BenskiBoy/scamp-32/(list of files, drawings)

Other design files:
logisim/scampplusplus.circ
