BenskiBoy/scamp-32/kicad/scamp32-memory/scamp32-memory.kicad_pcb

## KiCad design kicad/scamp32-memory/scamp32-memory.kicad_pcb (2026-10-10)

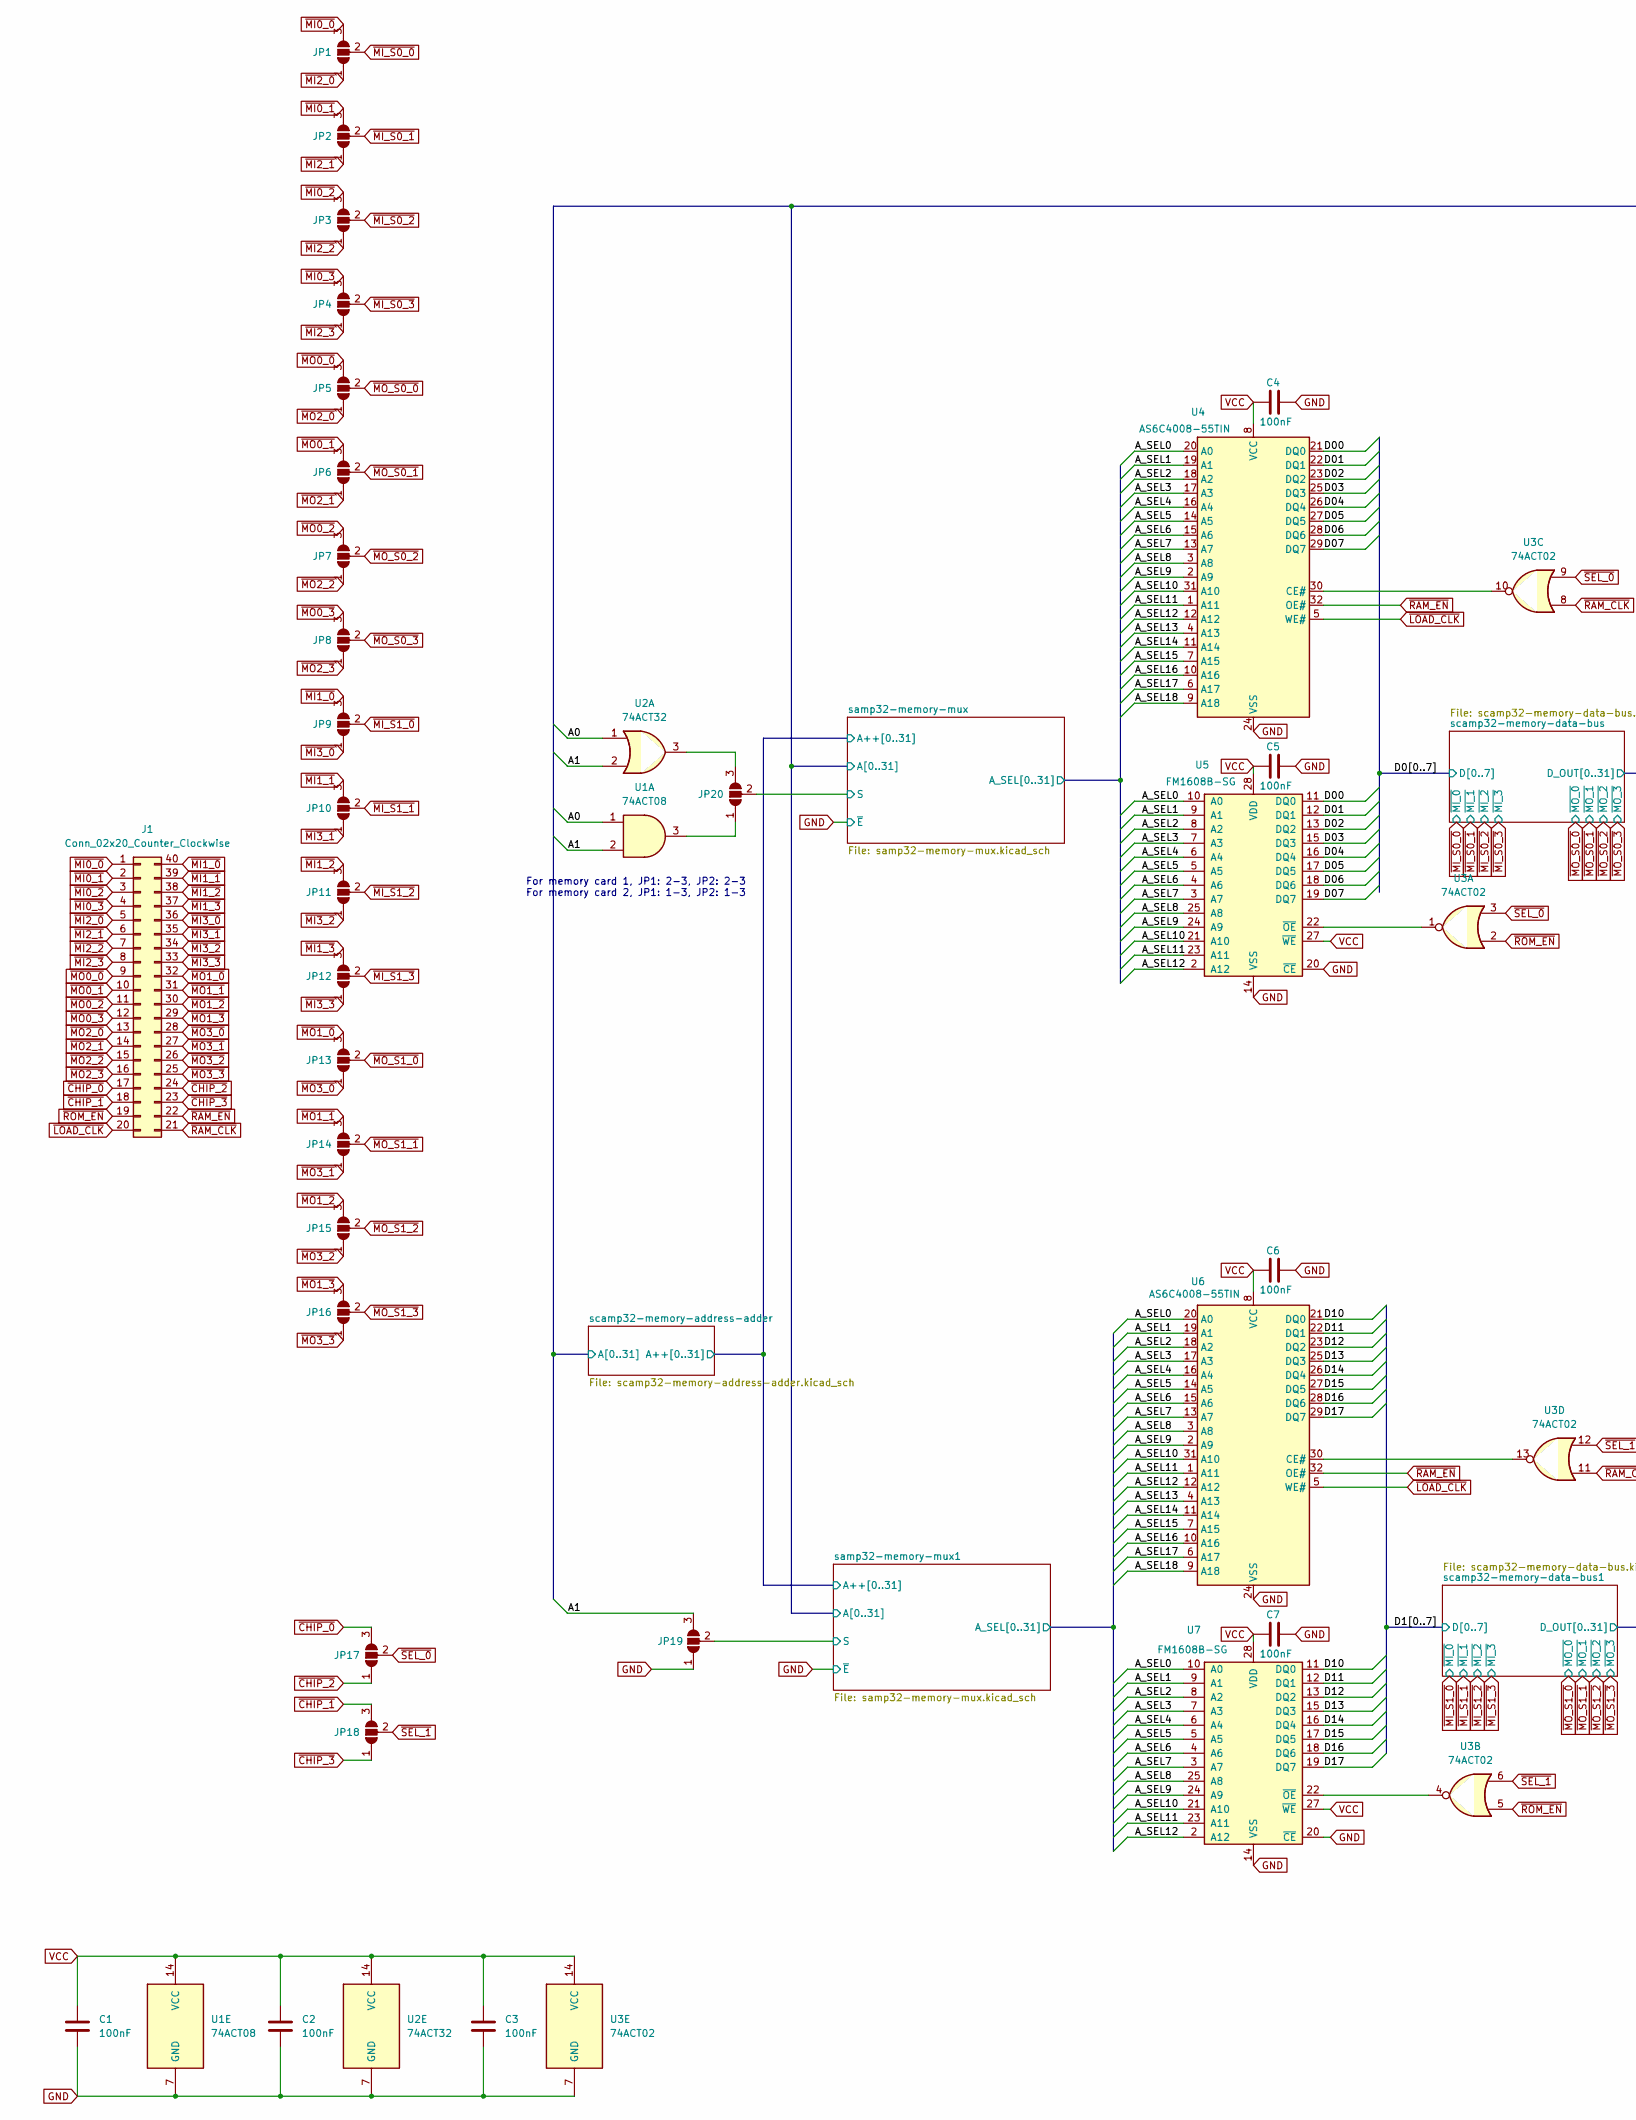
[picture p1: schematic scamp32-memory.kicad_sch, part in row 1, column 1]

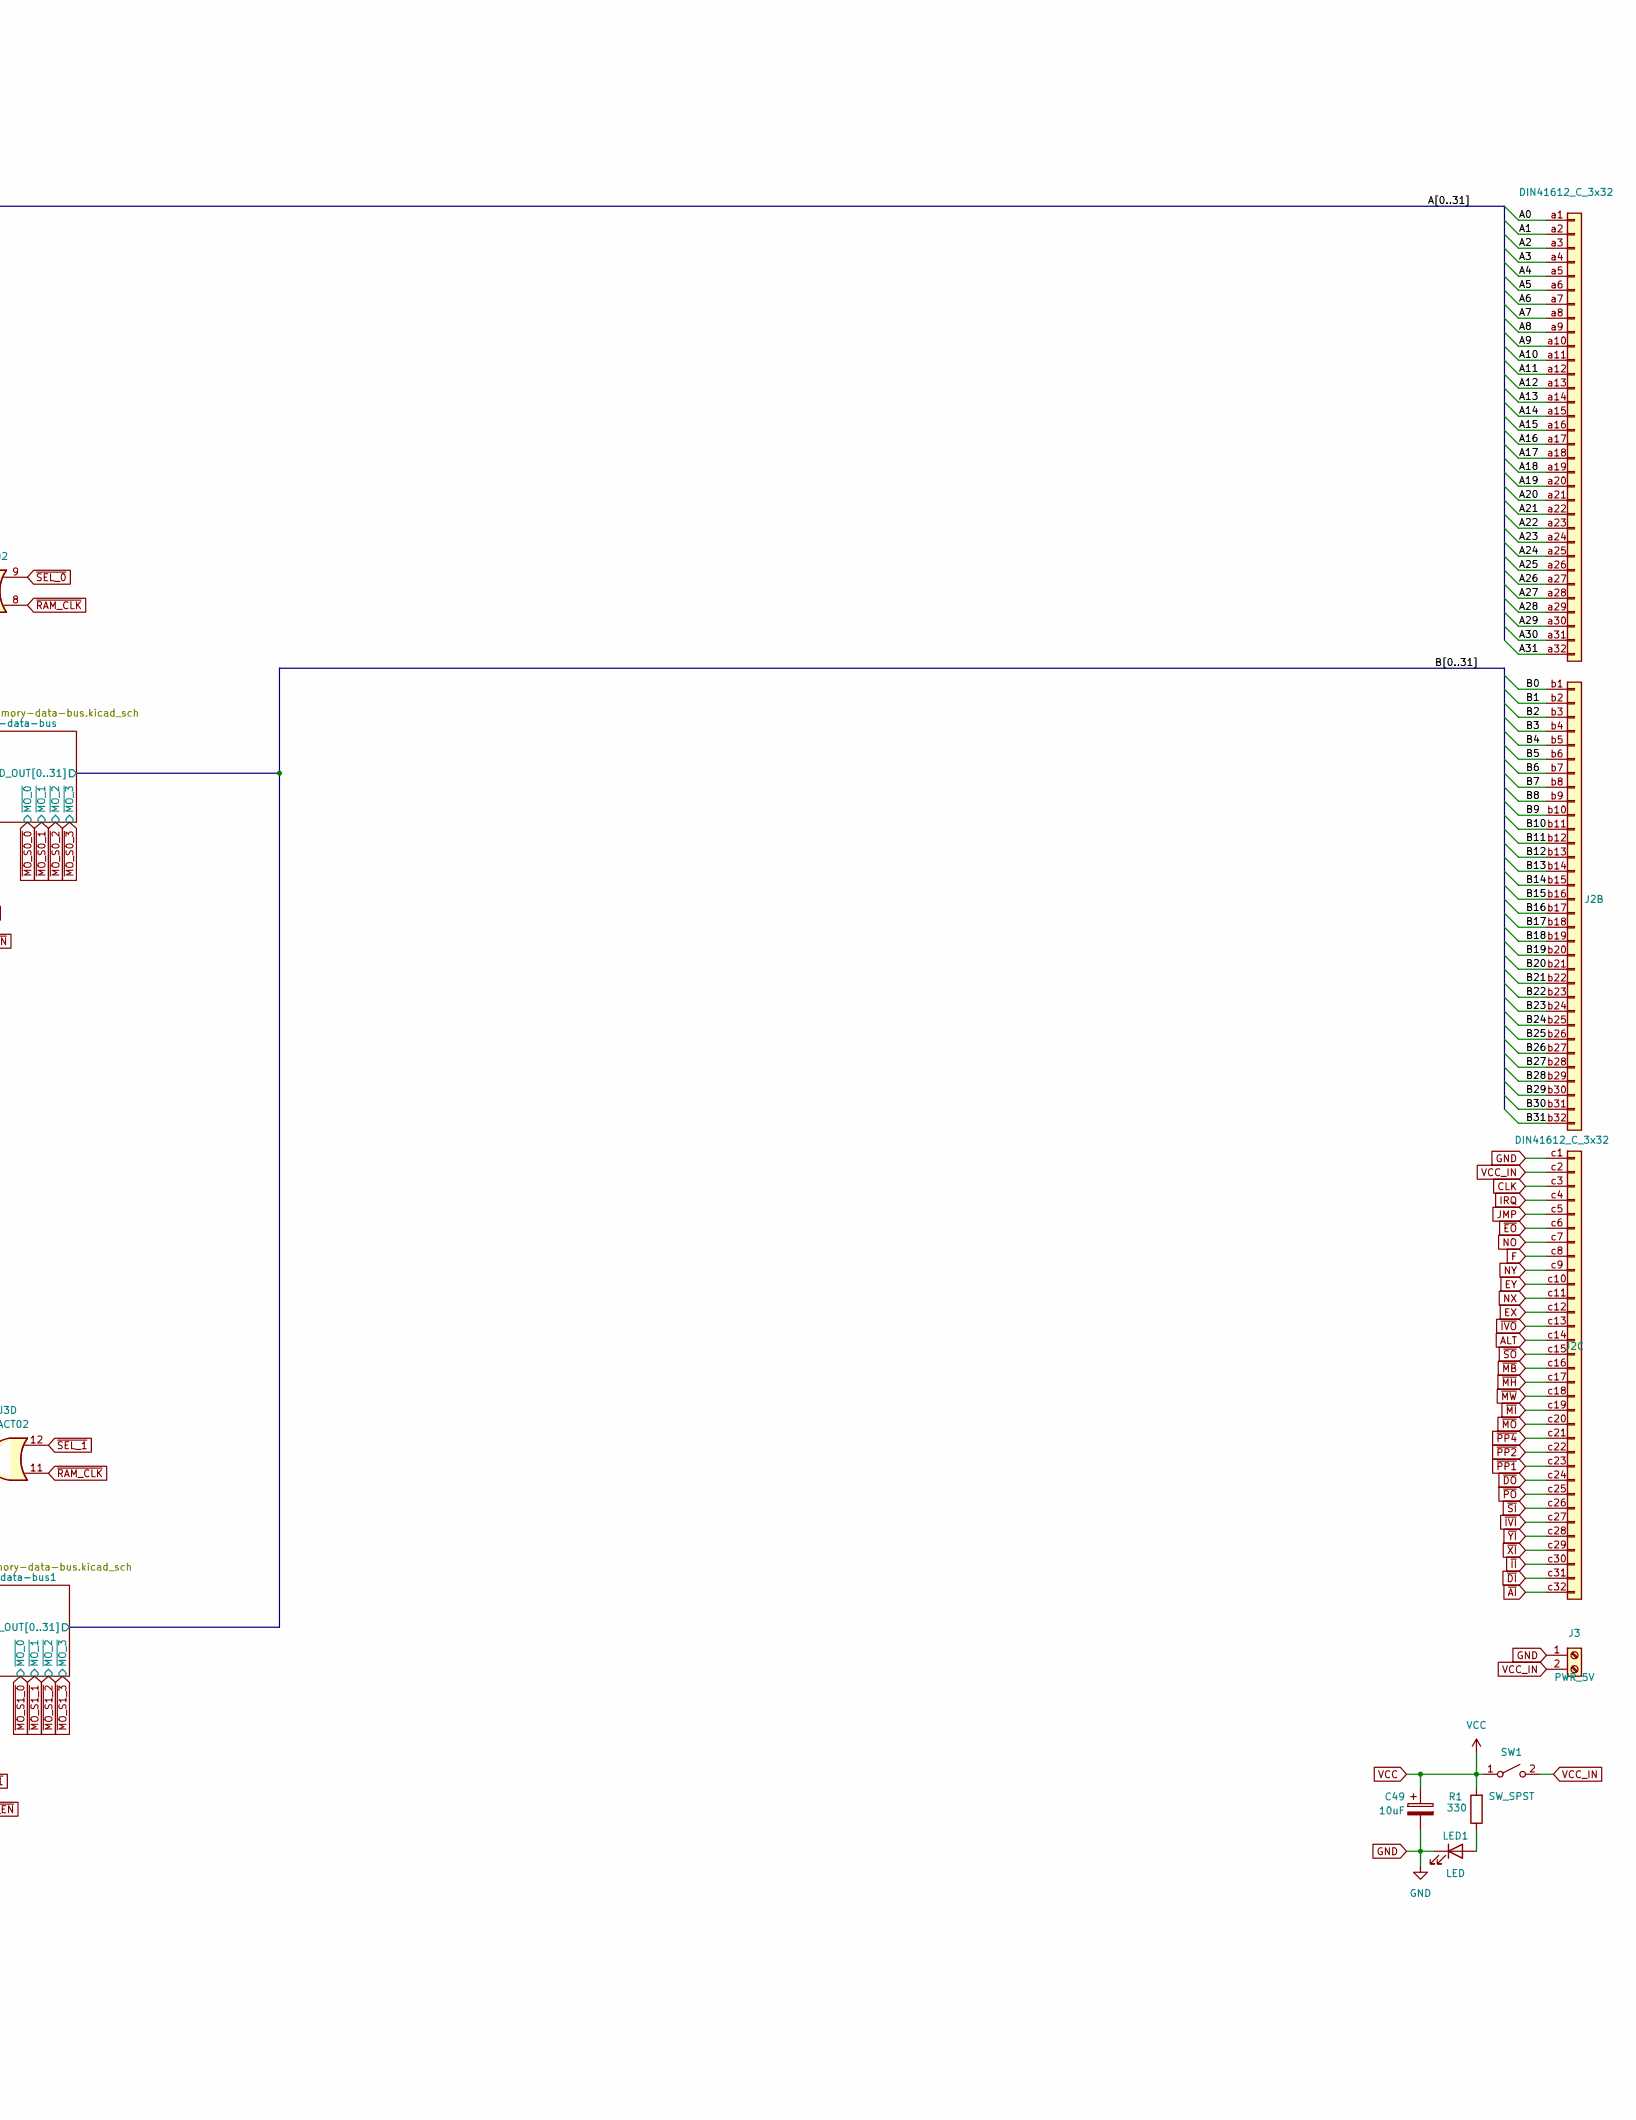
[picture p2: schematic scamp32-memory.kicad_sch, part in row 1, column 2]

Parts:
C1, C2, C3, C4, C5, C6, C7: 100nF; C_0603_1608Metric
C49: 10uF; CP_Radial_D5.0mm_P2.00mm
J1: Conn_02x20_Counter_Clockwise; IDC-Header_2x20_P2.54mm_Horizontal
J2: DIN41612_C_3x32; DIN41612_C_3x32_Male_Horizontal_THT
J3: PWR_5V; TerminalBlock_Phoenix_MKDS-1,5-2-5.08_1x02_P5.08mm_Horizont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
JP1, JP2, JP3, JP4, JP5, JP6, JP7, JP8, JP9, JP10, JP11, JP12, JP13, JP14, JP15, JP16, JP17, JP18, JP19, JP20: SolderJumper_3_Open; SolderJumper-3_P1.3mm_Open_RoundedPad1.0x1.5mm_NumberLabels
LED1: LED; LED_0805_2012Metric
R1: 330; R_0805_2012Metric
SW1: SW_SPST; SW_Slide_SPDT_Straight_CK_OS102011MS2Q
U1: 74ACT08; TSSOP-14_4.4x5mm_P0.65mm
U2: 74ACT32; SOIC-14_3.9x8.7mm_P1.27mm
U3: 74ACT02; TSSOP-14_4.4x5mm_P0.65mm
U4, U6: AS6C4008-55TIN; TSOP-I-32_18.4x8mm_P0.5mm
U5, U7: FM1608B-SG; DIP_Socket-28_W11.9mm_W12.7mm_W15.24mm_W17.78mm_W18.5mm_3M_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

Connections:
/A0: J2.a1, U1.1, U2.1; also elsewhere on the board
/A1: J2.a2, JP19.3 (B), U1.2, U2.2; also elsewhere on the board
/A2: J2.a3; also elsewhere on the board
/A3: J2.a4; also elsewhere on the board
/A4: J2.a5; also elsewhere on the board
/A5: J2.a6; also elsewhere on the board
/A6: J2.a7; also elsewhere on the board
/A7: J2.a8; also elsewhere on the board
/A8: J2.a9; also elsewhere on the board
/A9: J2.a10; also elsewhere on the board
/A10: J2.a11; also elsewhere on the board
/A11: J2.a12; also elsewhere on the board
/A12: J2.a13; also elsewhere on the board
/A13: J2.a14; also elsewhere on the board
/A14: J2.a15; also elsewhere on the board
/A15: J2.a16; also elsewhere on the board
/A16: J2.a17; also elsewhere on the board
/A17: J2.a18; also elsewhere on the board
/A18: J2.a19; also elsewhere on the board
/A19: J2.a20; also elsewhere on the board
/A20: J2.a21; also elsewhere on the board
/A21: J2.a22; also elsewhere on the board
/A22: J2.a23; also elsewhere on the board
/A23: J2.a24; also elsewhere on the board
/A24: J2.a25; also elsewhere on the board
/A25: J2.a26; also elsewhere on the board
/A26: J2.a27; also elsewhere on the board
/A27: J2.a28; also elsewhere on the board
/A28: J2.a29; also elsewhere on the board
/A29: J2.a30; also elsewhere on the board
/A30: J2.a31; also elsewhere on the board
/A31: J2.a32; also elsewhere on the board
/B0: J2.b1; also elsewhere on the board
/B1: J2.b2; also elsewhere on the board
/B2: J2.b3; also elsewhere on the board
/B3: J2.b4; also elsewhere on the board
/B4: J2.b5; also elsewhere on the board
/B5: J2.b6; also elsewhere on the board
/B6: J2.b7; also elsewhere on the board
/B7: J2.b8; also elsewhere on the board
/B8: J2.b9; also elsewhere on the board
/B9: J2.b10; also elsewhere on the board
/B10: J2.b11; also elsewhere on the board
/B11: J2.b12; also elsewhere on the board
/B12: J2.b13; also elsewhere on the board
/B13: J2.b14; also elsewhere on the board
/B14: J2.b15; also elsewhere on the board
/B15: J2.b16; also elsewhere on the board
/B16: J2.b17; also elsewhere on the board
/B17: J2.b18; also elsewhere on the board
/B18: J2.b19; also elsewhere on the board
/B19: J2.b20; also elsewhere on the board
/B20: J2.b21; also elsewhere on the board
/B21: J2.b22; also elsewhere on the board
/B22: J2.b23; also elsewhere on the board
/B23: J2.b24; also elsewhere on the board
/B24: J2.b25; also elsewhere on the board
/B25: J2.b26; also elsewhere on the board
/B26: J2.b27; also elsewhere on the board
/B27: J2.b28; also elsewhere on the board
/B28: J2.b29; also elsewhere on the board
/B29: J2.b30; also elsewhere on the board
/B30: J2.b31; also elsewhere on the board
/B31: J2.b32; also elsewhere on the board
/D00: U4.21 (DQ0), U5.11 (DQ0); also elsewhere on the board
/D01: U4.22 (DQ1), U5.12 (DQ1); also elsewhere on the board
/D02: U4.23 (DQ2), U5.13 (DQ2); also elsewhere on the board
/D03: U4.25 (DQ3), U5.15 (DQ3); also elsewhere on the board
/D04: U4.26 (DQ4), U5.16 (DQ4); also elsewhere on the board
/D05: U4.27 (DQ5), U5.17 (DQ5); also elsewhere on the board
/D06: U4.28 (DQ6), U5.18 (DQ6); also elsewhere on the board
/D07: U4.29 (DQ7), U5.19 (DQ7); also elsewhere on the board
/D10: U6.21 (DQ0), U7.11 (DQ0); also elsewhere on the board
/D11: U6.22 (DQ1), U7.12 (DQ1); also elsewhere on the board
/D12: U6.23 (DQ2), U7.13 (DQ2); also elsewhere on the board
/D13: U6.25 (DQ3), U7.15 (DQ3); also elsewhere on the board
/D14: U6.26 (DQ4), U7.16 (DQ4); also elsewhere on the board
/D15: U6.27 (DQ5), U7.17 (DQ5); also elsewhere on the board
/D16: U6.28 (DQ6), U7.18 (DQ6); also elsewhere on the board
/D17: U6.29 (DQ7), U7.19 (DQ7); also elsewhere on the board
/samp32-memory-mux1/S: JP19.2 (C); also elsewhere on the board
/samp32-memory-mux/A_SEL0: U4.20 (A0), U5.10 (A0), U6.20 (A0), U7.10 (A0); also elsewhere on the board
/samp32-memory-mux/A_SEL1: U4.19 (A1), U5.9 (A1), U6.19 (A1), U7.9 (A1); also elsewhere on the board
/samp32-memory-mux/A_SEL2: U4.18 (A2), U5.8 (A2), U6.18 (A2), U7.8 (A2); also elsewhere on the board
/samp32-memory-mux/A_SEL3: U4.17 (A3), U5.7 (A3), U6.17 (A3), U7.7 (A3); also elsewhere on the board
/samp32-memory-mux/A_SEL4: U4.16 (A4), U5.6 (A4), U6.16 (A4), U7.6 (A4); also elsewhere on the board
/samp32-memory-mux/A_SEL5: U4.14 (A5), U5.5 (A5), U6.14 (A5), U7.5 (A5); also elsewhere on the board
/samp32-memory-mux/A_SEL6: U4.15 (A6), U5.4 (A6), U6.15 (A6), U7.4 (A6); also elsewhere on the board
/samp32-memory-mux/A_SEL7: U4.13 (A7), U5.3 (A7), U6.13 (A7), U7.3 (A7); also elsewhere on the board
/samp32-memory-mux/A_SEL8: U4.3 (A8), U5.25 (A8), U6.3 (A8), U7.25 (A8); also elsewhere on the board
/samp32-memory-mux/A_SEL9: U4.2 (A9), U5.24 (A9), U6.2 (A9), U7.24 (A9); also elsewhere on the board
/samp32-memory-mux/A_SEL10: U4.31 (A10), U5.21 (A10), U6.31 (A10), U7.21 (A10); also elsewhere on the board
/samp32-memory-mux/A_SEL11: U4.1 (A11), U5.23 (A11), U6.1 (A11), U7.23 (A11); also elsewhere on the board
/samp32-memory-mux/A_SEL12: U4.12 (A12), U5.2 (A12), U6.12 (A12), U7.2 (A12); also elsewhere on the board
/samp32-memory-mux/A_SEL13: U4.4 (A13), U6.4 (A13); also elsewhere on the board
/samp32-memory-mux/A_SEL14: U4.11 (A14), U6.11 (A14); also elsewhere on the board
/samp32-memory-mux/A_SEL15: U4.7 (A15), U6.7 (A15); also elsewhere on the board
/samp32-memory-mux/A_SEL16: U4.10 (A16), U6.10 (A16); also elsewhere on the board
/samp32-memory-mux/A_SEL17: U4.6 (A17), U6.6 (A17); also elsewhere on the board
/samp32-memory-mux/A_SEL18: U4.9 (A18), U6.9 (A18); also elsewhere on the board
/samp32-memory-mux/S: JP20.2 (C); also elsewhere on the board
ALT: J2.c14
CLK: J2.c3
EX: J2.c12
EY: J2.c10
F: J2.c8
GND: C1.2, C2.2, C3.2, C4.2, C5.2, C6.2, C7.2, C49.2, J2.c1, J3.1, JP19.1 (A), LED1.1 (K), U1.7 (GND), U2.7 (GND), U3.7 (GND), U4.24 (VSS), U5.14 (VSS), U5.20 (~CE), U6.24 (VSS), U7.14 (VSS), U7.20 (~CE); also elsewhere on the board
IRQ: J2.c4
JMP: J2.c5
NO: J2.c7
NX: J2.c11
NY: J2.c9
unnamed: JP20.1 (A), U1.3
unnamed: JP20.3 (B), U2.3
unnamed: LED1.2 (A), R1.1
unnamed: U3.10, U4.30 (CE#)
unnamed: U3.1, U5.22 (~OE)
unnamed: U3.13, U6.30 (CE#)
unnamed: U3.4, U7.22 (~OE)
VCC: C1.1, C2.1, C3.1, C4.1, C5.1, C6.1, C7.1, C49.1, R1.2, SW1.1 (A), U1.14 (VCC), U2.14 (VCC), U3.14 (VCC), U4.8 (VCC), U5.27 (~WE), U5.28 (VDD), U6.8 (VCC), U7.27 (~WE), U7.28 (VDD); also elsewhere on the board
VCC_IN: J2.c2, J3.2, SW1.2 (B)
~AI: J2.c32
~CHIP_0: J1.17, JP17.3 (B)
~CHIP_1: J1.18, JP18.3 (B)
~CHIP_2: J1.24, JP17.1 (A)
~CHIP_3: J1.23, JP18.1 (A)
~DI: J2.c31
~DO: J2.c24
~EO: J2.c6
~II: J2.c30
~IVI: J2.c27
~IVO: J2.c13
~LOAD_CLK: J1.20, U4.5 (WE#), U6.5 (WE#)
~MB: J2.c16
~MH: J2.c17
~MI0_0: J1.1, JP1.3 (B)
~MI0_1: J1.2, JP2.3 (B)
~MI0_2: J1.3, JP3.3 (B)
~MI0_3: J1.4, JP4.3 (B)
~MI1_0: J1.40, JP9.3 (B)
~MI1_1: J1.39, JP10.3 (B)
~MI1_2: J1.38, JP11.3 (B)
~MI1_3: J1.37, JP12.3 (B)
~MI2_0: J1.5, JP1.1 (A)
~MI2_1: J1.6, JP2.1 (A)
~MI2_2: J1.7, JP3.1 (A)
~MI2_3: J1.8, JP4.1 (A)
~MI3_0: J1.36, JP9.1 (A)
~MI3_1: J1.35, JP10.1 (A)
~MI3_2: J1.34, JP11.1 (A)
~MI3_3: J1.33, JP12.1 (A)
~MI_S0_0: JP1.2 (C); also elsewhere on the board
~MI_S0_1: JP2.2 (C); also elsewhere on the board
~MI_S0_2: JP3.2 (C); also elsewhere on the board
~MI_S0_3: JP4.2 (C); also elsewhere on the board
~MI_S1_0: JP9.2 (C); also elsewhere on the board
~MI_S1_1: JP10.2 (C); also elsewhere on the board
~MI_S1_2: JP11.2 (C); also elsewhere on the board
~MI_S1_3: JP12.2 (C); also elsewhere on the board
~MI: J2.c19
~MO0_0: J1.9, JP5.3 (B)
~MO0_1: J1.10, JP6.3 (B)
~MO0_2: J1.11, JP7.3 (B)
~MO0_3: J1.12, JP8.3 (B)
~MO1_0: J1.32, JP13.3 (B)
~MO1_1: J1.31, JP14.3 (B)
~MO1_2: J1.30, JP15.3 (B)
~MO1_3: J1.29, JP16.3 (B)
~MO2_0: J1.13, JP5.1 (A)
~MO2_1: J1.14, JP6.1 (A)
~MO2_2: J1.15, JP7.1 (A)
~MO2_3: J1.16, JP8.1 (A)
~MO3_0: J1.28, JP13.1 (A)
~MO3_1: J1.27, JP14.1 (A)
~MO3_2: J1.26, JP15.1 (A)
~MO3_3: J1.25, JP16.1 (A)
~MO_S0_0: JP5.2 (C); also elsewhere on the board
~MO_S0_1: JP6.2 (C); also elsewhere on the board
~MO_S0_2: JP7.2 (C); also elsewhere on the board
~MO_S0_3: JP8.2 (C); also elsewhere on the board
~MO_S1_0: JP13.2 (C); also elsewhere on the board
~MO_S1_1: JP14.2 (C); also elsewhere on the board
~MO_S1_2: JP15.2 (C); also elsewhere on the board
~MO_S1_3: JP16.2 (C); also elsewhere on the board
~MO: J2.c20
~MW: J2.c18
~PO: J2.c25
~PP1: J2.c23
~PP2: J2.c22
~PP4: J2.c21
~RAM_CLK: J1.21, U3.8, U3.11
~RAM_EN: J1.22, U4.32 (OE#), U6.32 (OE#)
~ROM_EN: J1.19, U3.2, U3.5
~SEL_0: JP17.2 (C), U3.3, U3.9
~SEL_1: JP18.2 (C), U3.6, U3.12
~SI: J2.c26
~SO: J2.c15
~XI: J2.c29
~YI: J2.c28

Notes on the sheet:
For memory card 1, JP1: 2-3, JP2: 2-3 For memory card 2, JP1: 1-3, JP2: 1-3

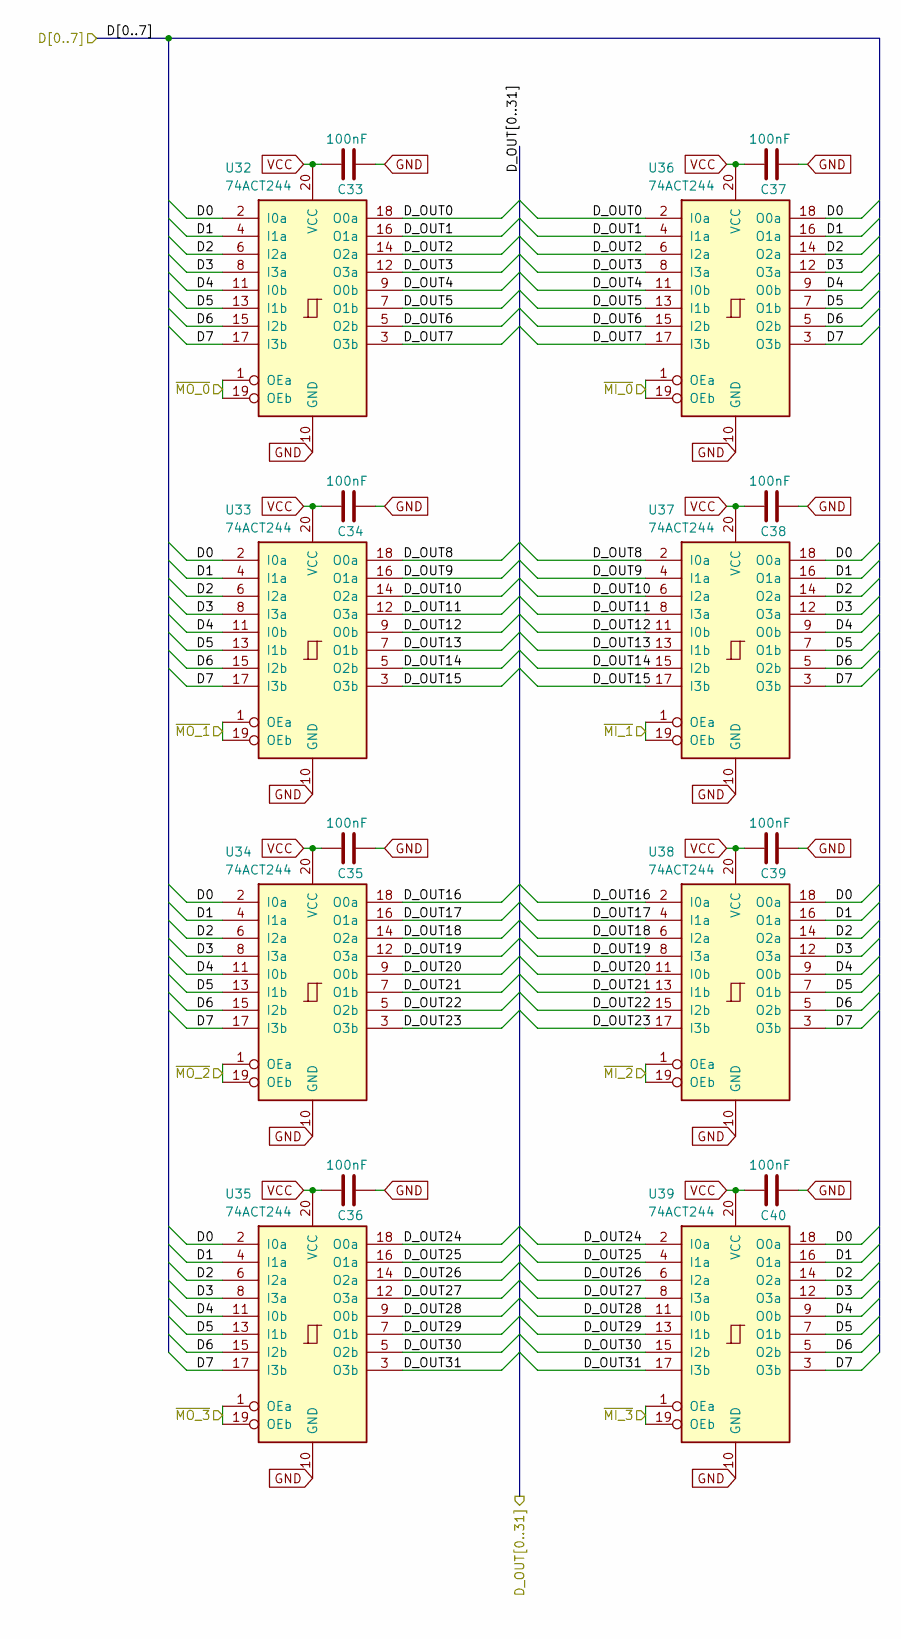
[picture p3: schematic scamp32-memory-data-bus.kicad_sch]

Parts:
C33, C34, C35, C36, C37, C38, C39, C40: 100nF; C_0603_1608Metric
U32, U33, U34, U35, U36, U37, U38, U39: 74ACT244; Texas_PW0020A_TSSOP-20_4.4x6.5mm_P0.65mm

Connections:
/B0: U32.18 (O0a), U36.2 (I0a); also elsewhere on the board
/B1: U32.16 (O1a), U36.4 (I1a); also elsewhere on the board
/B2: U32.14 (O2a), U36.6 (I2a); also elsewhere on the board
/B3: U32.12 (O3a), U36.8 (I3a); also elsewhere on the board
/B4: U32.9 (O0b), U36.11 (I0b); also elsewhere on the board
/B5: U32.7 (O1b), U36.13 (I1b); also elsewhere on the board
/B6: U32.5 (O2b), U36.15 (I2b); also elsewhere on the board
/B7: U32.3 (O3b), U36.17 (I3b); also elsewhere on the board
/B8: U33.18 (O0a), U37.2 (I0a); also elsewhere on the board
/B9: U33.16 (O1a), U37.4 (I1a); also elsewhere on the board
/B10: U33.14 (O2a), U37.6 (I2a); also elsewhere on the board
/B11: U33.12 (O3a), U37.8 (I3a); also elsewhere on the board
/B12: U33.9 (O0b), U37.11 (I0b); also elsewhere on the board
/B13: U33.7 (O1b), U37.13 (I1b); also elsewhere on the board
/B14: U33.5 (O2b), U37.15 (I2b); also elsewhere on the board
/B15: U33.3 (O3b), U37.17 (I3b); also elsewhere on the board
/B16: U34.18 (O0a), U38.2 (I0a); also elsewhere on the board
/B17: U34.16 (O1a), U38.4 (I1a); also elsewhere on the board
/B18: U34.14 (O2a), U38.6 (I2a); also elsewhere on the board
/B19: U34.12 (O3a), U38.8 (I3a); also elsewhere on the board
/B20: U34.9 (O0b), U38.11 (I0b); also elsewhere on the board
/B21: U34.7 (O1b), U38.13 (I1b); also elsewhere on the board
/B22: U34.5 (O2b), U38.15 (I2b); also elsewhere on the board
/B23: U34.3 (O3b), U38.17 (I3b); also elsewhere on the board
/B24: U35.18 (O0a), U39.2 (I0a); also elsewhere on the board
/B25: U35.16 (O1a), U39.4 (I1a); also elsewhere on the board
/B26: U35.14 (O2a), U39.6 (I2a); also elsewhere on the board
/B27: U35.12 (O3a), U39.8 (I3a); also elsewhere on the board
/B28: U35.9 (O0b), U39.11 (I0b); also elsewhere on the board
/B29: U35.7 (O1b), U39.13 (I1b); also elsewhere on the board
/B30: U35.5 (O2b), U39.15 (I2b); also elsewhere on the board
/B31: U35.3 (O3b), U39.17 (I3b); also elsewhere on the board
/D00: U32.2 (I0a), U33.2 (I0a), U34.2 (I0a), U35.2 (I0a), U36.18 (O0a), U37.18 (O0a), U38.18 (O0a), U39.18 (O0a); also elsewhere on the board
/D01: U32.4 (I1a), U33.4 (I1a), U34.4 (I1a), U35.4 (I1a), U36.16 (O1a), U37.16 (O1a), U38.16 (O1a), U39.16 (O1a); also elsewhere on the board
/D02: U32.6 (I2a), U33.6 (I2a), U34.6 (I2a), U35.6 (I2a), U36.14 (O2a), U37.14 (O2a), U38.14 (O2a), U39.14 (O2a); also elsewhere on the board
/D03: U32.8 (I3a), U33.8 (I3a), U34.8 (I3a), U35.8 (I3a), U36.12 (O3a), U37.12 (O3a), U38.12 (O3a), U39.12 (O3a); also elsewhere on the board
/D04: U32.11 (I0b), U33.11 (I0b), U34.11 (I0b), U35.11 (I0b), U36.9 (O0b), U37.9 (O0b), U38.9 (O0b), U39.9 (O0b); also elsewhere on the board
/D05: U32.13 (I1b), U33.13 (I1b), U34.13 (I1b), U35.13 (I1b), U36.7 (O1b), U37.7 (O1b), U38.7 (O1b), U39.7 (O1b); also elsewhere on the board
/D06: U32.15 (I2b), U33.15 (I2b), U34.15 (I2b), U35.15 (I2b), U36.5 (O2b), U37.5 (O2b), U38.5 (O2b), U39.5 (O2b); also elsewhere on the board
/D07: U32.17 (I3b), U33.17 (I3b), U34.17 (I3b), U35.17 (I3b), U36.3 (O3b), U37.3 (O3b), U38.3 (O3b), U39.3 (O3b); also elsewhere on the board
GND: C33.1, C34.1, C35.1, C36.1, C37.1, C38.1, C39.1, C40.1, U32.10 (GND), U33.10 (GND), U34.10 (GND), U35.10 (GND), U36.10 (GND), U37.10 (GND), U38.10 (GND), U39.10 (GND); also elsewhere on the board
VCC: C33.2, C34.2, C35.2, C36.2, C37.2, C38.2, C39.2, C40.2, U32.20 (VCC), U33.20 (VCC), U34.20 (VCC), U35.20 (VCC), U36.20 (VCC), U37.20 (VCC), U38.20 (VCC), U39.20 (VCC); also elsewhere on the board
~MI_S0_0: U36.1 (OEa), U36.19 (OEb); also elsewhere on the board
~MI_S0_1: U37.1 (OEa), U37.19 (OEb); also elsewhere on the board
~MI_S0_2: U38.1 (OEa), U38.19 (OEb); also elsewhere on the board
~MI_S0_3: U39.1 (OEa), U39.19 (OEb); also elsewhere on the board
~MO_S0_0: U32.1 (OEa), U32.19 (OEb); also elsewhere on the board
~MO_S0_1: U33.1 (OEa), U33.19 (OEb); also elsewhere on the board
~MO_S0_2: U34.1 (OEa), U34.19 (OEb); also elsewhere on the board
~MO_S0_3: U35.1 (OEa), U35.19 (OEb); also elsewhere on the board

Parts of its further copies:
C41, C42, C43, C44, C45, C46, C47, C48: 100nF; C_0603_1608Metric
U40, U41, U42, U43, U44, U45, U46, U47: 74ACT244; Texas_PW0020A_TSSOP-20_4.4x6.5mm_P0.65mm

Connections of its further copies:
/B0: U40.18 (O0a), U44.2 (I0a); also elsewhere on the board
/B1: U40.16 (O1a), U44.4 (I1a); also elsewhere on the board
/B2: U40.14 (O2a), U44.6 (I2a); also elsewhere on the board
/B3: U40.12 (O3a), U44.8 (I3a); also elsewhere on the board
/B4: U40.9 (O0b), U44.11 (I0b); also elsewhere on the board
/B5: U40.7 (O1b), U44.13 (I1b); also elsewhere on the board
/B6: U40.5 (O2b), U44.15 (I2b); also elsewhere on the board
/B7: U40.3 (O3b), U44.17 (I3b); also elsewhere on the board
/B8: U41.18 (O0a), U45.2 (I0a); also elsewhere on the board
/B9: U41.16 (O1a), U45.4 (I1a); also elsewhere on the board
/B10: U41.14 (O2a), U45.6 (I2a); also elsewhere on the board
/B11: U41.12 (O3a), U45.8 (I3a); also elsewhere on the board
/B12: U41.9 (O0b), U45.11 (I0b); also elsewhere on the board
/B13: U41.7 (O1b), U45.13 (I1b); also elsewhere on the board
/B14: U41.5 (O2b), U45.15 (I2b); also elsewhere on the board
/B15: U41.3 (O3b), U45.17 (I3b); also elsewhere on the board
/B16: U42.18 (O0a), U46.2 (I0a); also elsewhere on the board
/B17: U42.16 (O1a), U46.4 (I1a); also elsewhere on the board
/B18: U42.14 (O2a), U46.6 (I2a); also elsewhere on the board
/B19: U42.12 (O3a), U46.8 (I3a); also elsewhere on the board
/B20: U42.9 (O0b), U46.11 (I0b); also elsewhere on the board
/B21: U42.7 (O1b), U46.13 (I1b); also elsewhere on the board
/B22: U42.5 (O2b), U46.15 (I2b); also elsewhere on the board
/B23: U42.3 (O3b), U46.17 (I3b); also elsewhere on the board
/B24: U43.18 (O0a), U47.2 (I0a); also elsewhere on the board
/B25: U43.16 (O1a), U47.4 (I1a); also elsewhere on the board
/B26: U43.14 (O2a), U47.6 (I2a); also elsewhere on the board
/B27: U43.12 (O3a), U47.8 (I3a); also elsewhere on the board
/B28: U43.9 (O0b), U47.11 (I0b); also elsewhere on the board
/B29: U43.7 (O1b), U47.13 (I1b); also elsewhere on the board
/B30: U43.5 (O2b), U47.15 (I2b); also elsewhere on the board
/B31: U43.3 (O3b), U47.17 (I3b); also elsewhere on the board
/D10: U40.2 (I0a), U41.2 (I0a), U42.2 (I0a), U43.2 (I0a), U44.18 (O0a), U45.18 (O0a), U46.18 (O0a), U47.18 (O0a); also elsewhere on the board
/D11: U40.4 (I1a), U41.4 (I1a), U42.4 (I1a), U43.4 (I1a), U44.16 (O1a), U45.16 (O1a), U46.16 (O1a), U47.16 (O1a); also elsewhere on the board
/D12: U40.6 (I2a), U41.6 (I2a), U42.6 (I2a), U43.6 (I2a), U44.14 (O2a), U45.14 (O2a), U46.14 (O2a), U47.14 (O2a); also elsewhere on the board
/D13: U40.8 (I3a), U41.8 (I3a), U42.8 (I3a), U43.8 (I3a), U44.12 (O3a), U45.12 (O3a), U46.12 (O3a), U47.12 (O3a); also elsewhere on the board
/D14: U40.11 (I0b), U41.11 (I0b), U42.11 (I0b), U43.11 (I0b), U44.9 (O0b), U45.9 (O0b), U46.9 (O0b), U47.9 (O0b); also elsewhere on the board
/D15: U40.13 (I1b), U41.13 (I1b), U42.13 (I1b), U43.13 (I1b), U44.7 (O1b), U45.7 (O1b), U46.7 (O1b), U47.7 (O1b); also elsewhere on the board
/D16: U40.15 (I2b), U41.15 (I2b), U42.15 (I2b), U43.15 (I2b), U44.5 (O2b), U45.5 (O2b), U46.5 (O2b), U47.5 (O2b); also elsewhere on the board
/D17: U40.17 (I3b), U41.17 (I3b), U42.17 (I3b), U43.17 (I3b), U44.3 (O3b), U45.3 (O3b), U46.3 (O3b), U47.3 (O3b); also elsewhere on the board
GND: C41.1, C42.1, C43.1, C44.1, C45.1, C46.1, C47.1, C48.1, U40.10 (GND), U41.10 (GND), U42.10 (GND), U43.10 (GND), U44.10 (GND), U45.10 (GND), U46.10 (GND), U47.10 (GND); also elsewhere on the board
VCC: C41.2, C42.2, C43.2, C44.2, C45.2, C46.2, C47.2, C48.2, U40.20 (VCC), U41.20 (VCC), U42.20 (VCC), U43.20 (VCC), U44.20 (VCC), U45.20 (VCC), U46.20 (VCC), U47.20 (VCC); also elsewhere on the board
~MI_S1_0: U44.1 (OEa), U44.19 (OEb); also elsewhere on the board
~MI_S1_1: U45.1 (OEa), U45.19 (OEb); also elsewhere on the board
~MI_S1_2: U46.1 (OEa), U46.19 (OEb); also elsewhere on the board
~MI_S1_3: U47.1 (OEa), U47.19 (OEb); also elsewhere on the board
~MO_S1_0: U40.1 (OEa), U40.19 (OEb); also elsewhere on the board
~MO_S1_1: U41.1 (OEa), U41.19 (OEb); also elsewhere on the board
~MO_S1_2: U42.1 (OEa), U42.19 (OEb); also elsewhere on the board
~MO_S1_3: U43.1 (OEa), U43.19 (OEb); also elsewhere on the board
