BenskiBoy/scamp-32/kicad/scamp32-memory/scamp32-memory.kicad_pcb

## KiCad design kicad/scamp32-memory/scamp32-memory.kicad_pcb (continued)

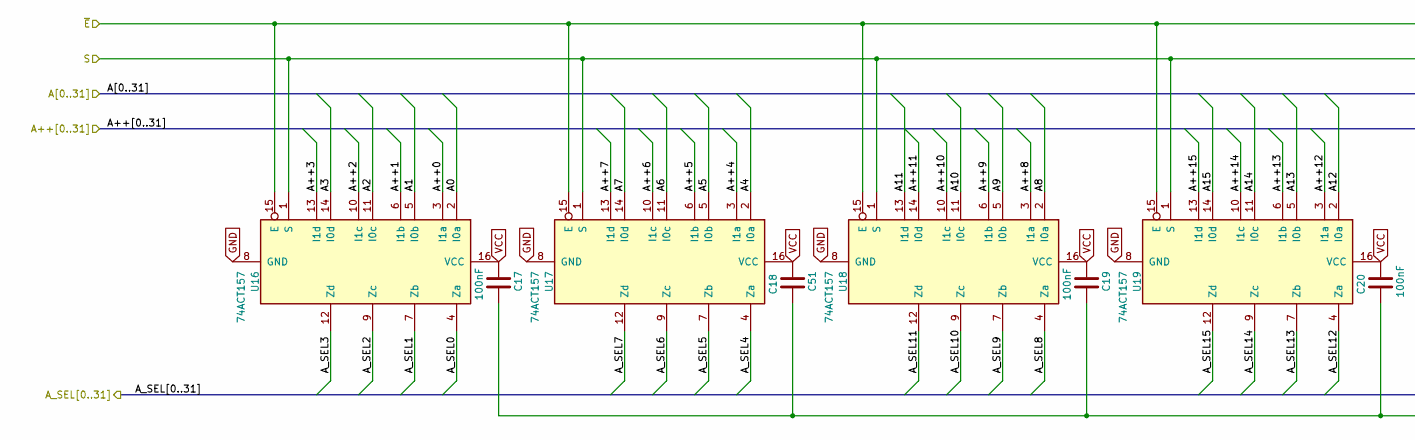
[picture p4: schematic samp32-memory-mux.kicad_sch, part in row 1, column 1]

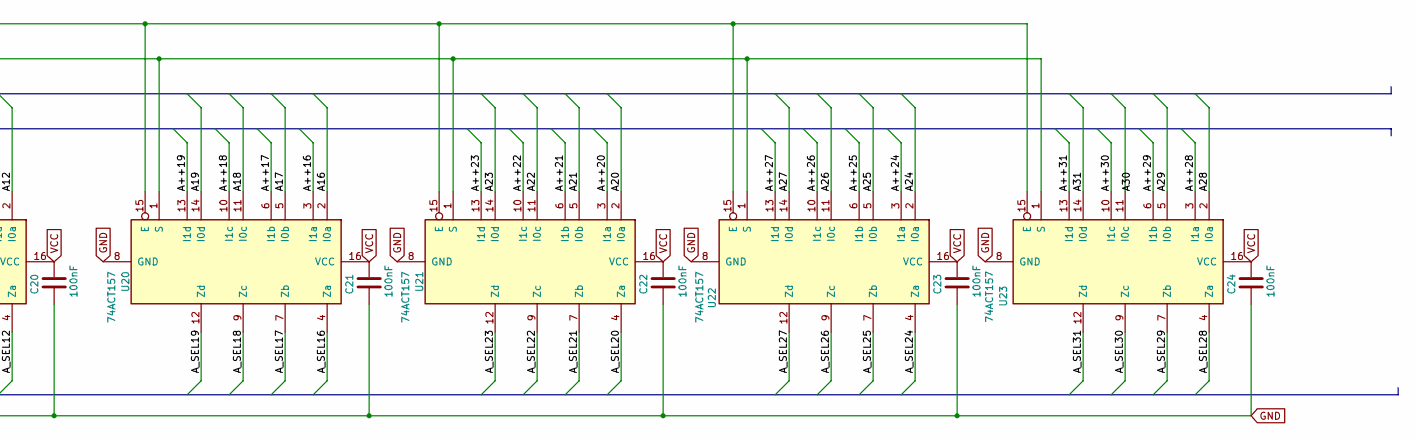
[picture p5: schematic samp32-memory-mux.kicad_sch, part in row 1, column 2]

Parts:
C17, C19, C20, C21, C22, C23, C24: 100nF; C_0603_1608Metric
C18: C51; C_0603_1608Metric
U16, U17, U18, U19, U20, U21, U22, U23: 74ACT157; TSSOP-16_4.4x5mm_P0.65mm

Connections:
/A0: U16.2 (I0a); also elsewhere on the board
/A1: U16.5 (I0b); also elsewhere on the board
/A2: U16.11 (I0c); also elsewhere on the board
/A3: U16.14 (I0d); also elsewhere on the board
/A4: U17.2 (I0a); also elsewhere on the board
/A5: U17.5 (I0b); also elsewhere on the board
/A6: U17.11 (I0c); also elsewhere on the board
/A7: U17.14 (I0d); also elsewhere on the board
/A8: U18.2 (I0a); also elsewhere on the board
/A9: U18.5 (I0b); also elsewhere on the board
/A10: U18.11 (I0c); also elsewhere on the board
/A11: U18.13 (I1d); also elsewhere on the board
/A12: U19.2 (I0a); also elsewhere on the board
/A13: U19.5 (I0b); also elsewhere on the board
/A14: U19.11 (I0c); also elsewhere on the board
/A15: U19.14 (I0d); also elsewhere on the board
/A16: U20.2 (I0a); also elsewhere on the board
/A17: U20.5 (I0b); also elsewhere on the board
/A18: U20.11 (I0c); also elsewhere on the board
/A19: U20.14 (I0d); also elsewhere on the board
/A20: U21.2 (I0a); also elsewhere on the board
/A21: U21.5 (I0b); also elsewhere on the board
/A22: U21.11 (I0c); also elsewhere on the board
/A23: U21.14 (I0d); also elsewhere on the board
/A24: U22.2 (I0a); also elsewhere on the board
/A25: U22.5 (I0b); also elsewhere on the board
/A26: U22.11 (I0c); also elsewhere on the board
/A27: U22.14 (I0d); also elsewhere on the board
/A28: U23.2 (I0a); also elsewhere on the board
/A29: U23.5 (I0b); also elsewhere on the board
/A31: U23.14 (I0d); also elsewhere on the board
/samp32-memory-mux/A++0: U16.3 (I1a); also elsewhere on the board
/samp32-memory-mux/A++1: U16.6 (I1b); also elsewhere on the board
/samp32-memory-mux/A++2: U16.10 (I1c); also elsewhere on the board
/samp32-memory-mux/A++3: U16.13 (I1d); also elsewhere on the board
/samp32-memory-mux/A++4: U17.3 (I1a); also elsewhere on the board
/samp32-memory-mux/A++5: U17.6 (I1b); also elsewhere on the board
/samp32-memory-mux/A++6: U17.10 (I1c); also elsewhere on the board
/samp32-memory-mux/A++7: U17.13 (I1d); also elsewhere on the board
/samp32-memory-mux/A++8: U18.3 (I1a); also elsewhere on the board
/samp32-memory-mux/A++9: U18.6 (I1b); also elsewhere on the board
/samp32-memory-mux/A++10: U18.10 (I1c); also elsewhere on the board
/samp32-memory-mux/A++11: U18.14 (I0d); also elsewhere on the board
/samp32-memory-mux/A++12: U19.3 (I1a); also elsewhere on the board
/samp32-memory-mux/A++13: U19.6 (I1b); also elsewhere on the board
/samp32-memory-mux/A++14: U19.10 (I1c); also elsewhere on the board
/samp32-memory-mux/A++15: U19.13 (I1d); also elsewhere on the board
/samp32-memory-mux/A++16: U20.3 (I1a); also elsewhere on the board
/samp32-memory-mux/A++17: U20.6 (I1b); also elsewhere on the board
/samp32-memory-mux/A++18: U20.10 (I1c); also elsewhere on the board
/samp32-memory-mux/A++19: U20.13 (I1d); also elsewhere on the board
/samp32-memory-mux/A++20: U21.3 (I1a); also elsewhere on the board
/samp32-memory-mux/A++21: U21.6 (I1b); also elsewhere on the board
/samp32-memory-mux/A++22: U21.10 (I1c); also elsewhere on the board
/samp32-memory-mux/A++23: U21.13 (I1d); also elsewhere on the board
/samp32-memory-mux/A++24: U22.3 (I1a); also elsewhere on the board
/samp32-memory-mux/A++25: U22.6 (I1b); also elsewhere on the board
/samp32-memory-mux/A++26: U22.10 (I1c); also elsewhere on the board
/samp32-memory-mux/A++27: U22.13 (I1d); also elsewhere on the board
/samp32-memory-mux/A++28: U23.3 (I1a); also elsewhere on the board
/samp32-memory-mux/A++29: U23.6 (I1b); also elsewhere on the board
/samp32-memory-mux/A++30: U23.10 (I1c); also elsewhere on the board
/samp32-memory-mux/A++31: U23.13 (I1d); also elsewhere on the board
/samp32-memory-mux/A_SEL0: U16.4 (Za); also elsewhere on the board
/samp32-memory-mux/A_SEL1: U16.7 (Zb); also elsewhere on the board
/samp32-memory-mux/A_SEL2: U16.9 (Zc); also elsewhere on the board
/samp32-memory-mux/A_SEL3: U16.12 (Zd); also elsewhere on the board
/samp32-memory-mux/A_SEL4: U17.4 (Za); also elsewhere on the board
/samp32-memory-mux/A_SEL5: U17.7 (Zb); also elsewhere on the board
/samp32-memory-mux/A_SEL6: U17.9 (Zc); also elsewhere on the board
/samp32-memory-mux/A_SEL7: U17.12 (Zd); also elsewhere on the board
/samp32-memory-mux/A_SEL8: U18.4 (Za); also elsewhere on the board
/samp32-memory-mux/A_SEL9: U18.7 (Zb); also elsewhere on the board
/samp32-memory-mux/A_SEL10: U18.9 (Zc); also elsewhere on the board
/samp32-memory-mux/A_SEL11: U18.12 (Zd); also elsewhere on the board
/samp32-memory-mux/A_SEL12: U19.4 (Za); also elsewhere on the board
/samp32-memory-mux/A_SEL13: U19.7 (Zb); also elsewhere on the board
/samp32-memory-mux/A_SEL14: U19.9 (Zc); also elsewhere on the board
/samp32-memory-mux/A_SEL15: U19.12 (Zd); also elsewhere on the board
/samp32-memory-mux/A_SEL16: U20.4 (Za); also elsewhere on the board
/samp32-memory-mux/A_SEL17: U20.7 (Zb); also elsewhere on the board
/samp32-memory-mux/A_SEL18: U20.9 (Zc); also elsewhere on the board
/samp32-memory-mux/A_SEL19: U20.12 (Zd)
/samp32-memory-mux/A_SEL20: U21.4 (Za)
/samp32-memory-mux/A_SEL21: U21.7 (Zb)
/samp32-memory-mux/A_SEL22: U21.9 (Zc)
/samp32-memory-mux/A_SEL23: U21.12 (Zd)
/samp32-memory-mux/A_SEL24: U22.4 (Za)
/samp32-memory-mux/A_SEL25: U22.7 (Zb)
/samp32-memory-mux/A_SEL26: U22.9 (Zc)
/samp32-memory-mux/A_SEL27: U22.12 (Zd)
/samp32-memory-mux/A_SEL28: U23.4 (Za)
/samp32-memory-mux/A_SEL29: U23.7 (Zb)
/samp32-memory-mux/A_SEL30: U23.9 (Zc)
/samp32-memory-mux/A_SEL31: U23.12 (Zd)
/samp32-memory-mux/S: U16.1 (S), U17.1 (S), U18.1 (S), U19.1 (S), U20.1 (S), U21.1 (S), U22.1 (S), U23.1 (S); also elsewhere on the board
GND: C17.2, C18.1, C19.2, C20.1, C21.1, C22.1, C23.1, C24.1, U16.8 (GND), U16.15 (E), U17.8 (GND), U17.15 (E), U18.8 (GND), U18.15 (E), U19.8 (GND), U19.15 (E), U20.8 (GND), U20.15 (E), U21.8 (GND), U21.15 (E), U22.8 (GND), U22.15 (E), U23.8 (GND), U23.15 (E); also elsewhere on the board
VCC: C17.1, C18.2, C19.1, C20.2, C21.2, C22.2, C23.2, C24.2, U16.16 (VCC), U17.16 (VCC), U18.16 (VCC), U19.16 (VCC), U20.16 (VCC), U21.16 (VCC), U22.16 (VCC), U23.16 (VCC); also elsewhere on the board

Parts of its further copies:
C25, C27, C28, C29, C30, C31, C32: 100nF; C_0603_1608Metric
C26: C51; C_0603_1608Metric
U24, U25, U26, U27, U28, U29, U30, U31: 74ACT157; TSSOP-16_4.4x5mm_P0.65mm

Connections of its further copies:
/A0: U24.2 (I0a); also elsewhere on the board
/A1: U24.5 (I0b); also elsewhere on the board
/A2: U24.11 (I0c); also elsewhere on the board
/A3: U24.14 (I0d); also elsewhere on the board
/A4: U25.2 (I0a); also elsewhere on the board
/A5: U25.5 (I0b); also elsewhere on the board
/A6: U25.11 (I0c); also elsewhere on the board
/A7: U25.14 (I0d); also elsewhere on the board
/A8: U26.2 (I0a); also elsewhere on the board
/A9: U26.5 (I0b); also elsewhere on the board
/A10: U26.11 (I0c); also elsewhere on the board
/A11: U26.13 (I1d); also elsewhere on the board
/A12: U27.2 (I0a); also elsewhere on the board
/A13: U27.5 (I0b); also elsewhere on the board
/A14: U27.11 (I0c); also elsewhere on the board
/A15: U27.14 (I0d); also elsewhere on the board
/A16: U28.2 (I0a); also elsewhere on the board
/A17: U28.5 (I0b); also elsewhere on the board
/A18: U28.11 (I0c); also elsewhere on the board
/A19: U28.14 (I0d); also elsewhere on the board
/A20: U29.2 (I0a); also elsewhere on the board
/A21: U29.5 (I0b); also elsewhere on the board
/A22: U29.11 (I0c); also elsewhere on the board
/A23: U29.14 (I0d); also elsewhere on the board
/A24: U30.2 (I0a); also elsewhere on the board
/A25: U30.5 (I0b); also elsewhere on the board
/A26: U30.11 (I0c); also elsewhere on the board
/A27: U30.14 (I0d); also elsewhere on the board
/A28: U31.2 (I0a); also elsewhere on the board
/A29: U31.5 (I0b); also elsewhere on the board
/A31: U31.14 (I0d); also elsewhere on the board
/samp32-memory-mux1/A_SEL19: U28.12 (Zd)
/samp32-memory-mux1/A_SEL20: U29.4 (Za)
/samp32-memory-mux1/A_SEL21: U29.7 (Zb)
/samp32-memory-mux1/A_SEL22: U29.9 (Zc)
/samp32-memory-mux1/A_SEL23: U29.12 (Zd)
/samp32-memory-mux1/A_SEL24: U30.4 (Za)
/samp32-memory-mux1/A_SEL25: U30.7 (Zb)
/samp32-memory-mux1/A_SEL26: U30.9 (Zc)
/samp32-memory-mux1/A_SEL27: U30.12 (Zd)
/samp32-memory-mux1/A_SEL28: U31.4 (Za)
/samp32-memory-mux1/A_SEL29: U31.7 (Zb)
/samp32-memory-mux1/A_SEL30: U31.9 (Zc)
/samp32-memory-mux1/A_SEL31: U31.12 (Zd)
/samp32-memory-mux1/S: U24.1 (S), U25.1 (S), U26.1 (S), U27.1 (S), U28.1 (S), U29.1 (S), U30.1 (S), U31.1 (S); also elsewhere on the board
/samp32-memory-mux/A++0: U24.3 (I1a); also elsewhere on the board
/samp32-memory-mux/A++1: U24.6 (I1b); also elsewhere on the board
/samp32-memory-mux/A++2: U24.10 (I1c); also elsewhere on the board
/samp32-memory-mux/A++3: U24.13 (I1d); also elsewhere on the board
/samp32-memory-mux/A++4: U25.3 (I1a); also elsewhere on the board
/samp32-memory-mux/A++5: U25.6 (I1b); also elsewhere on the board
/samp32-memory-mux/A++6: U25.10 (I1c); also elsewhere on the board
/samp32-memory-mux/A++7: U25.13 (I1d); also elsewhere on the board
/samp32-memory-mux/A++8: U26.3 (I1a); also elsewhere on the board
/samp32-memory-mux/A++9: U26.6 (I1b); also elsewhere on the board
/samp32-memory-mux/A++10: U26.10 (I1c); also elsewhere on the board
/samp32-memory-mux/A++11: U26.14 (I0d); also elsewhere on the board
/samp32-memory-mux/A++12: U27.3 (I1a); also elsewhere on the board
/samp32-memory-mux/A++13: U27.6 (I1b); also elsewhere on the board
/samp32-memory-mux/A++14: U27.10 (I1c); also elsewhere on the board
/samp32-memory-mux/A++15: U27.13 (I1d); also elsewhere on the board
/samp32-memory-mux/A++16: U28.3 (I1a); also elsewhere on the board
/samp32-memory-mux/A++17: U28.6 (I1b); also elsewhere on the board
/samp32-memory-mux/A++18: U28.10 (I1c); also elsewhere on the board
/samp32-memory-mux/A++19: U28.13 (I1d); also elsewhere on the board
/samp32-memory-mux/A++20: U29.3 (I1a); also elsewhere on the board
/samp32-memory-mux/A++21: U29.6 (I1b); also elsewhere on the board
/samp32-memory-mux/A++22: U29.10 (I1c); also elsewhere on the board
/samp32-memory-mux/A++23: U29.13 (I1d); also elsewhere on the board
/samp32-memory-mux/A++24: U30.3 (I1a); also elsewhere on the board
/samp32-memory-mux/A++25: U30.6 (I1b); also elsewhere on the board
/samp32-memory-mux/A++26: U30.10 (I1c); also elsewhere on the board
/samp32-memory-mux/A++27: U30.13 (I1d); also elsewhere on the board
/samp32-memory-mux/A++28: U31.3 (I1a); also elsewhere on the board
/samp32-memory-mux/A++29: U31.6 (I1b); also elsewhere on the board
/samp32-memory-mux/A++30: U31.10 (I1c); also elsewhere on the board
/samp32-memory-mux/A++31: U31.13 (I1d); also elsewhere on the board
/samp32-memory-mux/A_SEL0: U24.4 (Za); also elsewhere on the board
/samp32-memory-mux/A_SEL1: U24.7 (Zb); also elsewhere on the board
/samp32-memory-mux/A_SEL2: U24.9 (Zc); also elsewhere on the board
/samp32-memory-mux/A_SEL3: U24.12 (Zd); also elsewhere on the board
/samp32-memory-mux/A_SEL4: U25.4 (Za); also elsewhere on the board
/samp32-memory-mux/A_SEL5: U25.7 (Zb); also elsewhere on the board
/samp32-memory-mux/A_SEL6: U25.9 (Zc); also elsewhere on the board
/samp32-memory-mux/A_SEL7: U25.12 (Zd); also elsewhere on the board
/samp32-memory-mux/A_SEL8: U26.4 (Za); also elsewhere on the board
/samp32-memory-mux/A_SEL9: U26.7 (Zb); also elsewhere on the board
/samp32-memory-mux/A_SEL10: U26.9 (Zc); also elsewhere on the board
/samp32-memory-mux/A_SEL11: U26.12 (Zd); also elsewhere on the board
/samp32-memory-mux/A_SEL12: U27.4 (Za); also elsewhere on the board
/samp32-memory-mux/A_SEL13: U27.7 (Zb); also elsewhere on the board
/samp32-memory-mux/A_SEL14: U27.9 (Zc); also elsewhere on the board
/samp32-memory-mux/A_SEL15: U27.12 (Zd); also elsewhere on the board
/samp32-memory-mux/A_SEL16: U28.4 (Za); also elsewhere on the board
/samp32-memory-mux/A_SEL17: U28.7 (Zb); also elsewhere on the board
/samp32-memory-mux/A_SEL18: U28.9 (Zc); also elsewhere on the board
GND: C25.2, C26.1, C27.2, C28.1, C29.1, C30.1, C31.1, C32.1, U24.8 (GND), U24.15 (E), U25.8 (GND), U25.15 (E), U26.8 (GND), U26.15 (E), U27.8 (GND), U27.15 (E), U28.8 (GND), U28.15 (E), U29.8 (GND), U29.15 (E), U30.8 (GND), U30.15 (E), U31.8 (GND), U31.15 (E); also elsewhere on the board
VCC: C25.1, C26.2, C27.1, C28.2, C29.2, C30.2, C31.2, C32.2, U24.16 (VCC), U25.16 (VCC), U26.16 (VCC), U27.16 (VCC), U28.16 (VCC), U29.16 (VCC), U30.16 (VCC), U31.16 (VCC); also elsewhere on the board

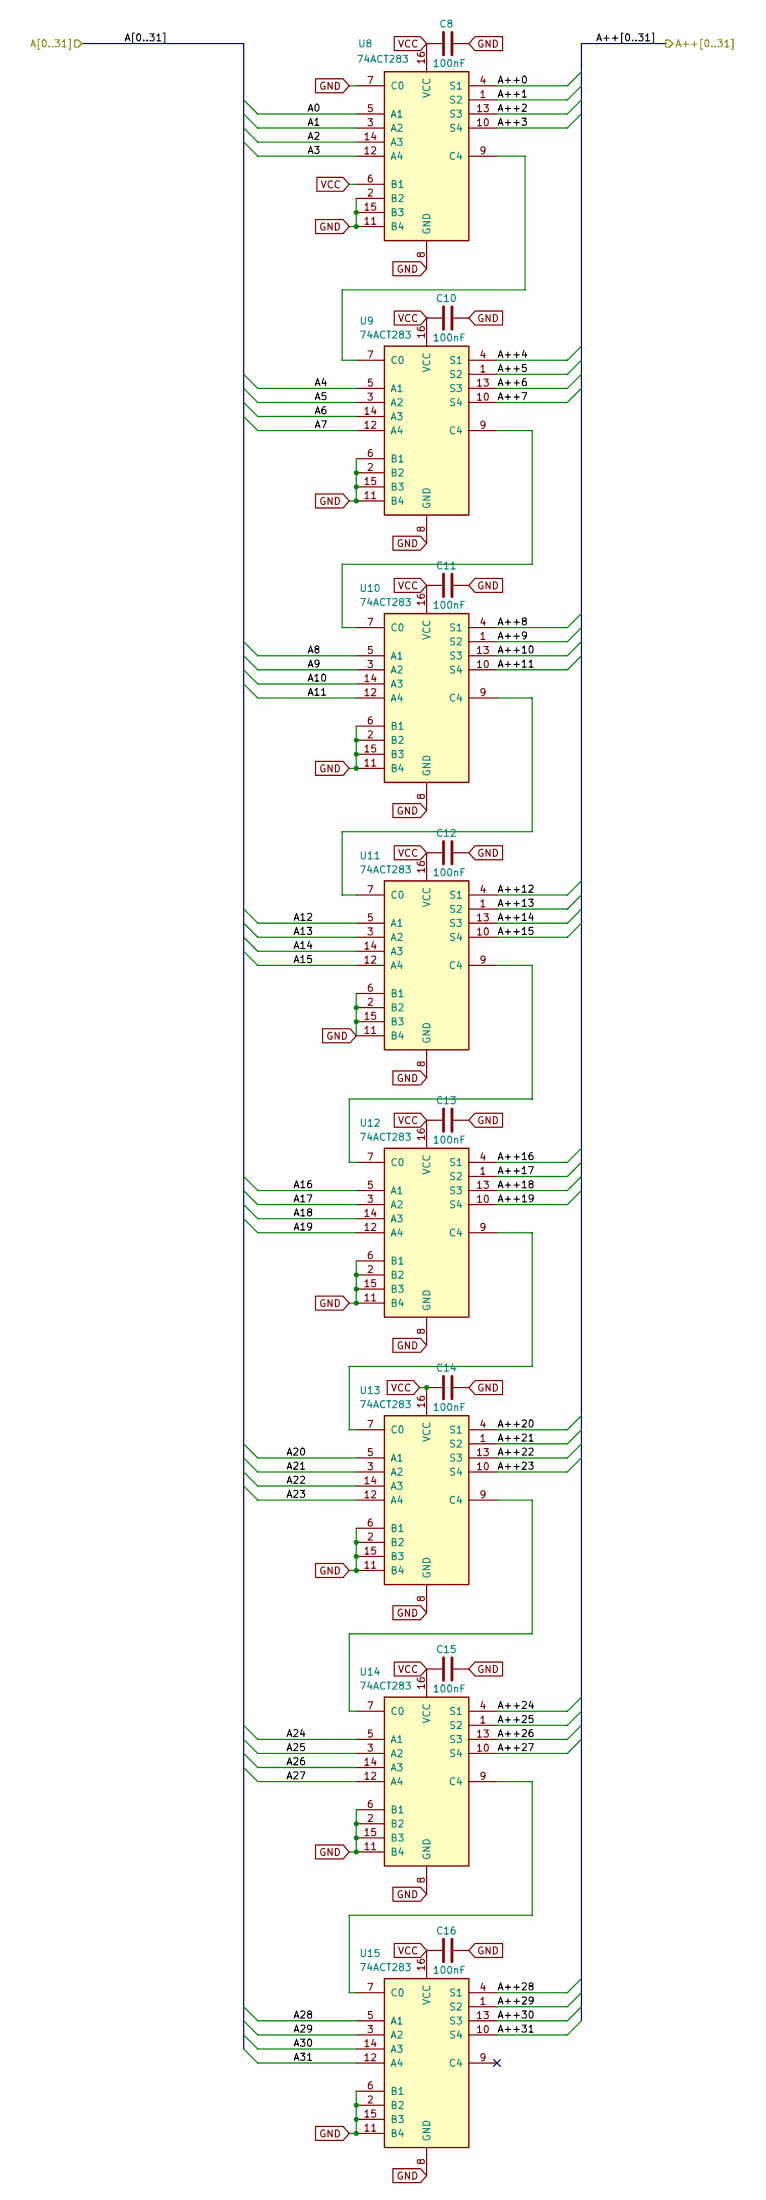
[picture p6: schematic scamp32-memory-address-adder.kicad_sch]

Parts:
C8, C10, C11, C12, C13, C14, C15, C16: 100nF; C_0603_1608Metric
U8, U9, U10, U11, U12, U13, U14, U15: 74ACT283; TSSOP-16_4.4x5mm_P0.65mm

Connections:
/A0: U8.5 (A1); also elsewhere on the board
/A1: U8.3 (A2); also elsewhere on the board
/A2: U8.14 (A3); also elsewhere on the board
/A3: U8.12 (A4); also elsewhere on the board
/A4: U9.5 (A1); also elsewhere on the board
/A5: U9.3 (A2); also elsewhere on the board
/A6: U9.14 (A3); also elsewhere on the board
/A7: U9.12 (A4); also elsewhere on the board
/A8: U10.5 (A1); also elsewhere on the board
/A9: U10.3 (A2); also elsewhere on the board
/A10: U10.14 (A3); also elsewhere on the board
/A11: U10.12 (A4); also elsewhere on the board
/A12: U11.5 (A1); also elsewhere on the board
/A13: U11.3 (A2); also elsewhere on the board
/A14: U11.14 (A3); also elsewhere on the board
/A15: U11.12 (A4); also elsewhere on the board
/A16: U12.5 (A1); also elsewhere on the board
/A17: U12.3 (A2); also elsewhere on the board
/A18: U12.14 (A3); also elsewhere on the board
/A19: U12.12 (A4); also elsewhere on the board
/A20: U13.5 (A1); also elsewhere on the board
/A21: U13.3 (A2); also elsewhere on the board
/A22: U13.14 (A3); also elsewhere on the board
/A23: U13.12 (A4); also elsewhere on the board
/A24: U14.5 (A1); also elsewhere on the board
/A25: U14.3 (A2); also elsewhere on the board
/A26: U14.14 (A3); also elsewhere on the board
/A27: U14.12 (A4); also elsewhere on the board
/A28: U15.5 (A1); also elsewhere on the board
/A29: U15.3 (A2); also elsewhere on the board
/A30: U15.14 (A3); also elsewhere on the board
/A31: U15.12 (A4); also elsewhere on the board
/samp32-memory-mux/A++0: U8.4 (S1); also elsewhere on the board
/samp32-memory-mux/A++1: U8.1 (S2); also elsewhere on the board
/samp32-memory-mux/A++2: U8.13 (S3); also elsewhere on the board
/samp32-memory-mux/A++3: U8.10 (S4); also elsewhere on the board
/samp32-memory-mux/A++4: U9.4 (S1); also elsewhere on the board
/samp32-memory-mux/A++5: U9.1 (S2); also elsewhere on the board
/samp32-memory-mux/A++6: U9.13 (S3); also elsewhere on the board
/samp32-memory-mux/A++7: U9.10 (S4); also elsewhere on the board
/samp32-memory-mux/A++8: U10.4 (S1); also elsewhere on the board
/samp32-memory-mux/A++9: U10.1 (S2); also elsewhere on the board
/samp32-memory-mux/A++10: U10.13 (S3); also elsewhere on the board
/samp32-memory-mux/A++11: U10.10 (S4); also elsewhere on the board
/samp32-memory-mux/A++12: U11.4 (S1); also elsewhere on the board
/samp32-memory-mux/A++13: U11.1 (S2); also elsewhere on the board
/samp32-memory-mux/A++14: U11.13 (S3); also elsewhere on the board
/samp32-memory-mux/A++15: U11.10 (S4); also elsewhere on the board
/samp32-memory-mux/A++16: U12.4 (S1); also elsewhere on the board
/samp32-memory-mux/A++17: U12.1 (S2); also elsewhere on the board
/samp32-memory-mux/A++18: U12.13 (S3); also elsewhere on the board
/samp32-memory-mux/A++19: U12.10 (S4); also elsewhere on the board
/samp32-memory-mux/A++20: U13.4 (S1); also elsewhere on the board
/samp32-memory-mux/A++21: U13.1 (S2); also elsewhere on the board
/samp32-memory-mux/A++22: U13.13 (S3); also elsewhere on the board
/samp32-memory-mux/A++23: U13.10 (S4); also elsewhere on the board
/samp32-memory-mux/A++24: U14.4 (S1); also elsewhere on the board
/samp32-memory-mux/A++25: U14.1 (S2); also elsewhere on the board
/samp32-memory-mux/A++26: U14.13 (S3); also elsewhere on the board
/samp32-memory-mux/A++27: U14.10 (S4); also elsewhere on the board
/samp32-memory-mux/A++28: U15.4 (S1); also elsewhere on the board
/samp32-memory-mux/A++29: U15.1 (S2); also elsewhere on the board
/samp32-memory-mux/A++30: U15.13 (S3); also elsewhere on the board
/samp32-memory-mux/A++31: U15.10 (S4); also elsewhere on the board
GND: C8.2, C10.2, C11.2, C12.2, C13.2, C14.2, C15.2, C16.2, U8.2 (B2), U8.7 (C0), U8.8 (GND), U8.11 (B4), U8.15 (B3), U9.2 (B2), U9.6 (B1), U9.8 (GND), U9.11 (B4), U9.15 (B3), U10.2 (B2), U10.6 (B1), U10.8 (GND), U10.11 (B4), U10.15 (B3), U11.2 (B2), U11.6 (B1), U11.8 (GND), U11.11 (B4), U11.15 (B3), U12.2 (B2), U12.6 (B1), U12.8 (GND), U12.11 (B4), U12.15 (B3), U13.2 (B2), U13.6 (B1), U13.8 (GND), U13.11 (B4), U13.15 (B3), U14.2 (B2), U14.6 (B1), U14.8 (GND), U14.11 (B4), U14.15 (B3), U15.2 (B2), U15.6 (B1), U15.8 (GND), U15.11 (B4), U15.15 (B3); also elsewhere on the board
unnamed: U8.9 (C4), U9.7 (C0)
unnamed: U9.9 (C4), U10.7 (C0)
unnamed: U10.9 (C4), U11.7 (C0)
unnamed: U11.9 (C4), U12.7 (C0)
unnamed: U12.9 (C4), U13.7 (C0)
unnamed: U13.9 (C4), U14.7 (C0)
unnamed: U14.9 (C4), U15.7 (C0)
VCC: C8.1, C10.1, C11.1, C12.1, C13.1, C14.1, C15.1, C16.1, U8.6 (B1), U8.16 (VCC), U9.16 (VCC), U10.16 (VCC), U11.16 (VCC), U12.16 (VCC), U13.16 (VCC), U14.16 (VCC), U15.16 (VCC); also elsewhere on the board

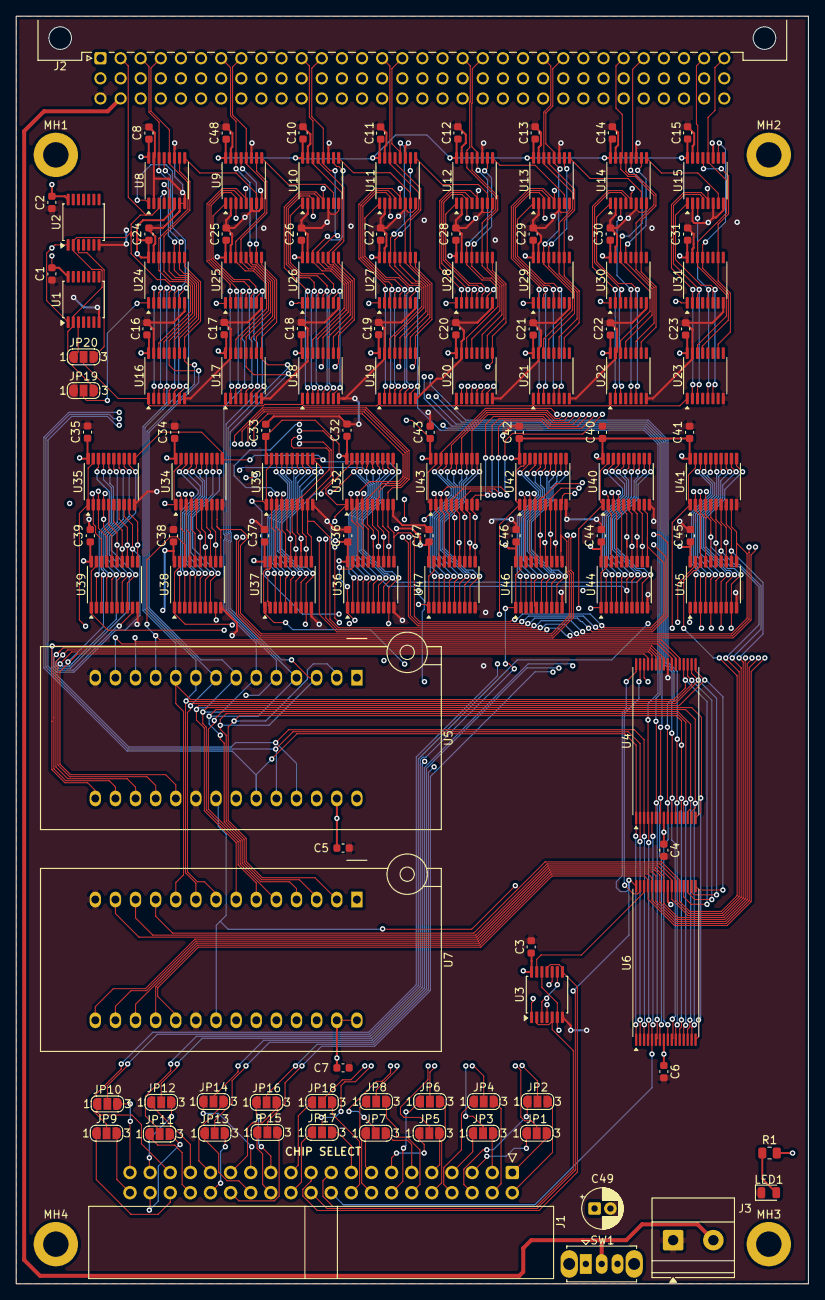
[picture p7: board kicad/scamp32-memory/scamp32-memory.kicad_pcb from above]

Board: 4 copper layers, 100.0 x 160.0 mm, 125 parts (0 on the bottom side), 208 nets.

Other parts of the board:
MH1, MH2, MH3, MH4: MountingHole_3.2mm_M3_DIN965_Pad
