BenskiBoy/scamp-32/kicad/scamp32-memory/_restore_backup_2026-09-26T09-44-30-685/scamp32-memory.kicad_pcb

## KiCad design kicad/scamp32-memory/_restore_backup_2026-09-26T09-44-30-685/scamp32-memory.kicad_pcb (2026-10-10)

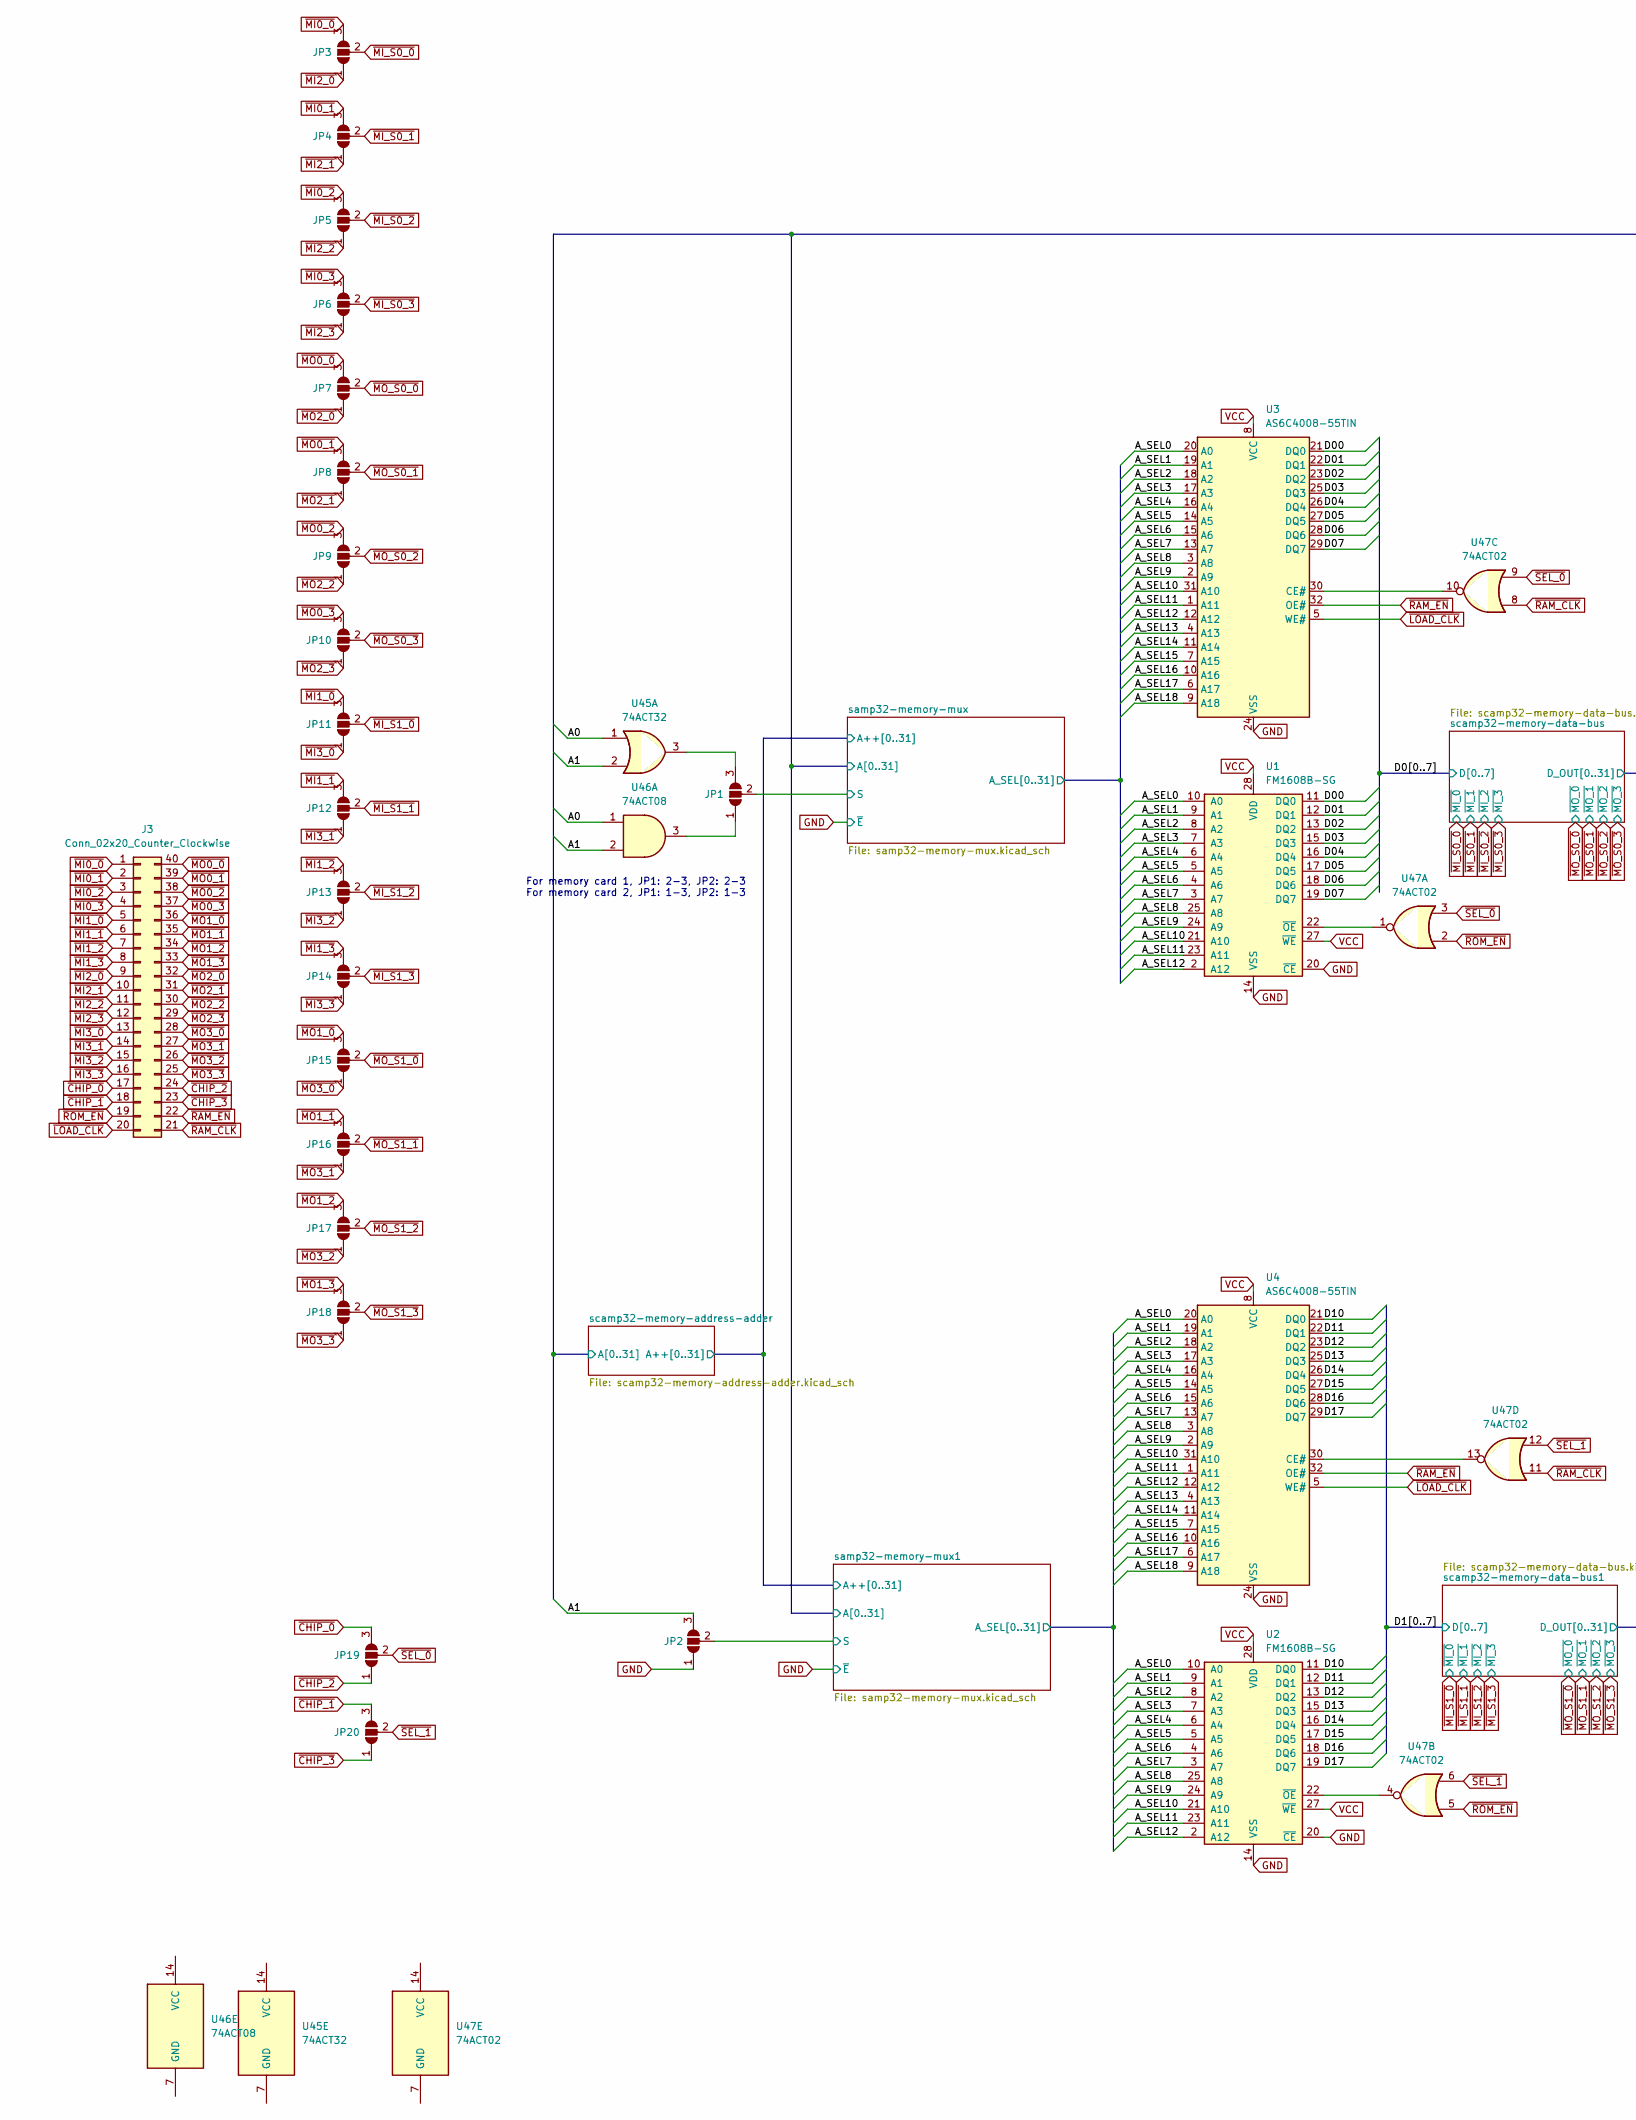
[picture p8: schematic scamp32-memory.kicad_sch, part in row 1, column 1]

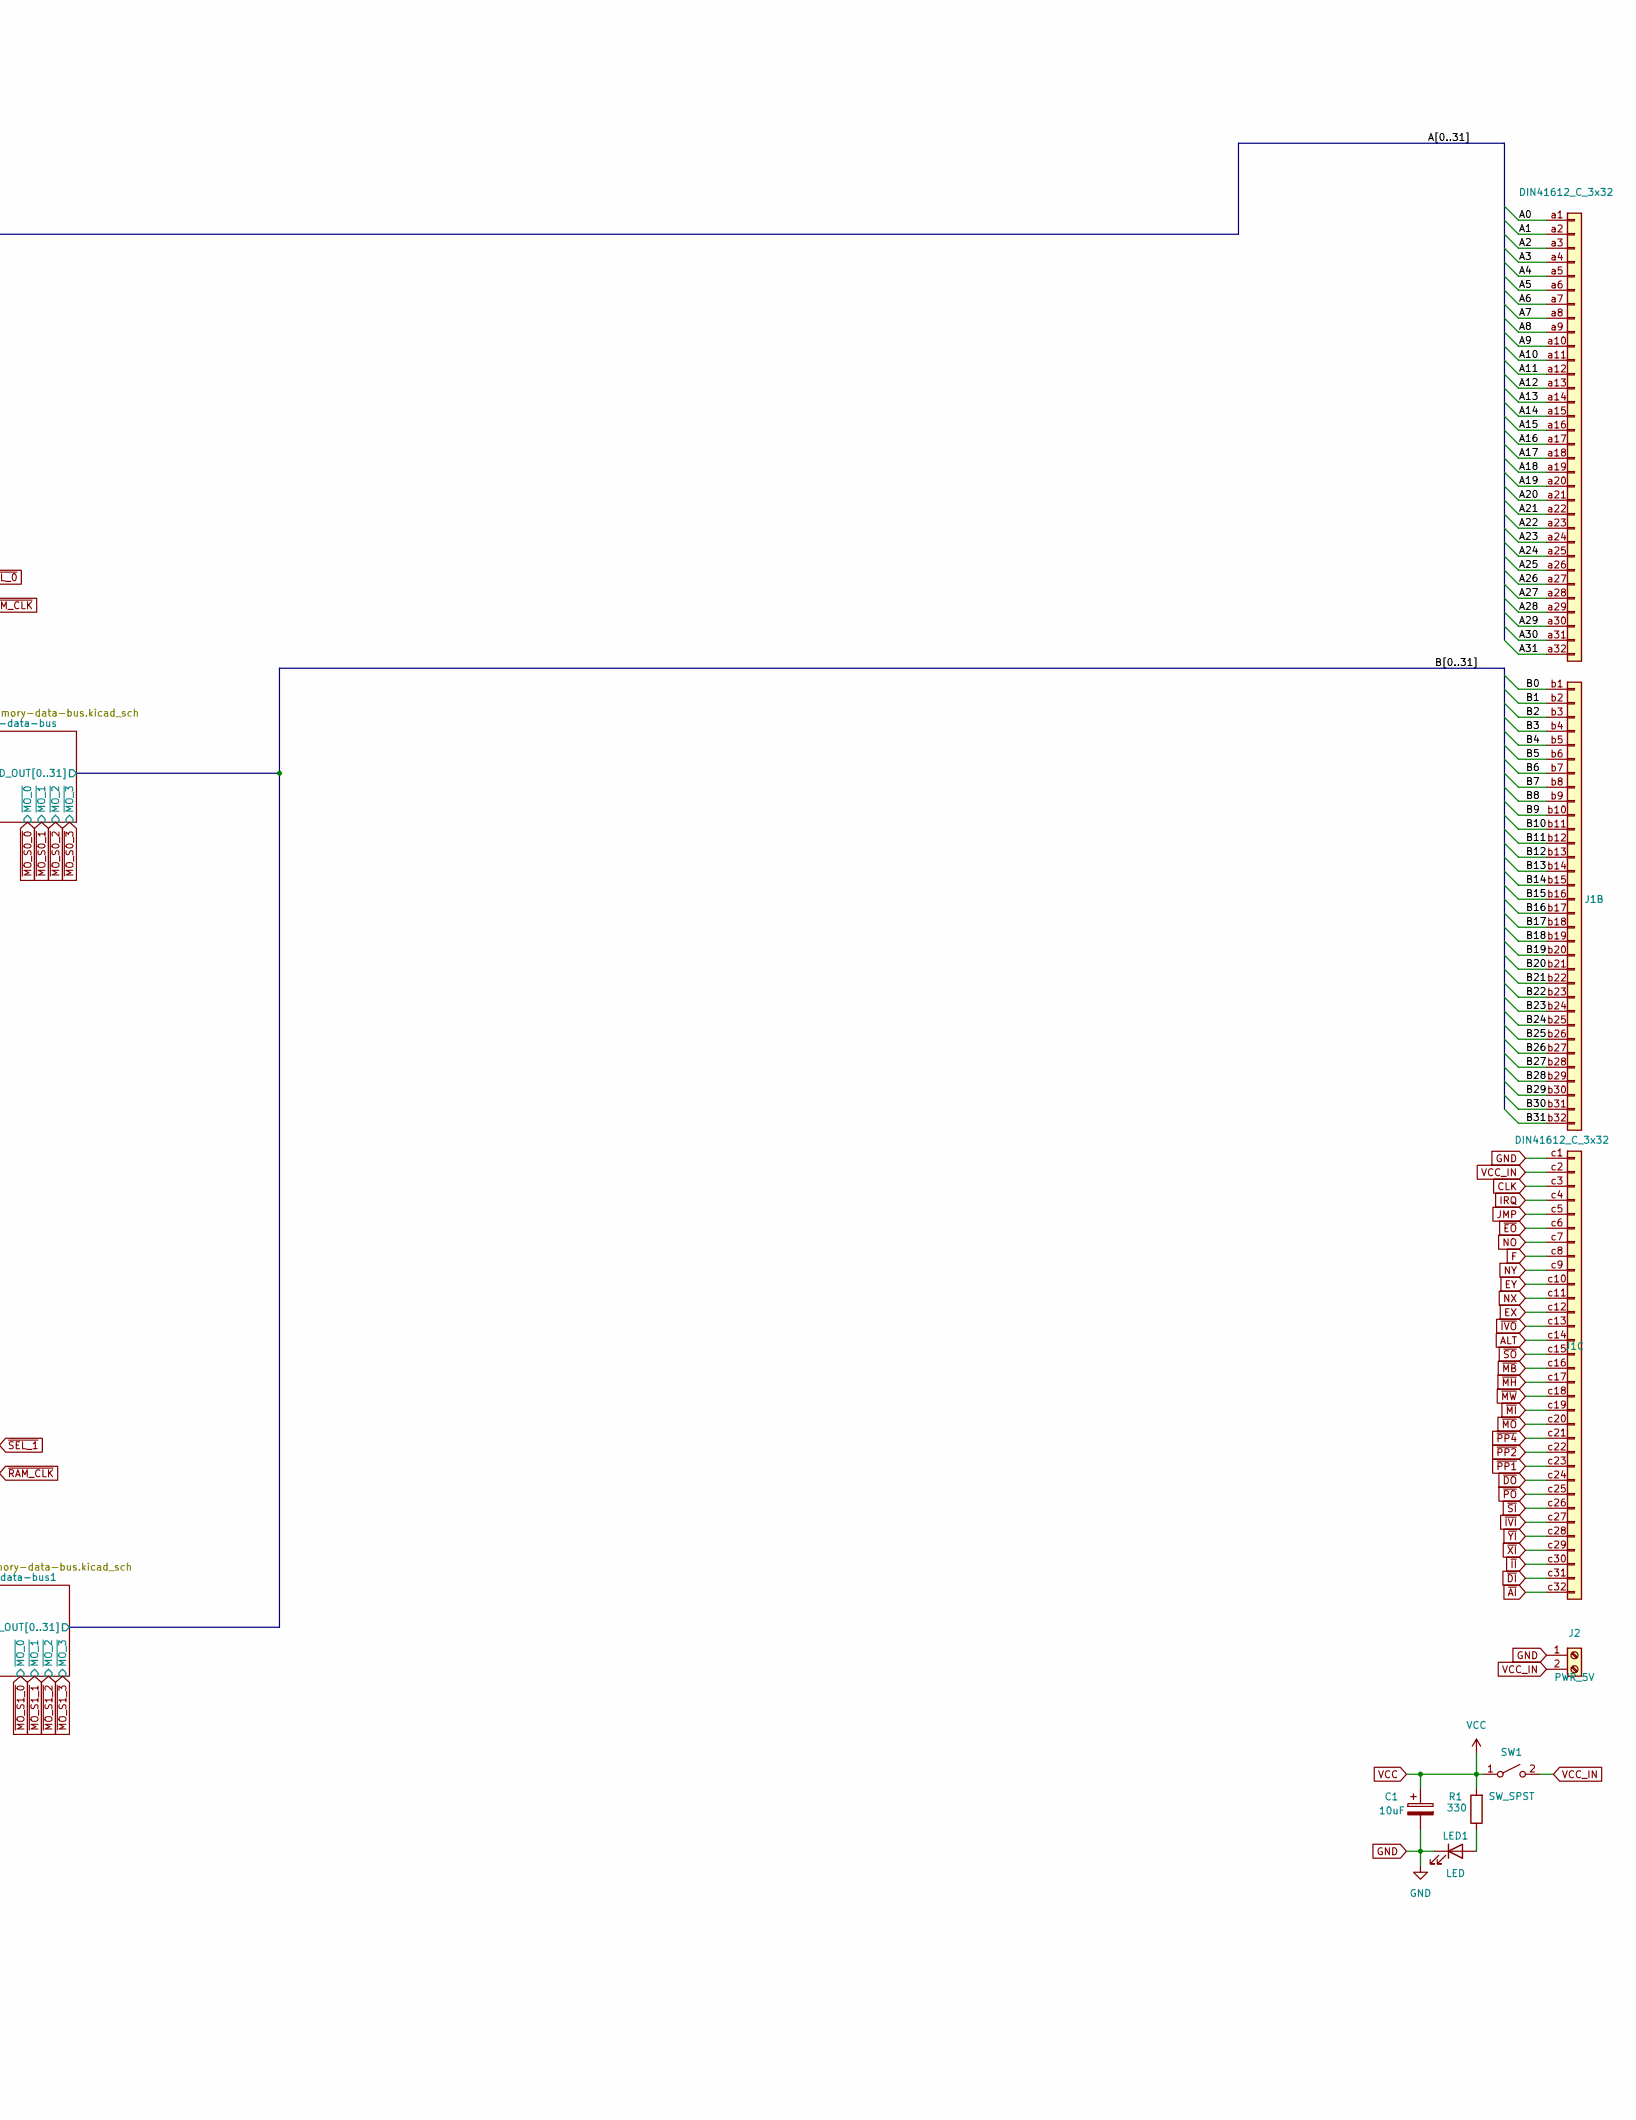
[picture p9: schematic scamp32-memory.kicad_sch, part in row 1, column 2]

Parts:
C1: 10uF; CP_Radial_D5.0mm_P2.00mm
J1: DIN41612_C_3x32; DIN41612_C_3x32_Male_Horizontal_THT
J2: PWR_5V; TerminalBlock_Phoenix_MKDS-1,5-2-5.08_1x02_P5.08mm_Horizont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
J3: Conn_02x20_Counter_Clockwise; IDC-Header_2x20_P2.54mm_Horizontal
JP1, JP2, JP3, JP4, JP5, JP6, JP7, JP8, JP9, JP10, JP11, JP12, JP13, JP14, JP15, JP16, JP17, JP18, JP19, JP20: SolderJumper_3_Open; SolderJumper-3_P1.3mm_Open_RoundedPad1.0x1.5mm_NumberLabels
LED1: LED; LED_0805_2012Metric
R1: 330; R_0805_2012Metric
SW1: SW_SPST; SW_Slide_SPDT_Straight_CK_OS102011MS2Q
U1, U2: FM1608B-SG; DIP_Socket-28_W11.9mm_W12.7mm_W15.24mm_W17.78mm_W18.5mm_3M_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
U3, U4: AS6C4008-55TIN; TSOP-I-32_18.4x8mm_P0.5mm
U45: 74ACT32; SOIC-14_3.9x8.7mm_P1.27mm
U46: 74ACT08; TSSOP-14_4.4x5mm_P0.65mm
U47: 74ACT02; TSSOP-14_4.4x5mm_P0.65mm

Connections:
/A0: J1.a1, U45.1, U46.1; also elsewhere on the board
/A1: J1.a2, JP2.3 (B), U45.2, U46.2; also elsewhere on the board
/A2: J1.a3; also elsewhere on the board
/A3: J1.a4; also elsewhere on the board
/A4: J1.a5; also elsewhere on the board
/A5: J1.a6; also elsewhere on the board
/A6: J1.a7; also elsewhere on the board
/A7: J1.a8; also elsewhere on the board
/A8: J1.a9; also elsewhere on the board
/A9: J1.a10; also elsewhere on the board
/A10: J1.a11; also elsewhere on the board
/A11: J1.a12; also elsewhere on the board
/A12: J1.a13; also elsewhere on the board
/A13: J1.a14; also elsewhere on the board
/A14: J1.a15; also elsewhere on the board
/A15: J1.a16; also elsewhere on the board
/A16: J1.a17; also elsewhere on the board
/A17: J1.a18; also elsewhere on the board
/A18: J1.a19; also elsewhere on the board
/A19: J1.a20; also elsewhere on the board
/A20: J1.a21; also elsewhere on the board
/A21: J1.a22; also elsewhere on the board
/A22: J1.a23; also elsewhere on the board
/A23: J1.a24; also elsewhere on the board
/A24: J1.a25; also elsewhere on the board
/A25: J1.a26; also elsewhere on the board
/A26: J1.a27; also elsewhere on the board
/A27: J1.a28; also elsewhere on the board
/A28: J1.a29; also elsewhere on the board
/A29: J1.a30; also elsewhere on the board
/A30: J1.a31; also elsewhere on the board
/A31: J1.a32; also elsewhere on the board
/B0: J1.b1; also elsewhere on the board
/B1: J1.b2; also elsewhere on the board
/B2: J1.b3; also elsewhere on the board
/B3: J1.b4; also elsewhere on the board
/B4: J1.b5; also elsewhere on the board
/B5: J1.b6; also elsewhere on the board
/B6: J1.b7; also elsewhere on the board
/B7: J1.b8; also elsewhere on the board
/B8: J1.b9; also elsewhere on the board
/B9: J1.b10; also elsewhere on the board
/B10: J1.b11; also elsewhere on the board
/B11: J1.b12; also elsewhere on the board
/B12: J1.b13; also elsewhere on the board
/B13: J1.b14; also elsewhere on the board
/B14: J1.b15; also elsewhere on the board
/B15: J1.b16; also elsewhere on the board
/B16: J1.b17; also elsewhere on the board
/B17: J1.b18; also elsewhere on the board
/B18: J1.b19; also elsewhere on the board
/B19: J1.b20; also elsewhere on the board
/B20: J1.b21; also elsewhere on the board
/B21: J1.b22; also elsewhere on the board
/B22: J1.b23; also elsewhere on the board
/B23: J1.b24; also elsewhere on the board
/B24: J1.b25; also elsewhere on the board
/B25: J1.b26; also elsewhere on the board
/B26: J1.b27; also elsewhere on the board
/B27: J1.b28; also elsewhere on the board
/B28: J1.b29; also elsewhere on the board
/B29: J1.b30; also elsewhere on the board
/B30: J1.b31; also elsewhere on the board
/B31: J1.b32; also elsewhere on the board
/D00: U1.11 (DQ0), U3.21 (DQ0); also elsewhere on the board
/D01: U1.12 (DQ1), U3.22 (DQ1); also elsewhere on the board
/D02: U1.13 (DQ2), U3.23 (DQ2); also elsewhere on the board
/D03: U1.15 (DQ3), U3.25 (DQ3); also elsewhere on the board
/D04: U1.16 (DQ4), U3.26 (DQ4); also elsewhere on the board
/D05: U1.17 (DQ5), U3.27 (DQ5); also elsewhere on the board
/D06: U1.18 (DQ6), U3.28 (DQ6); also elsewhere on the board
/D07: U1.19 (DQ7), U3.29 (DQ7); also elsewhere on the board
/D10: U2.11 (DQ0), U4.21 (DQ0); also elsewhere on the board
/D11: U2.12 (DQ1), U4.22 (DQ1); also elsewhere on the board
/D12: U2.13 (DQ2), U4.23 (DQ2); also elsewhere on the board
/D13: U2.15 (DQ3), U4.25 (DQ3); also elsewhere on the board
/D14: U2.16 (DQ4), U4.26 (DQ4); also elsewhere on the board
/D15: U2.17 (DQ5), U4.27 (DQ5); also elsewhere on the board
/D16: U2.18 (DQ6), U4.28 (DQ6); also elsewhere on the board
/D17: U2.19 (DQ7), U4.29 (DQ7); also elsewhere on the board
/samp32-memory-mux1/S: JP2.2 (C); also elsewhere on the board
/samp32-memory-mux/A_SEL0: U1.10 (A0), U2.10 (A0), U3.20 (A0), U4.20 (A0); also elsewhere on the board
/samp32-memory-mux/A_SEL1: U1.9 (A1), U2.9 (A1), U3.19 (A1), U4.19 (A1); also elsewhere on the board
/samp32-memory-mux/A_SEL2: U1.8 (A2), U2.8 (A2), U3.18 (A2), U4.18 (A2); also elsewhere on the board
/samp32-memory-mux/A_SEL3: U1.7 (A3), U2.7 (A3), U3.17 (A3), U4.17 (A3); also elsewhere on the board
/samp32-memory-mux/A_SEL4: U1.6 (A4), U2.6 (A4), U3.16 (A4), U4.16 (A4); also elsewhere on the board
/samp32-memory-mux/A_SEL5: U1.5 (A5), U2.5 (A5), U3.14 (A5), U4.14 (A5); also elsewhere on the board
/samp32-memory-mux/A_SEL6: U1.4 (A6), U2.4 (A6), U3.15 (A6), U4.15 (A6); also elsewhere on the board
/samp32-memory-mux/A_SEL7: U1.3 (A7), U2.3 (A7), U3.13 (A7), U4.13 (A7); also elsewhere on the board
/samp32-memory-mux/A_SEL8: U1.25 (A8), U2.25 (A8), U3.3 (A8), U4.3 (A8); also elsewhere on the board
/samp32-memory-mux/A_SEL9: U1.24 (A9), U2.24 (A9), U3.2 (A9), U4.2 (A9); also elsewhere on the board
/samp32-memory-mux/A_SEL10: U1.21 (A10), U2.21 (A10), U3.31 (A10), U4.31 (A10); also elsewhere on the board
/samp32-memory-mux/A_SEL11: U1.23 (A11), U2.23 (A11), U3.1 (A11), U4.1 (A11); also elsewhere on the board
/samp32-memory-mux/A_SEL12: U1.2 (A12), U2.2 (A12), U3.12 (A12), U4.12 (A12); also elsewhere on the board
/samp32-memory-mux/A_SEL13: U3.4 (A13), U4.4 (A13); also elsewhere on the board
/samp32-memory-mux/A_SEL14: U3.11 (A14), U4.11 (A14); also elsewhere on the board
/samp32-memory-mux/A_SEL15: U3.7 (A15), U4.7 (A15); also elsewhere on the board
/samp32-memory-mux/A_SEL16: U3.10 (A16), U4.10 (A16); also elsewhere on the board
/samp32-memory-mux/A_SEL17: U3.6 (A17), U4.6 (A17); also elsewhere on the board
/samp32-memory-mux/A_SEL18: U3.9 (A18), U4.9 (A18); also elsewhere on the board
/samp32-memory-mux/S: JP1.2 (C); also elsewhere on the board
ALT: J1.c14
CLK: J1.c3
EX: J1.c12
EY: J1.c10
F: J1.c8
GND: C1.2, J1.c1, J2.1, JP2.1 (A), LED1.1 (K), U1.14 (VSS), U1.20 (~CE), U2.14 (VSS), U2.20 (~CE), U3.24 (VSS), U4.24 (VSS); also elsewhere on the board
IRQ: J1.c4
JMP: J1.c5
NO: J1.c7
NX: J1.c11
NY: J1.c9
unnamed: JP1.1 (A), U46.3
unnamed: JP1.3 (B), U45.3
unnamed: LED1.2 (A), R1.1
unnamed: U1.22 (~OE), U47.1
unnamed: U2.22 (~OE), U47.4
unnamed: U3.30 (CE#), U47.10
unnamed: U4.30 (CE#), U47.13
VCC: C1.1, R1.2, SW1.1 (A), U1.27 (~WE), U1.28 (VDD), U2.27 (~WE), U2.28 (VDD), U3.8 (VCC), U4.8 (VCC); also elsewhere on the board
VCC_IN: J1.c2, J2.2, SW1.2 (B)
~AI: J1.c32
~CHIP_0: J3.17, JP19.3 (B)
~CHIP_1: J3.18, JP20.3 (B)
~CHIP_2: J3.24, JP19.1 (A)
~CHIP_3: J3.23, JP20.1 (A)
~DI: J1.c31
~DO: J1.c24
~EO: J1.c6
~II: J1.c30
~IVI: J1.c27
~IVO: J1.c13
~LOAD_CLK: J3.20, U3.5 (WE#), U4.5 (WE#)
~MB: J1.c16
~MH: J1.c17
~MI0_0: J3.1, JP3.3 (B)
~MI0_1: J3.2, JP4.3 (B)
~MI0_2: J3.3, JP5.3 (B)
~MI0_3: J3.4, JP6.3 (B)
~MI1_0: J3.5, JP11.3 (B)
~MI1_1: J3.6, JP12.3 (B)
~MI1_2: J3.7, JP13.3 (B)
~MI1_3: J3.8, JP14.3 (B)
~MI2_0: J3.9, JP3.1 (A)
~MI2_1: J3.10, JP4.1 (A)
~MI2_2: J3.11, JP5.1 (A)
~MI2_3: J3.12, JP6.1 (A)
~MI3_0: J3.13, JP11.1 (A)
~MI3_1: J3.14, JP12.1 (A)
~MI3_2: J3.15, JP13.1 (A)
~MI3_3: J3.16, JP14.1 (A)
~MI_S0_0: JP3.2 (C); also elsewhere on the board
~MI_S0_1: JP4.2 (C); also elsewhere on the board
~MI_S0_2: JP5.2 (C); also elsewhere on the board
~MI_S0_3: JP6.2 (C); also elsewhere on the board
~MI_S1_0: JP11.2 (C); also elsewhere on the board
~MI_S1_1: JP12.2 (C); also elsewhere on the board
~MI_S1_2: JP13.2 (C); also elsewhere on the board
~MI_S1_3: JP14.2 (C); also elsewhere on the board
~MI: J1.c19
~MO0_0: J3.40, JP7.3 (B)
~MO0_1: J3.39, JP8.3 (B)
~MO0_2: J3.38, JP9.3 (B)
~MO0_3: J3.37, JP10.3 (B)
~MO1_0: J3.36, JP15.3 (B)
~MO1_1: J3.35, JP16.3 (B)
~MO1_2: J3.34, JP17.3 (B)
~MO1_3: J3.33, JP18.3 (B)
~MO2_0: J3.32, JP7.1 (A)
~MO2_1: J3.31, JP8.1 (A)
~MO2_2: J3.30, JP9.1 (A)
~MO2_3: J3.29, JP10.1 (A)
~MO3_0: J3.28, JP15.1 (A)
~MO3_1: J3.27, JP16.1 (A)
~MO3_2: J3.26, JP17.1 (A)
~MO3_3: J3.25, JP18.1 (A)
~MO_S0_0: JP7.2 (C); also elsewhere on the board
~MO_S0_1: JP8.2 (C); also elsewhere on the board
~MO_S0_2: JP9.2 (C); also elsewhere on the board
~MO_S0_3: JP10.2 (C); also elsewhere on the board
~MO_S1_0: JP15.2 (C); also elsewhere on the board
~MO_S1_1: JP16.2 (C); also elsewhere on the board
~MO_S1_2: JP17.2 (C); also elsewhere on the board
~MO_S1_3: JP18.2 (C); also elsewhere on the board
~MO: J1.c20
~MW: J1.c18
~PO: J1.c25
~PP1: J1.c23
~PP2: J1.c22
~PP4: J1.c21
~RAM_CLK: J3.21, U47.8, U47.11
~RAM_EN: J3.22, U3.32 (OE#), U4.32 (OE#)
~ROM_EN: J3.19, U47.2, U47.5
~SEL_0: JP19.2 (C), U47.3, U47.9
~SEL_1: JP20.2 (C), U47.6, U47.12
~SI: J1.c26
~SO: J1.c15
~XI: J1.c29
~YI: J1.c28

Notes on the sheet:
For memory card 1, JP1: 2-3, JP2: 2-3 For memory card 2, JP1: 1-3, JP2: 1-3

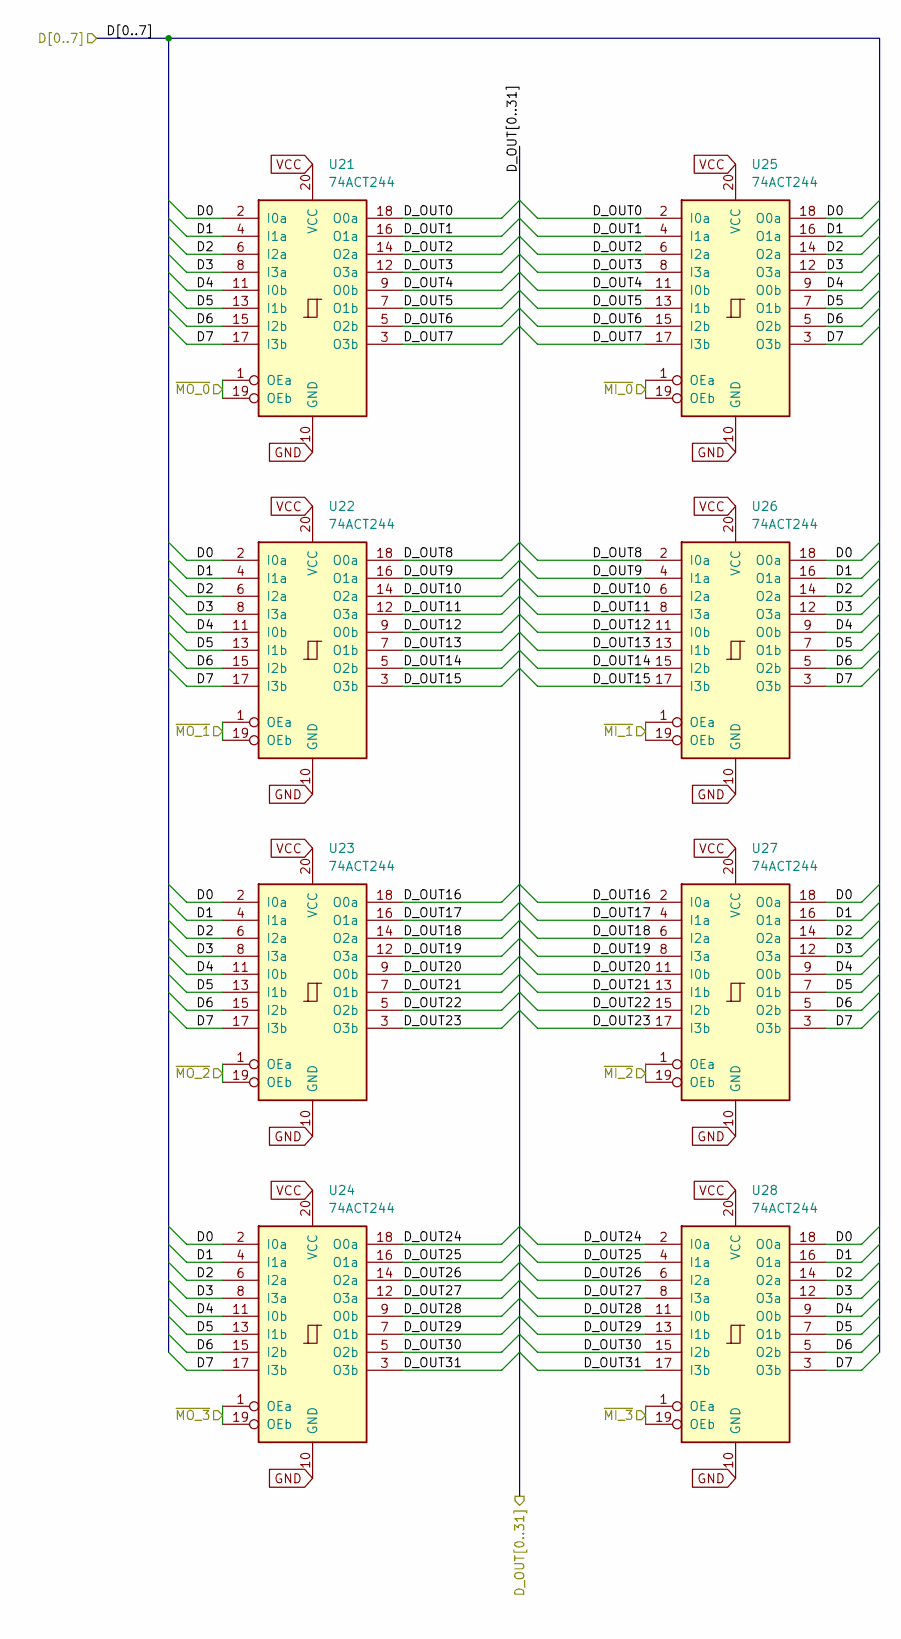
[picture p10: schematic scamp32-memory-data-bus.kicad_sch]

Parts:
U21, U22, U23, U24, U25, U26, U27, U28: 74ACT244; Texas_PW0020A_TSSOP-20_4.4x6.5mm_P0.65mm

Connections:
/B0: U21.18 (O0a), U25.2 (I0a); also elsewhere on the board
/B1: U21.16 (O1a), U25.4 (I1a); also elsewhere on the board
/B2: U21.14 (O2a), U25.6 (I2a); also elsewhere on the board
/B3: U21.12 (O3a), U25.8 (I3a); also elsewhere on the board
/B4: U21.9 (O0b), U25.11 (I0b); also elsewhere on the board
/B5: U21.7 (O1b), U25.13 (I1b); also elsewhere on the board
/B6: U21.5 (O2b), U25.15 (I2b); also elsewhere on the board
/B7: U21.3 (O3b), U25.17 (I3b); also elsewhere on the board
/B8: U22.18 (O0a), U26.2 (I0a); also elsewhere on the board
/B9: U22.16 (O1a), U26.4 (I1a); also elsewhere on the board
/B10: U22.14 (O2a), U26.6 (I2a); also elsewhere on the board
/B11: U22.12 (O3a), U26.8 (I3a); also elsewhere on the board
/B12: U22.9 (O0b), U26.11 (I0b); also elsewhere on the board
/B13: U22.7 (O1b), U26.13 (I1b); also elsewhere on the board
/B14: U22.5 (O2b), U26.15 (I2b); also elsewhere on the board
/B15: U22.3 (O3b), U26.17 (I3b); also elsewhere on the board
/B16: U23.18 (O0a), U27.2 (I0a); also elsewhere on the board
/B17: U23.16 (O1a), U27.4 (I1a); also elsewhere on the board
/B18: U23.14 (O2a), U27.6 (I2a); also elsewhere on the board
/B19: U23.12 (O3a), U27.8 (I3a); also elsewhere on the board
/B20: U23.9 (O0b), U27.11 (I0b); also elsewhere on the board
/B21: U23.7 (O1b), U27.13 (I1b); also elsewhere on the board
/B22: U23.5 (O2b), U27.15 (I2b); also elsewhere on the board
/B23: U23.3 (O3b), U27.17 (I3b); also elsewhere on the board
/B24: U24.18 (O0a), U28.2 (I0a); also elsewhere on the board
/B25: U24.16 (O1a), U28.4 (I1a); also elsewhere on the board
/B26: U24.14 (O2a), U28.6 (I2a); also elsewhere on the board
/B27: U24.12 (O3a), U28.8 (I3a); also elsewhere on the board
/B28: U24.9 (O0b), U28.11 (I0b); also elsewhere on the board
/B29: U24.7 (O1b), U28.13 (I1b); also elsewhere on the board
/B30: U24.5 (O2b), U28.15 (I2b); also elsewhere on the board
/B31: U24.3 (O3b), U28.17 (I3b); also elsewhere on the board
/D00: U21.2 (I0a), U22.2 (I0a), U23.2 (I0a), U24.2 (I0a), U25.18 (O0a), U26.18 (O0a), U27.18 (O0a), U28.18 (O0a); also elsewhere on the board
/D01: U21.4 (I1a), U22.4 (I1a), U23.4 (I1a), U24.4 (I1a), U25.16 (O1a), U26.16 (O1a), U27.16 (O1a), U28.16 (O1a); also elsewhere on the board
/D02: U21.6 (I2a), U22.6 (I2a), U23.6 (I2a), U24.6 (I2a), U25.14 (O2a), U26.14 (O2a), U27.14 (O2a), U28.14 (O2a); also elsewhere on the board
/D03: U21.8 (I3a), U22.8 (I3a), U23.8 (I3a), U24.8 (I3a), U25.12 (O3a), U26.12 (O3a), U27.12 (O3a), U28.12 (O3a); also elsewhere on the board
/D04: U21.11 (I0b), U22.11 (I0b), U23.11 (I0b), U24.11 (I0b), U25.9 (O0b), U26.9 (O0b), U27.9 (O0b), U28.9 (O0b); also elsewhere on the board
/D05: U21.13 (I1b), U22.13 (I1b), U23.13 (I1b), U24.13 (I1b), U25.7 (O1b), U26.7 (O1b), U27.7 (O1b), U28.7 (O1b); also elsewhere on the board
/D06: U21.15 (I2b), U22.15 (I2b), U23.15 (I2b), U24.15 (I2b), U25.5 (O2b), U26.5 (O2b), U27.5 (O2b), U28.5 (O2b); also elsewhere on the board
/D07: U21.17 (I3b), U22.17 (I3b), U23.17 (I3b), U24.17 (I3b), U25.3 (O3b), U26.3 (O3b), U27.3 (O3b), U28.3 (O3b); also elsewhere on the board
GND: U21.10 (GND), U22.10 (GND), U23.10 (GND), U24.10 (GND), U25.10 (GND), U26.10 (GND), U27.10 (GND), U28.10 (GND); also elsewhere on the board
VCC: U21.20 (VCC), U22.20 (VCC), U23.20 (VCC), U24.20 (VCC), U25.20 (VCC), U26.20 (VCC), U27.20 (VCC), U28.20 (VCC); also elsewhere on the board
~MI_S0_0: U25.1 (OEa), U25.19 (OEb); also elsewhere on the board
~MI_S0_1: U26.1 (OEa), U26.19 (OEb); also elsewhere on the board
~MI_S0_2: U27.1 (OEa), U27.19 (OEb); also elsewhere on the board
~MI_S0_3: U28.1 (OEa), U28.19 (OEb); also elsewhere on the board
~MO_S0_0: U21.1 (OEa), U21.19 (OEb); also elsewhere on the board
~MO_S0_1: U22.1 (OEa), U22.19 (OEb); also elsewhere on the board
~MO_S0_2: U23.1 (OEa), U23.19 (OEb); also elsewhere on the board
~MO_S0_3: U24.1 (OEa), U24.19 (OEb); also elsewhere on the board

Parts of its further copies:
U29, U30, U31, U32, U33, U34, U35, U36: 74ACT244; Texas_PW0020A_TSSOP-20_4.4x6.5mm_P0.65mm

Connections of its further copies:
/B0: U29.18 (O0a), U33.2 (I0a); also elsewhere on the board
/B1: U29.16 (O1a), U33.4 (I1a); also elsewhere on the board
/B2: U29.14 (O2a), U33.6 (I2a); also elsewhere on the board
/B3: U29.12 (O3a), U33.8 (I3a); also elsewhere on the board
/B4: U29.9 (O0b), U33.11 (I0b); also elsewhere on the board
/B5: U29.7 (O1b), U33.13 (I1b); also elsewhere on the board
/B6: U29.5 (O2b), U33.15 (I2b); also elsewhere on the board
/B7: U29.3 (O3b), U33.17 (I3b); also elsewhere on the board
/B8: U30.18 (O0a), U34.2 (I0a); also elsewhere on the board
/B9: U30.16 (O1a), U34.4 (I1a); also elsewhere on the board
/B10: U30.14 (O2a), U34.6 (I2a); also elsewhere on the board
/B11: U30.12 (O3a), U34.8 (I3a); also elsewhere on the board
/B12: U30.9 (O0b), U34.11 (I0b); also elsewhere on the board
/B13: U30.7 (O1b), U34.13 (I1b); also elsewhere on the board
/B14: U30.5 (O2b), U34.15 (I2b); also elsewhere on the board
/B15: U30.3 (O3b), U34.17 (I3b); also elsewhere on the board
/B16: U31.18 (O0a), U35.2 (I0a); also elsewhere on the board
/B17: U31.16 (O1a), U35.4 (I1a); also elsewhere on the board
/B18: U31.14 (O2a), U35.6 (I2a); also elsewhere on the board
/B19: U31.12 (O3a), U35.8 (I3a); also elsewhere on the board
/B20: U31.9 (O0b), U35.11 (I0b); also elsewhere on the board
/B21: U31.7 (O1b), U35.13 (I1b); also elsewhere on the board
/B22: U31.5 (O2b), U35.15 (I2b); also elsewhere on the board
/B23: U31.3 (O3b), U35.17 (I3b); also elsewhere on the board
/B24: U32.18 (O0a), U36.2 (I0a); also elsewhere on the board
/B25: U32.16 (O1a), U36.4 (I1a); also elsewhere on the board
/B26: U32.14 (O2a), U36.6 (I2a); also elsewhere on the board
/B27: U32.12 (O3a), U36.8 (I3a); also elsewhere on the board
/B28: U32.9 (O0b), U36.11 (I0b); also elsewhere on the board
/B29: U32.7 (O1b), U36.13 (I1b); also elsewhere on the board
/B30: U32.5 (O2b), U36.15 (I2b); also elsewhere on the board
/B31: U32.3 (O3b), U36.17 (I3b); also elsewhere on the board
/D10: U29.2 (I0a), U30.2 (I0a), U31.2 (I0a), U32.2 (I0a), U33.18 (O0a), U34.18 (O0a), U35.18 (O0a), U36.18 (O0a); also elsewhere on the board
/D11: U29.4 (I1a), U30.4 (I1a), U31.4 (I1a), U32.4 (I1a), U33.16 (O1a), U34.16 (O1a), U35.16 (O1a), U36.16 (O1a); also elsewhere on the board
/D12: U29.6 (I2a), U30.6 (I2a), U31.6 (I2a), U32.6 (I2a), U33.14 (O2a), U34.14 (O2a), U35.14 (O2a), U36.14 (O2a); also elsewhere on the board
/D13: U29.8 (I3a), U30.8 (I3a), U31.8 (I3a), U32.8 (I3a), U33.12 (O3a), U34.12 (O3a), U35.12 (O3a), U36.12 (O3a); also elsewhere on the board
/D14: U29.11 (I0b), U30.11 (I0b), U31.11 (I0b), U32.11 (I0b), U33.9 (O0b), U34.9 (O0b), U35.9 (O0b), U36.9 (O0b); also elsewhere on the board
/D15: U29.13 (I1b), U30.13 (I1b), U31.13 (I1b), U32.13 (I1b), U33.7 (O1b), U34.7 (O1b), U35.7 (O1b), U36.7 (O1b); also elsewhere on the board
/D16: U29.15 (I2b), U30.15 (I2b), U31.15 (I2b), U32.15 (I2b), U33.5 (O2b), U34.5 (O2b), U35.5 (O2b), U36.5 (O2b); also elsewhere on the board
/D17: U29.17 (I3b), U30.17 (I3b), U31.17 (I3b), U32.17 (I3b), U33.3 (O3b), U34.3 (O3b), U35.3 (O3b), U36.3 (O3b); also elsewhere on the board
GND: U29.10 (GND), U30.10 (GND), U31.10 (GND), U32.10 (GND), U33.10 (GND), U34.10 (GND), U35.10 (GND), U36.10 (GND); also elsewhere on the board
VCC: U29.20 (VCC), U30.20 (VCC), U31.20 (VCC), U32.20 (VCC), U33.20 (VCC), U34.20 (VCC), U35.20 (VCC), U36.20 (VCC); also elsewhere on the board
~MI_S1_0: U33.1 (OEa), U33.19 (OEb); also elsewhere on the board
~MI_S1_1: U34.1 (OEa), U34.19 (OEb); also elsewhere on the board
~MI_S1_2: U35.1 (OEa), U35.19 (OEb); also elsewhere on the board
~MI_S1_3: U36.1 (OEa), U36.19 (OEb); also elsewhere on the board
~MO_S1_0: U29.1 (OEa), U29.19 (OEb); also elsewhere on the board
~MO_S1_1: U30.1 (OEa), U30.19 (OEb); also elsewhere on the board
~MO_S1_2: U31.1 (OEa), U31.19 (OEb); also elsewhere on the board
~MO_S1_3: U32.1 (OEa), U32.19 (OEb); also elsewhere on the board
