BenskiBoy/scamp-32/kicad/scamp32-memory/_restore_backup_2026-09-26T09-44-30-685/scamp32-memory.kicad_pcb

## KiCad design kicad/scamp32-memory/_restore_backup_2026-09-26T09-44-30-685/scamp32-memory.kicad_pcb (continued)

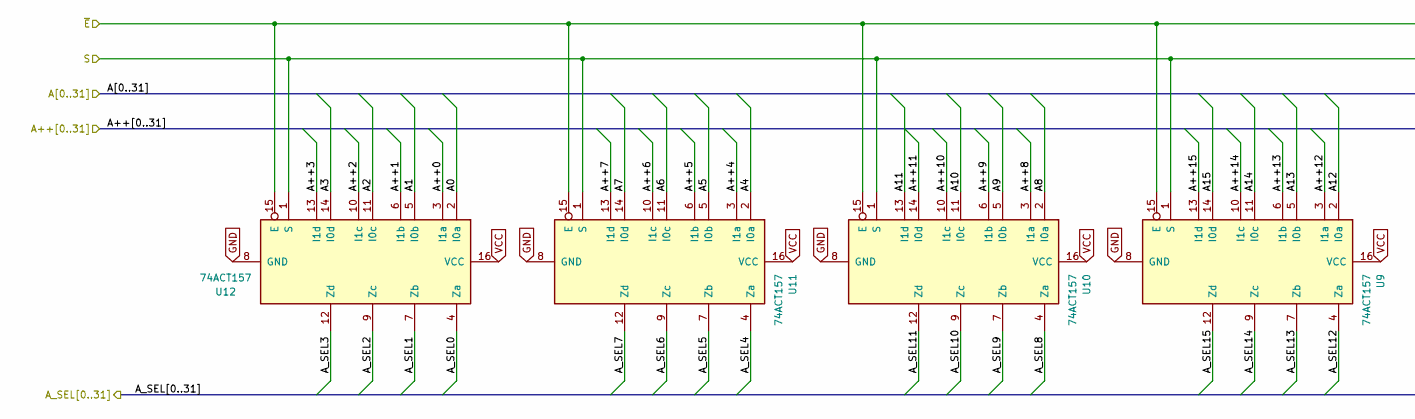
[picture p11: schematic samp32-memory-mux.kicad_sch, part in row 1, column 1]

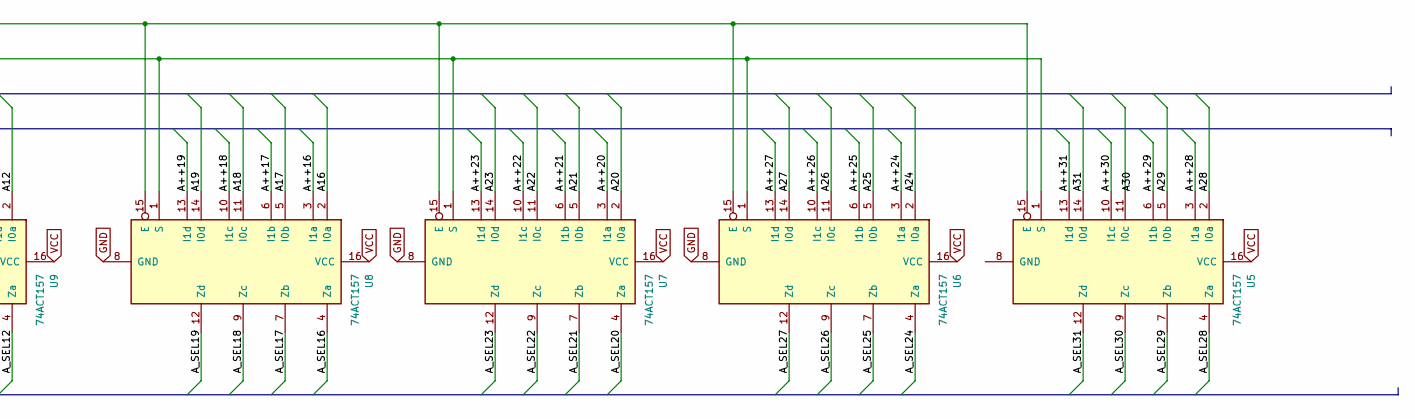
[picture p12: schematic samp32-memory-mux.kicad_sch, part in row 1, column 2]

Parts:
U5, U6, U7, U8, U9, U10, U11, U12: 74ACT157; TSSOP-16_4.4x5mm_P0.65mm

Connections:
/A0: U12.2 (I0a); also elsewhere on the board
/A1: U12.5 (I0b); also elsewhere on the board
/A2: U12.11 (I0c); also elsewhere on the board
/A3: U12.14 (I0d); also elsewhere on the board
/A4: U11.2 (I0a); also elsewhere on the board
/A5: U11.5 (I0b); also elsewhere on the board
/A6: U11.11 (I0c); also elsewhere on the board
/A7: U11.14 (I0d); also elsewhere on the board
/A8: U10.2 (I0a); also elsewhere on the board
/A9: U10.5 (I0b); also elsewhere on the board
/A10: U10.11 (I0c); also elsewhere on the board
/A11: U10.13 (I1d); also elsewhere on the board
/A12: U9.2 (I0a); also elsewhere on the board
/A13: U9.5 (I0b); also elsewhere on the board
/A14: U9.11 (I0c); also elsewhere on the board
/A15: U9.14 (I0d); also elsewhere on the board
/A16: U8.2 (I0a); also elsewhere on the board
/A17: U8.5 (I0b); also elsewhere on the board
/A18: U8.11 (I0c); also elsewhere on the board
/A19: U8.14 (I0d); also elsewhere on the board
/A20: U7.2 (I0a); also elsewhere on the board
/A21: U7.5 (I0b); also elsewhere on the board
/A22: U7.11 (I0c); also elsewhere on the board
/A23: U7.14 (I0d); also elsewhere on the board
/A24: U6.2 (I0a); also elsewhere on the board
/A25: U6.5 (I0b); also elsewhere on the board
/A26: U6.11 (I0c); also elsewhere on the board
/A27: U6.14 (I0d); also elsewhere on the board
/A28: U5.2 (I0a); also elsewhere on the board
/A29: U5.5 (I0b); also elsewhere on the board
/A31: U5.14 (I0d); also elsewhere on the board
/samp32-memory-mux/A++0: U12.3 (I1a); also elsewhere on the board
/samp32-memory-mux/A++1: U12.6 (I1b); also elsewhere on the board
/samp32-memory-mux/A++2: U12.10 (I1c); also elsewhere on the board
/samp32-memory-mux/A++3: U12.13 (I1d); also elsewhere on the board
/samp32-memory-mux/A++4: U11.3 (I1a); also elsewhere on the board
/samp32-memory-mux/A++5: U11.6 (I1b); also elsewhere on the board
/samp32-memory-mux/A++6: U11.10 (I1c); also elsewhere on the board
/samp32-memory-mux/A++7: U11.13 (I1d); also elsewhere on the board
/samp32-memory-mux/A++8: U10.3 (I1a); also elsewhere on the board
/samp32-memory-mux/A++9: U10.6 (I1b); also elsewhere on the board
/samp32-memory-mux/A++10: U10.10 (I1c); also elsewhere on the board
/samp32-memory-mux/A++11: U10.14 (I0d); also elsewhere on the board
/samp32-memory-mux/A++12: U9.3 (I1a); also elsewhere on the board
/samp32-memory-mux/A++13: U9.6 (I1b); also elsewhere on the board
/samp32-memory-mux/A++14: U9.10 (I1c); also elsewhere on the board
/samp32-memory-mux/A++15: U9.13 (I1d); also elsewhere on the board
/samp32-memory-mux/A++16: U8.3 (I1a); also elsewhere on the board
/samp32-memory-mux/A++17: U8.6 (I1b); also elsewhere on the board
/samp32-memory-mux/A++18: U8.10 (I1c); also elsewhere on the board
/samp32-memory-mux/A++19: U8.13 (I1d); also elsewhere on the board
/samp32-memory-mux/A++20: U7.3 (I1a); also elsewhere on the board
/samp32-memory-mux/A++21: U7.6 (I1b); also elsewhere on the board
/samp32-memory-mux/A++22: U7.10 (I1c); also elsewhere on the board
/samp32-memory-mux/A++23: U7.13 (I1d); also elsewhere on the board
/samp32-memory-mux/A++24: U6.3 (I1a); also elsewhere on the board
/samp32-memory-mux/A++25: U6.6 (I1b); also elsewhere on the board
/samp32-memory-mux/A++26: U6.10 (I1c); also elsewhere on the board
/samp32-memory-mux/A++27: U6.13 (I1d); also elsewhere on the board
/samp32-memory-mux/A++28: U5.3 (I1a); also elsewhere on the board
/samp32-memory-mux/A++29: U5.6 (I1b); also elsewhere on the board
/samp32-memory-mux/A++30: U5.10 (I1c); also elsewhere on the board
/samp32-memory-mux/A++31: U5.13 (I1d); also elsewhere on the board
/samp32-memory-mux/A_SEL0: U12.4 (Za); also elsewhere on the board
/samp32-memory-mux/A_SEL1: U12.7 (Zb); also elsewhere on the board
/samp32-memory-mux/A_SEL2: U12.9 (Zc); also elsewhere on the board
/samp32-memory-mux/A_SEL3: U12.12 (Zd); also elsewhere on the board
/samp32-memory-mux/A_SEL4: U11.4 (Za); also elsewhere on the board
/samp32-memory-mux/A_SEL5: U11.7 (Zb); also elsewhere on the board
/samp32-memory-mux/A_SEL6: U11.9 (Zc); also elsewhere on the board
/samp32-memory-mux/A_SEL7: U11.12 (Zd); also elsewhere on the board
/samp32-memory-mux/A_SEL8: U10.4 (Za); also elsewhere on the board
/samp32-memory-mux/A_SEL9: U10.7 (Zb); also elsewhere on the board
/samp32-memory-mux/A_SEL10: U10.9 (Zc); also elsewhere on the board
/samp32-memory-mux/A_SEL11: U10.12 (Zd); also elsewhere on the board
/samp32-memory-mux/A_SEL12: U9.4 (Za); also elsewhere on the board
/samp32-memory-mux/A_SEL13: U9.7 (Zb); also elsewhere on the board
/samp32-memory-mux/A_SEL14: U9.9 (Zc); also elsewhere on the board
/samp32-memory-mux/A_SEL15: U9.12 (Zd); also elsewhere on the board
/samp32-memory-mux/A_SEL16: U8.4 (Za); also elsewhere on the board
/samp32-memory-mux/A_SEL17: U8.7 (Zb); also elsewhere on the board
/samp32-memory-mux/A_SEL18: U8.9 (Zc); also elsewhere on the board
/samp32-memory-mux/A_SEL19: U8.12 (Zd)
/samp32-memory-mux/A_SEL20: U7.4 (Za)
/samp32-memory-mux/A_SEL21: U7.7 (Zb)
/samp32-memory-mux/A_SEL22: U7.9 (Zc)
/samp32-memory-mux/A_SEL23: U7.12 (Zd)
/samp32-memory-mux/A_SEL24: U6.4 (Za)
/samp32-memory-mux/A_SEL25: U6.7 (Zb)
/samp32-memory-mux/A_SEL26: U6.9 (Zc)
/samp32-memory-mux/A_SEL27: U6.12 (Zd)
/samp32-memory-mux/A_SEL28: U5.4 (Za)
/samp32-memory-mux/A_SEL29: U5.7 (Zb)
/samp32-memory-mux/A_SEL30: U5.9 (Zc)
/samp32-memory-mux/A_SEL31: U5.12 (Zd)
/samp32-memory-mux/S: U5.1 (S), U6.1 (S), U7.1 (S), U8.1 (S), U9.1 (S), U10.1 (S), U11.1 (S), U12.1 (S); also elsewhere on the board
GND: U5.15 (E), U6.8 (GND), U6.15 (E), U7.8 (GND), U7.15 (E), U8.8 (GND), U8.15 (E), U9.8 (GND), U9.15 (E), U10.8 (GND), U10.15 (E), U11.8 (GND), U11.15 (E), U12.8 (GND), U12.15 (E); also elsewhere on the board
VCC: U5.16 (VCC), U6.16 (VCC), U7.16 (VCC), U8.16 (VCC), U9.16 (VCC), U10.16 (VCC), U11.16 (VCC), U12.16 (VCC); also elsewhere on the board

Parts of its further copies:
U13, U14, U15, U16, U17, U18, U19, U20: 74ACT157; TSSOP-16_4.4x5mm_P0.65mm

Connections of its further copies:
/A0: U13.2 (I0a); also elsewhere on the board
/A1: U13.5 (I0b); also elsewhere on the board
/A2: U13.11 (I0c); also elsewhere on the board
/A3: U13.14 (I0d); also elsewhere on the board
/A4: U14.2 (I0a); also elsewhere on the board
/A5: U14.5 (I0b); also elsewhere on the board
/A6: U14.11 (I0c); also elsewhere on the board
/A7: U14.14 (I0d); also elsewhere on the board
/A8: U15.2 (I0a); also elsewhere on the board
/A9: U15.5 (I0b); also elsewhere on the board
/A10: U15.11 (I0c); also elsewhere on the board
/A11: U15.13 (I1d); also elsewhere on the board
/A12: U16.2 (I0a); also elsewhere on the board
/A13: U16.5 (I0b); also elsewhere on the board
/A14: U16.11 (I0c); also elsewhere on the board
/A15: U16.14 (I0d); also elsewhere on the board
/A16: U17.2 (I0a); also elsewhere on the board
/A17: U17.5 (I0b); also elsewhere on the board
/A18: U17.11 (I0c); also elsewhere on the board
/A19: U17.14 (I0d); also elsewhere on the board
/A20: U18.2 (I0a); also elsewhere on the board
/A21: U18.5 (I0b); also elsewhere on the board
/A22: U18.11 (I0c); also elsewhere on the board
/A23: U18.14 (I0d); also elsewhere on the board
/A24: U19.2 (I0a); also elsewhere on the board
/A25: U19.5 (I0b); also elsewhere on the board
/A26: U19.11 (I0c); also elsewhere on the board
/A27: U19.14 (I0d); also elsewhere on the board
/A28: U20.2 (I0a); also elsewhere on the board
/A29: U20.5 (I0b); also elsewhere on the board
/A31: U20.14 (I0d); also elsewhere on the board
/samp32-memory-mux1/A_SEL19: U17.12 (Zd)
/samp32-memory-mux1/A_SEL20: U18.4 (Za)
/samp32-memory-mux1/A_SEL21: U18.7 (Zb)
/samp32-memory-mux1/A_SEL22: U18.9 (Zc)
/samp32-memory-mux1/A_SEL23: U18.12 (Zd)
/samp32-memory-mux1/A_SEL24: U19.4 (Za)
/samp32-memory-mux1/A_SEL25: U19.7 (Zb)
/samp32-memory-mux1/A_SEL26: U19.9 (Zc)
/samp32-memory-mux1/A_SEL27: U19.12 (Zd)
/samp32-memory-mux1/A_SEL28: U20.4 (Za)
/samp32-memory-mux1/A_SEL29: U20.7 (Zb)
/samp32-memory-mux1/A_SEL30: U20.9 (Zc)
/samp32-memory-mux1/A_SEL31: U20.12 (Zd)
/samp32-memory-mux1/S: U13.1 (S), U14.1 (S), U15.1 (S), U16.1 (S), U17.1 (S), U18.1 (S), U19.1 (S), U20.1 (S); also elsewhere on the board
/samp32-memory-mux/A++0: U13.3 (I1a); also elsewhere on the board
/samp32-memory-mux/A++1: U13.6 (I1b); also elsewhere on the board
/samp32-memory-mux/A++2: U13.10 (I1c); also elsewhere on the board
/samp32-memory-mux/A++3: U13.13 (I1d); also elsewhere on the board
/samp32-memory-mux/A++4: U14.3 (I1a); also elsewhere on the board
/samp32-memory-mux/A++5: U14.6 (I1b); also elsewhere on the board
/samp32-memory-mux/A++6: U14.10 (I1c); also elsewhere on the board
/samp32-memory-mux/A++7: U14.13 (I1d); also elsewhere on the board
/samp32-memory-mux/A++8: U15.3 (I1a); also elsewhere on the board
/samp32-memory-mux/A++9: U15.6 (I1b); also elsewhere on the board
/samp32-memory-mux/A++10: U15.10 (I1c); also elsewhere on the board
/samp32-memory-mux/A++11: U15.14 (I0d); also elsewhere on the board
/samp32-memory-mux/A++12: U16.3 (I1a); also elsewhere on the board
/samp32-memory-mux/A++13: U16.6 (I1b); also elsewhere on the board
/samp32-memory-mux/A++14: U16.10 (I1c); also elsewhere on the board
/samp32-memory-mux/A++15: U16.13 (I1d); also elsewhere on the board
/samp32-memory-mux/A++16: U17.3 (I1a); also elsewhere on the board
/samp32-memory-mux/A++17: U17.6 (I1b); also elsewhere on the board
/samp32-memory-mux/A++18: U17.10 (I1c); also elsewhere on the board
/samp32-memory-mux/A++19: U17.13 (I1d); also elsewhere on the board
/samp32-memory-mux/A++20: U18.3 (I1a); also elsewhere on the board
/samp32-memory-mux/A++21: U18.6 (I1b); also elsewhere on the board
/samp32-memory-mux/A++22: U18.10 (I1c); also elsewhere on the board
/samp32-memory-mux/A++23: U18.13 (I1d); also elsewhere on the board
/samp32-memory-mux/A++24: U19.3 (I1a); also elsewhere on the board
/samp32-memory-mux/A++25: U19.6 (I1b); also elsewhere on the board
/samp32-memory-mux/A++26: U19.10 (I1c); also elsewhere on the board
/samp32-memory-mux/A++27: U19.13 (I1d); also elsewhere on the board
/samp32-memory-mux/A++28: U20.3 (I1a); also elsewhere on the board
/samp32-memory-mux/A++29: U20.6 (I1b); also elsewhere on the board
/samp32-memory-mux/A++30: U20.10 (I1c); also elsewhere on the board
/samp32-memory-mux/A++31: U20.13 (I1d); also elsewhere on the board
/samp32-memory-mux/A_SEL0: U13.4 (Za); also elsewhere on the board
/samp32-memory-mux/A_SEL1: U13.7 (Zb); also elsewhere on the board
/samp32-memory-mux/A_SEL2: U13.9 (Zc); also elsewhere on the board
/samp32-memory-mux/A_SEL3: U13.12 (Zd); also elsewhere on the board
/samp32-memory-mux/A_SEL4: U14.4 (Za); also elsewhere on the board
/samp32-memory-mux/A_SEL5: U14.7 (Zb); also elsewhere on the board
/samp32-memory-mux/A_SEL6: U14.9 (Zc); also elsewhere on the board
/samp32-memory-mux/A_SEL7: U14.12 (Zd); also elsewhere on the board
/samp32-memory-mux/A_SEL8: U15.4 (Za); also elsewhere on the board
/samp32-memory-mux/A_SEL9: U15.7 (Zb); also elsewhere on the board
/samp32-memory-mux/A_SEL10: U15.9 (Zc); also elsewhere on the board
/samp32-memory-mux/A_SEL11: U15.12 (Zd); also elsewhere on the board
/samp32-memory-mux/A_SEL12: U16.4 (Za); also elsewhere on the board
/samp32-memory-mux/A_SEL13: U16.7 (Zb); also elsewhere on the board
/samp32-memory-mux/A_SEL14: U16.9 (Zc); also elsewhere on the board
/samp32-memory-mux/A_SEL15: U16.12 (Zd); also elsewhere on the board
/samp32-memory-mux/A_SEL16: U17.4 (Za); also elsewhere on the board
/samp32-memory-mux/A_SEL17: U17.7 (Zb); also elsewhere on the board
/samp32-memory-mux/A_SEL18: U17.9 (Zc); also elsewhere on the board
GND: U13.8 (GND), U13.15 (E), U14.8 (GND), U14.15 (E), U15.8 (GND), U15.15 (E), U16.8 (GND), U16.15 (E), U17.8 (GND), U17.15 (E), U18.8 (GND), U18.15 (E), U19.8 (GND), U19.15 (E), U20.15 (E); also elsewhere on the board
VCC: U13.16 (VCC), U14.16 (VCC), U15.16 (VCC), U16.16 (VCC), U17.16 (VCC), U18.16 (VCC), U19.16 (VCC), U20.16 (VCC); also elsewhere on the board

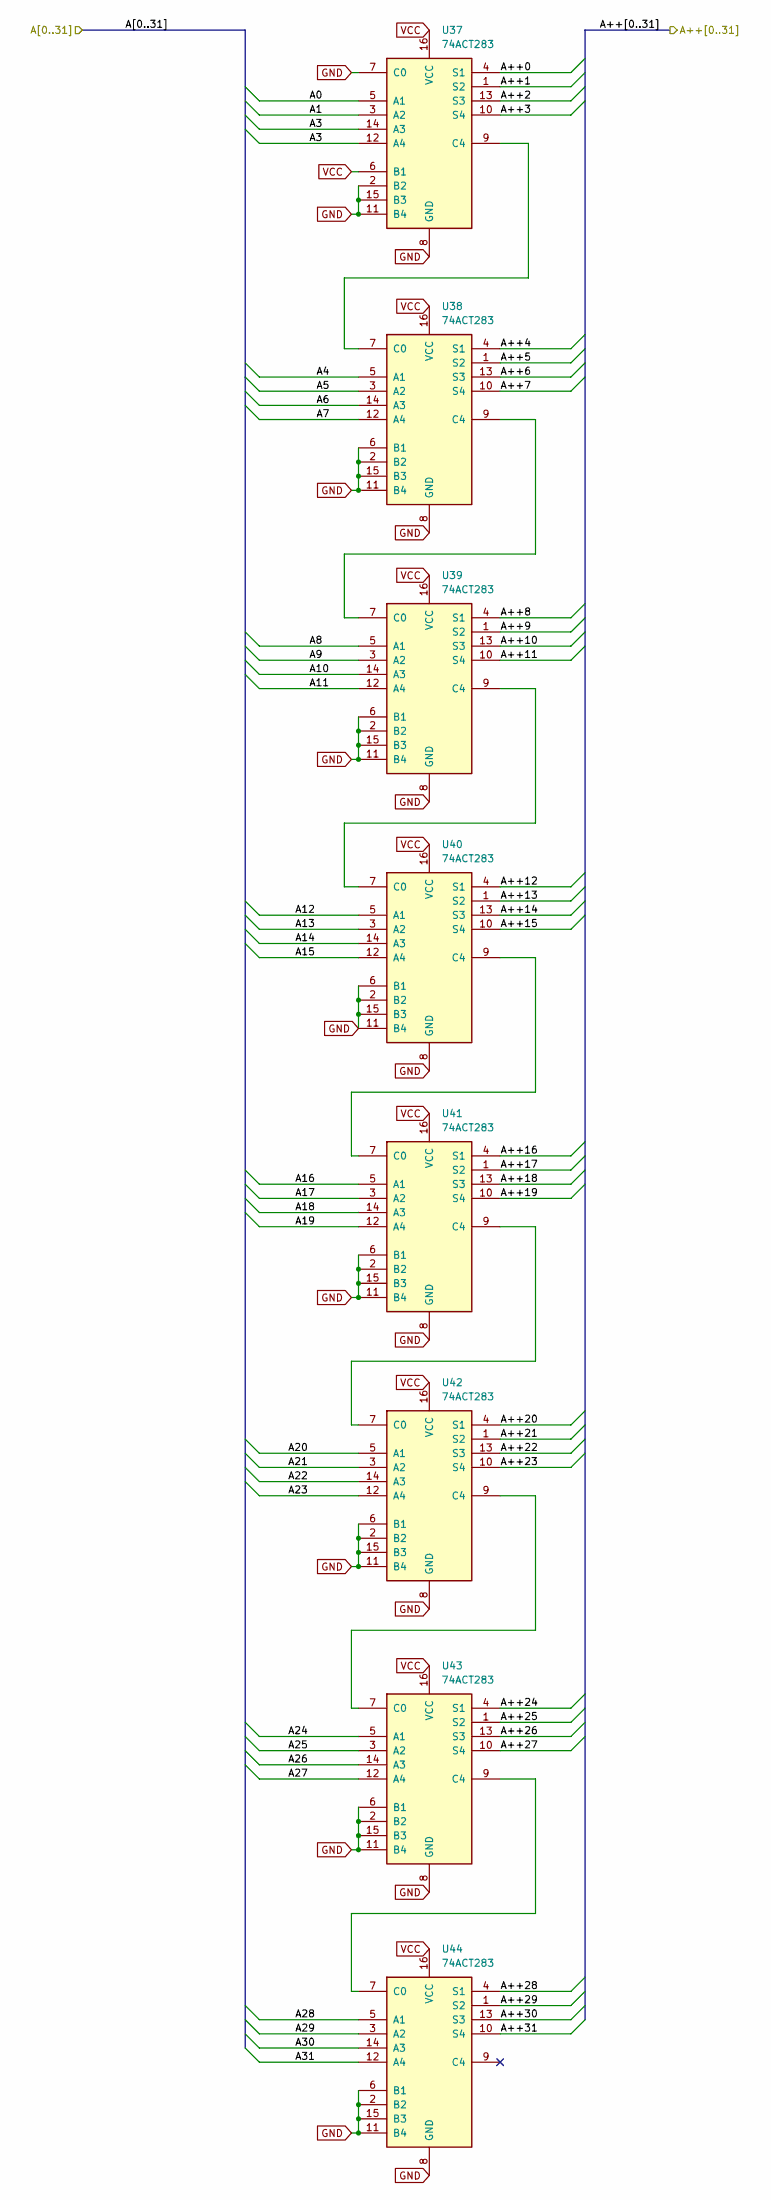
[picture p13: schematic scamp32-memory-address-adder.kicad_sch]

Parts:
U37, U38, U39, U40, U41, U42, U43, U44: 74ACT283; TSSOP-16_4.4x5mm_P0.65mm

Connections:
/A0: U37.5 (A1); also elsewhere on the board
/A1: U37.3 (A2); also elsewhere on the board
/A3: U37.12 (A4), U37.14 (A3); also elsewhere on the board
/A4: U38.5 (A1); also elsewhere on the board
/A5: U38.3 (A2); also elsewhere on the board
/A6: U38.14 (A3); also elsewhere on the board
/A7: U38.12 (A4); also elsewhere on the board
/A8: U39.5 (A1); also elsewhere on the board
/A9: U39.3 (A2); also elsewhere on the board
/A10: U39.14 (A3); also elsewhere on the board
/A11: U39.12 (A4); also elsewhere on the board
/A12: U40.5 (A1); also elsewhere on the board
/A13: U40.3 (A2); also elsewhere on the board
/A14: U40.14 (A3); also elsewhere on the board
/A15: U40.12 (A4); also elsewhere on the board
/A16: U41.5 (A1); also elsewhere on the board
/A17: U41.3 (A2); also elsewhere on the board
/A18: U41.14 (A3); also elsewhere on the board
/A19: U41.12 (A4); also elsewhere on the board
/A20: U42.5 (A1); also elsewhere on the board
/A21: U42.3 (A2); also elsewhere on the board
/A22: U42.14 (A3); also elsewhere on the board
/A23: U42.12 (A4); also elsewhere on the board
/A24: U43.5 (A1); also elsewhere on the board
/A25: U43.3 (A2); also elsewhere on the board
/A26: U43.14 (A3); also elsewhere on the board
/A27: U43.12 (A4); also elsewhere on the board
/A28: U44.5 (A1); also elsewhere on the board
/A29: U44.3 (A2); also elsewhere on the board
/A30: U44.14 (A3); also elsewhere on the board
/A31: U44.12 (A4); also elsewhere on the board
/samp32-memory-mux/A++0: U37.4 (S1); also elsewhere on the board
/samp32-memory-mux/A++1: U37.1 (S2); also elsewhere on the board
/samp32-memory-mux/A++2: U37.13 (S3); also elsewhere on the board
/samp32-memory-mux/A++3: U37.10 (S4); also elsewhere on the board
/samp32-memory-mux/A++4: U38.4 (S1); also elsewhere on the board
/samp32-memory-mux/A++5: U38.1 (S2); also elsewhere on the board
/samp32-memory-mux/A++6: U38.13 (S3); also elsewhere on the board
/samp32-memory-mux/A++7: U38.10 (S4); also elsewhere on the board
/samp32-memory-mux/A++8: U39.4 (S1); also elsewhere on the board
/samp32-memory-mux/A++9: U39.1 (S2); also elsewhere on the board
/samp32-memory-mux/A++10: U39.13 (S3); also elsewhere on the board
/samp32-memory-mux/A++11: U39.10 (S4); also elsewhere on the board
/samp32-memory-mux/A++12: U40.4 (S1); also elsewhere on the board
/samp32-memory-mux/A++13: U40.1 (S2); also elsewhere on the board
/samp32-memory-mux/A++14: U40.13 (S3); also elsewhere on the board
/samp32-memory-mux/A++15: U40.10 (S4); also elsewhere on the board
/samp32-memory-mux/A++16: U41.4 (S1); also elsewhere on the board
/samp32-memory-mux/A++17: U41.1 (S2); also elsewhere on the board
/samp32-memory-mux/A++18: U41.13 (S3); also elsewhere on the board
/samp32-memory-mux/A++19: U41.10 (S4); also elsewhere on the board
/samp32-memory-mux/A++20: U42.4 (S1); also elsewhere on the board
/samp32-memory-mux/A++21: U42.1 (S2); also elsewhere on the board
/samp32-memory-mux/A++22: U42.13 (S3); also elsewhere on the board
/samp32-memory-mux/A++23: U42.10 (S4); also elsewhere on the board
/samp32-memory-mux/A++24: U43.4 (S1); also elsewhere on the board
/samp32-memory-mux/A++25: U43.1 (S2); also elsewhere on the board
/samp32-memory-mux/A++26: U43.13 (S3); also elsewhere on the board
/samp32-memory-mux/A++27: U43.10 (S4); also elsewhere on the board
/samp32-memory-mux/A++28: U44.4 (S1); also elsewhere on the board
/samp32-memory-mux/A++29: U44.1 (S2); also elsewhere on the board
/samp32-memory-mux/A++30: U44.13 (S3); also elsewhere on the board
/samp32-memory-mux/A++31: U44.10 (S4); also elsewhere on the board
GND: U37.2 (B2), U37.7 (C0), U37.8 (GND), U37.11 (B4), U37.15 (B3), U38.2 (B2), U38.6 (B1), U38.8 (GND), U38.11 (B4), U38.15 (B3), U39.2 (B2), U39.6 (B1), U39.8 (GND), U39.11 (B4), U39.15 (B3), U40.2 (B2), U40.6 (B1), U40.8 (GND), U40.11 (B4), U40.15 (B3), U41.2 (B2), U41.6 (B1), U41.8 (GND), U41.11 (B4), U41.15 (B3), U42.2 (B2), U42.6 (B1), U42.8 (GND), U42.11 (B4), U42.15 (B3), U43.2 (B2), U43.6 (B1), U43.8 (GND), U43.11 (B4), U43.15 (B3), U44.2 (B2), U44.6 (B1), U44.8 (GND), U44.11 (B4), U44.15 (B3); also elsewhere on the board
unnamed: U37.9 (C4), U38.7 (C0)
unnamed: U38.9 (C4), U39.7 (C0)
unnamed: U39.9 (C4), U40.7 (C0)
unnamed: U40.9 (C4), U41.7 (C0)
unnamed: U41.9 (C4), U42.7 (C0)
unnamed: U42.9 (C4), U43.7 (C0)
unnamed: U43.9 (C4), U44.7 (C0)
VCC: U37.6 (B1), U37.16 (VCC), U38.16 (VCC), U39.16 (VCC), U40.16 (VCC), U41.16 (VCC), U43.16 (VCC), U44.16 (VCC); also elsewhere on the board

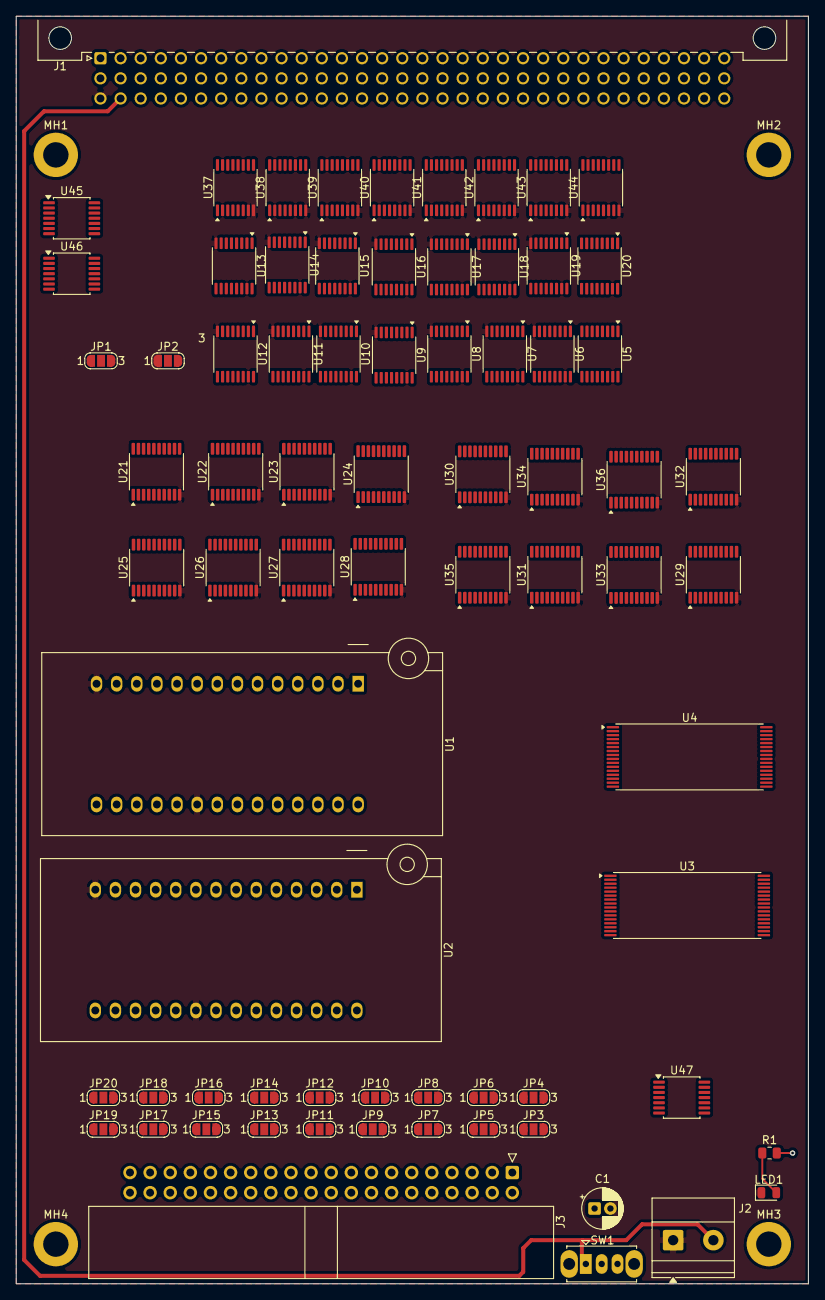
[picture p14: board kicad/scamp32-memory/_restore_backup_2026-09-26T09-44-30-685/scamp32-… from above]

Board: 4 copper layers, 100.0 x 160.0 mm, 78 parts (0 on the bottom side), 208 nets.

Other parts of the board:
MH1, MH2, MH3, MH4: MountingHole_3.2mm_M3_DIN965_Pad
