BenskiBoy/scamp-32/kicad/scamp-plus/_restore_backup_2026-09-13T19-42-04-211/scamp++.kicad_pcb

## KiCad design kicad/scamp-plus/_restore_backup_2026-09-13T19-42-04-211/scamp++.kicad_pcb (2026-09-10)

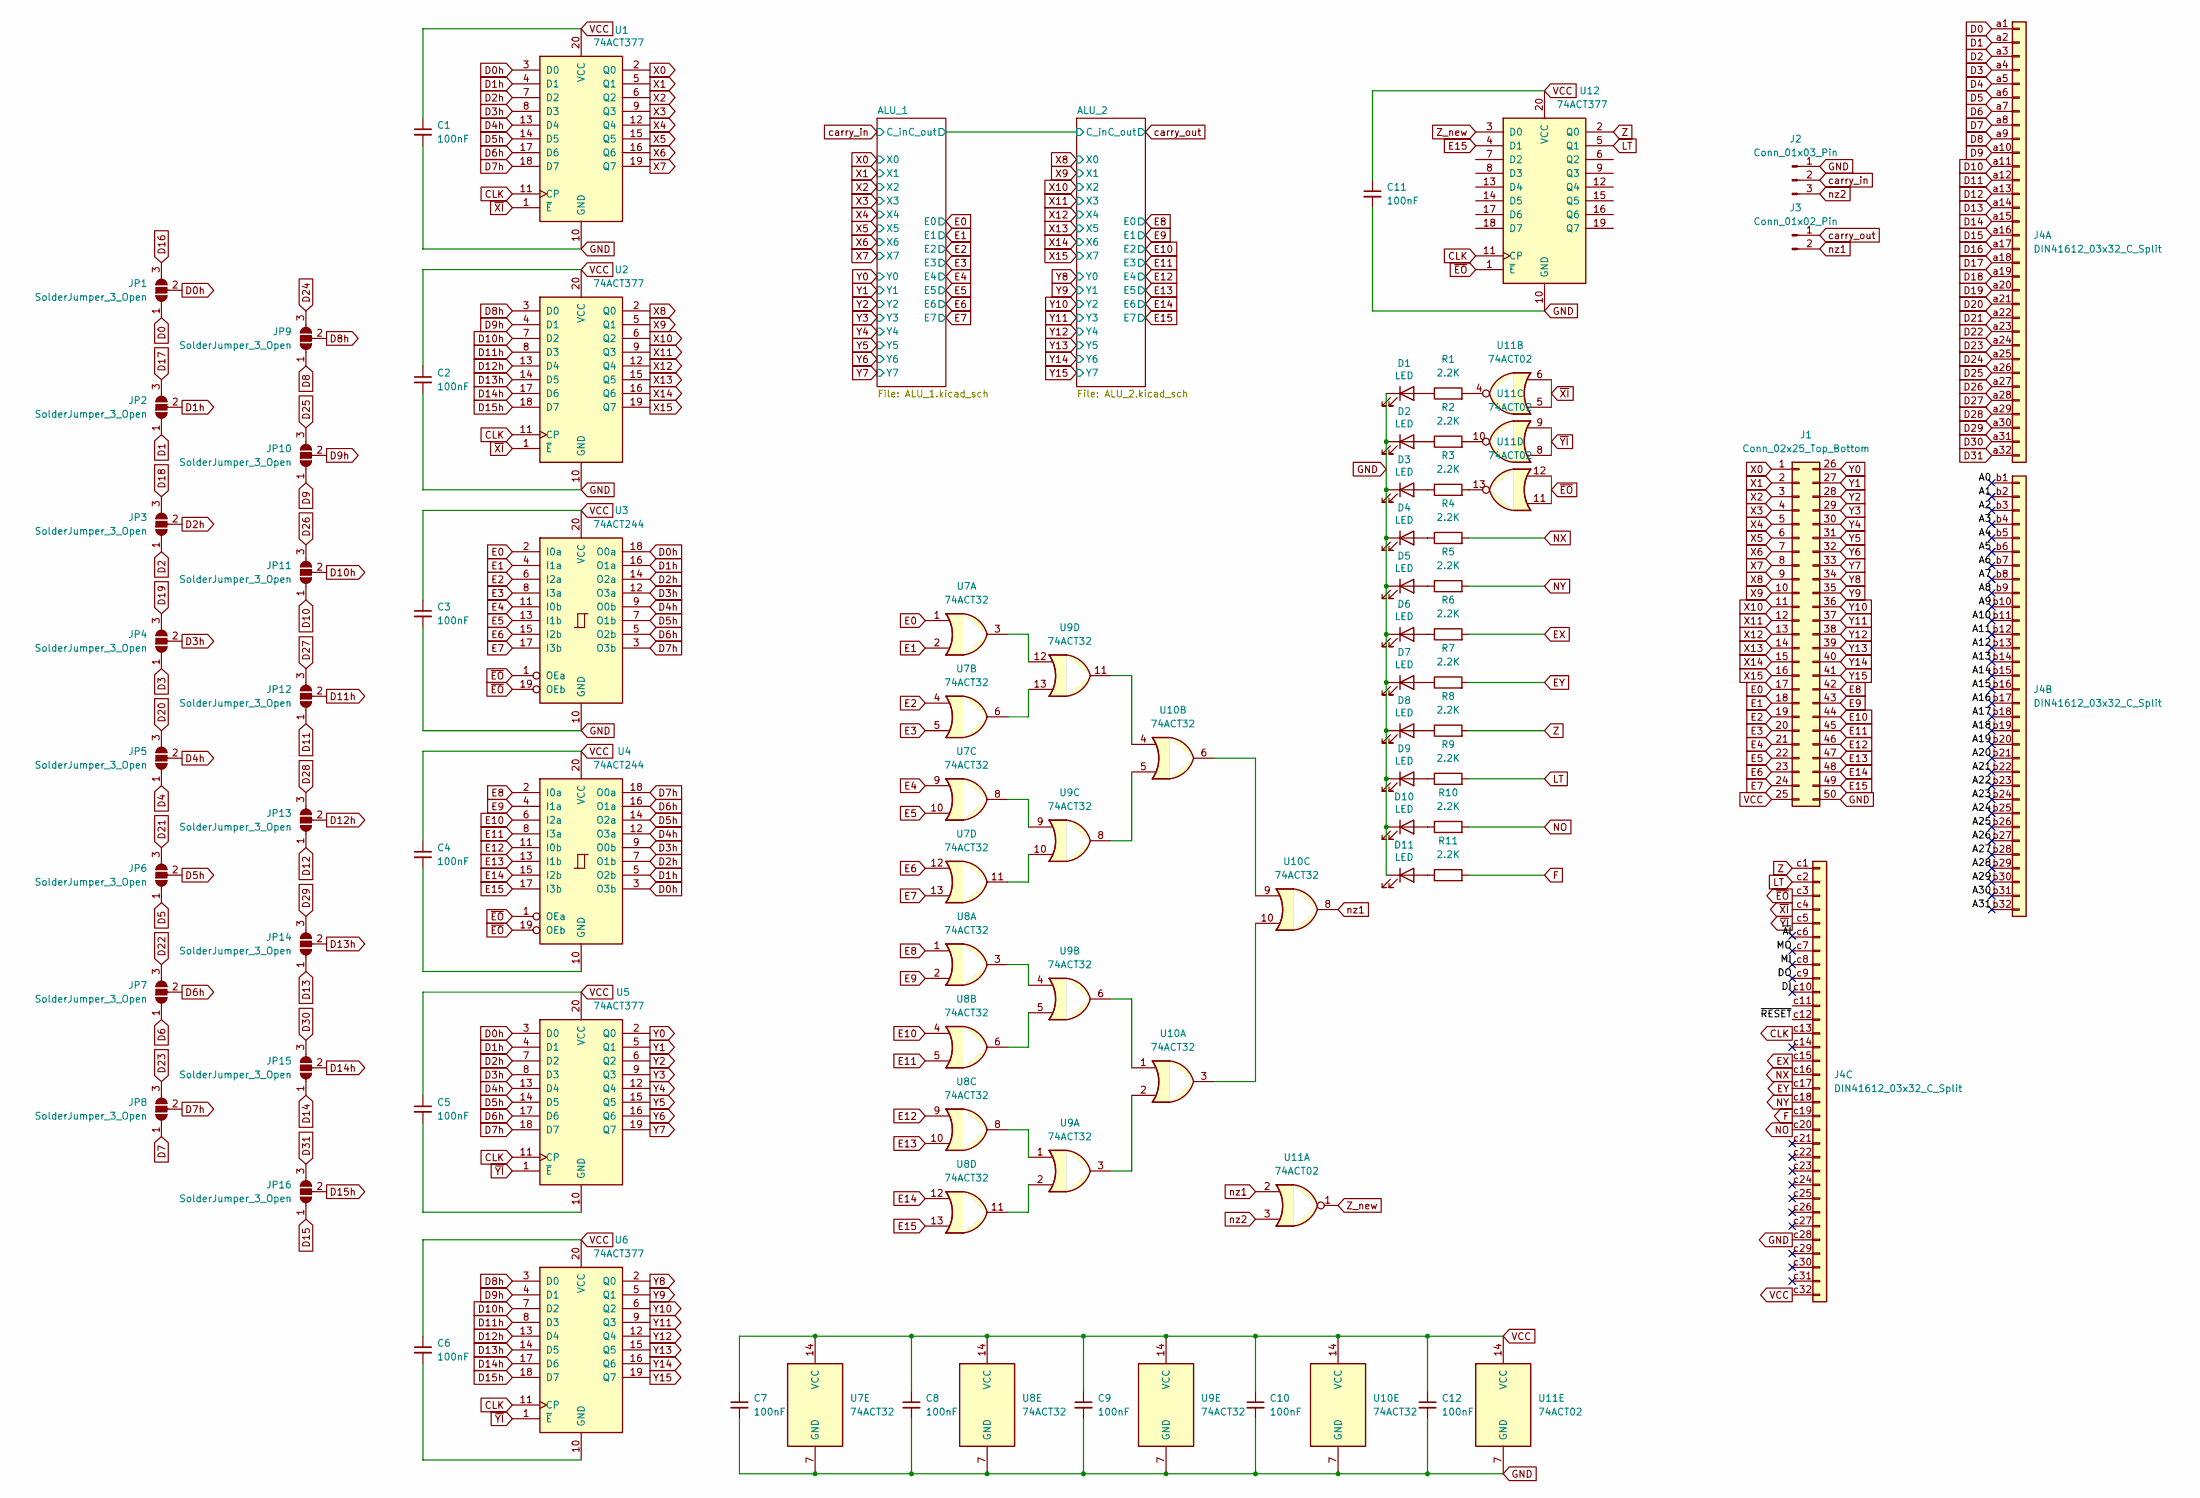
[picture p15: schematic scamp++.kicad_sch]

Parts:
C1, C2, C3, C4, C5, C6, C7, C8, C9, C10, C11, C12: 100nF; C_0805_2012Metric
D1, D2, D3, D4, D5, D6, D7, D8, D9, D10, D11: LED; LED_0603_1608Metric
J1: Conn_02x25_Top_Bottom; PinHeader_2x25_P2.54mm_Horizontal
J2: Conn_01x03_Pin; PinHeader_1x03_P2.54mm_Vertical
J3: Conn_01x02_Pin; PinSocket_1x02_P2.54mm_Vertical
J4: DIN41612_03x32_C_Split; DIN41612_C_3x32_Male_Horizontal_THT
JP1, JP2, JP3, JP4, JP5, JP6, JP7, JP8, JP9, JP10, JP11, JP12, JP13, JP14, JP15, JP16: SolderJumper_3_Open; SolderJumper-3_P1.3mm_Open_RoundedPad1.0x1.5mm_NumberLabels
R1, R2, R3, R4, R5, R6, R7, R8, R9, R10, R11: 2.2K; R_0603_1608Metric
U1, U2, U5, U6, U12: 74ACT377; SOIC-20W_7.5x12.8mm_P1.27mm
U3, U4: 74ACT244; SOIC-20W_7.5x12.8mm_P1.27mm
U7, U8, U9, U10: 74ACT32; SOIC-14_3.9x8.7mm_P1.27mm
U11: 74ACT02; SOIC-14_3.9x8.7mm_P1.27mm

Connections:
/A0: J4.b1
/A1: J4.b2
/A2: J4.b3
/A3: J4.b4
/A4: J4.b5
/A5: J4.b6
/A6: J4.b7
/A7: J4.b8
/A8: J4.b9
/A9: J4.b10
/A10: J4.b11
/A11: J4.b12
/A12: J4.b13
/A13: J4.b14
/A14: J4.b15
/A15: J4.b16
/A16: J4.b17
/A17: J4.b18
/A18: J4.b19
/A19: J4.b20
/A20: J4.b21
/A21: J4.b22
/A22: J4.b23
/A23: J4.b24
/A24: J4.b25
/A25: J4.b26
/A26: J4.b27
/A27: J4.b28
/A28: J4.b29
/A29: J4.b30
/A30: J4.b31
/A31: J4.b32
/DI: J4.c10
/DO: J4.c9
/MI: J4.c8
/MO: J4.c7
/~AI: J4.c6
/~RESET: J4.c12
CLK: J4.c13, U1.11 (CP), U2.11 (CP), U5.11 (CP), U6.11 (CP), U12.11 (CP)
D0: J4.a1, JP1.1 (A)
D0h: JP1.2 (C), U1.3 (D0), U3.18 (O0a), U4.3 (O3b), U5.3 (D0)
D1: J4.a2, JP2.1 (A)
D1h: JP2.2 (C), U1.4 (D1), U3.16 (O1a), U4.5 (O2b), U5.4 (D1)
D2: J4.a3, JP3.1 (A)
D2h: JP3.2 (C), U1.7 (D2), U3.14 (O2a), U4.7 (O1b), U5.7 (D2)
D3: J4.a4, JP4.1 (A)
D3h: JP4.2 (C), U1.8 (D3), U3.12 (O3a), U4.9 (O0b), U5.8 (D3)
D4: J4.a5, JP5.1 (A)
D4h: JP5.2 (C), U1.13 (D4), U3.9 (O0b), U4.12 (O3a), U5.13 (D4)
D5: J4.a6, JP6.1 (A)
D5h: JP6.2 (C), U1.14 (D5), U3.7 (O1b), U4.14 (O2a), U5.14 (D5)
D6: J4.a7, JP7.1 (A)
D6h: JP7.2 (C), U1.17 (D6), U3.5 (O2b), U4.16 (O1a), U5.17 (D6)
D7: J4.a8, JP8.1 (A)
D7h: JP8.2 (C), U1.18 (D7), U3.3 (O3b), U4.18 (O0a), U5.18 (D7)
D8: J4.a9, JP9.1 (A)
D8h: JP9.2 (C), U2.3 (D0), U6.3 (D0)
D9: J4.a10, JP10.1 (A)
D9h: JP10.2 (C), U2.4 (D1), U6.4 (D1)
D10: J4.a11, JP11.1 (A)
D10h: JP11.2 (C), U2.7 (D2), U6.7 (D2)
D11: J4.a12, JP12.1 (A)
D11h: JP12.2 (C), U2.8 (D3), U6.8 (D3)
D12: J4.a13, JP13.1 (A)
D12h: JP13.2 (C), U2.13 (D4), U6.13 (D4)
D13: J4.a14, JP14.1 (A)
D13h: JP14.2 (C), U2.14 (D5), U6.14 (D5)
D14: J4.a15, JP15.1 (A)
D14h: JP15.2 (C), U2.17 (D6), U6.17 (D6)
D15: J4.a16, JP16.1 (A)
D15h: JP16.2 (C), U2.18 (D7), U6.18 (D7)
D16: J4.a17, JP1.3 (B)
D17: J4.a18, JP2.3 (B)
D18: J4.a19, JP3.3 (B)
D19: J4.a20, JP4.3 (B)
D20: J4.a21, JP5.3 (B)
D21: J4.a22, JP6.3 (B)
D22: J4.a23, JP7.3 (B)
D23: J4.a24, JP8.3 (B)
D24: J4.a25, JP9.3 (B)
D25: J4.a26, JP10.3 (B)
D26: J4.a27, JP11.3 (B)
D27: J4.a28, JP12.3 (B)
D28: J4.a29, JP13.3 (B)
D29: J4.a30, JP14.3 (B)
D30: J4.a31, JP15.3 (B)
D31: J4.a32, JP16.3 (B)
E0: J1.17, U3.2 (I0a), U7.1; also elsewhere on the board
E1: J1.18, U3.4 (I1a), U7.2; also elsewhere on the board
E2: J1.19, U3.6 (I2a), U7.4; also elsewhere on the board
E3: J1.20, U3.8 (I3a), U7.5; also elsewhere on the board
E4: J1.21, U3.11 (I0b), U7.9; also elsewhere on the board
E5: J1.22, U3.13 (I1b), U7.10; also elsewhere on the board
E6: J1.23, U3.15 (I2b), U7.12; also elsewhere on the board
E7: J1.24, U3.17 (I3b), U7.13; also elsewhere on the board
E8: J1.42, U4.2 (I0a), U8.1; also elsewhere on the board
E9: J1.43, U4.4 (I1a), U8.2; also elsewhere on the board
E10: J1.44, U4.6 (I2a), U8.4; also elsewhere on the board
E11: J1.45, U4.8 (I3a), U8.5; also elsewhere on the board
E12: J1.46, U4.11 (I0b), U8.9; also elsewhere on the board
E13: J1.47, U4.13 (I1b), U8.10; also elsewhere on the board
E14: J1.48, U4.15 (I2b), U8.12; also elsewhere on the board
E15: J1.49, U4.17 (I3b), U8.13, U12.4 (D1); also elsewhere on the board
GND: C1.2, C2.2, C3.2, C7.2, C8.2, C9.2, C10.2, C11.2, C12.2, D1.1 (K), D2.1 (K), D3.1 (K), D4.1 (K), D5.1 (K), D6.1 (K), D7.1 (K), D8.1 (K), D9.1 (K), D10.1 (K), D11.1 (K), J1.50, J2.1, J4.c28, U1.10 (GND), U2.10 (GND), U3.10 (GND), U7.7 (GND), U8.7 (GND), U9.7 (GND), U10.7 (GND), U11.7 (GND), U12.10 (GND); also elsewhere on the board
unnamed: D1.2 (A), R1.1
unnamed 106: D2.2 (A), R2.1; also elsewhere on the board
unnamed 107: D3.2 (A), R3.1; also elsewhere on the board
unnamed: D4.2 (A), R4.1
unnamed 109: D5.2 (A), R5.1; also elsewhere on the board
unnamed 110: D6.2 (A), R6.1; also elsewhere on the board
unnamed 111: D7.2 (A), R7.1; also elsewhere on the board
unnamed 112: D8.2 (A), R8.1; also elsewhere on the board
unnamed: D9.2 (A), R9.1
unnamed: D10.2 (A), R10.1
unnamed: D11.2 (A), R11.1
unnamed: C4.2, U4.10 (GND)
unnamed: C5.2, U5.10 (GND)
unnamed: C6.2, U6.10 (GND)
unnamed: U7.3, U9.12
unnamed: U7.6, U9.13
unnamed: U7.8, U9.9
unnamed: U7.11, U9.10
unnamed: U8.3, U9.4
unnamed: U8.6, U9.5
unnamed: U8.8, U9.1
unnamed: U8.11, U9.2
unnamed: U9.6, U10.1
unnamed: U9.3, U10.2
unnamed: U9.11, U10.4
unnamed: U9.8, U10.5
unnamed: U10.6, U10.9
unnamed: U10.3, U10.10
X0: J1.1, U1.2 (Q0); also elsewhere on the board
X1: J1.2, U1.5 (Q1); also elsewhere on the board
X2: J1.3, U1.6 (Q2); also elsewhere on the board
X3: J1.4, U1.9 (Q3); also elsewhere on the board
X4: J1.5, U1.12 (Q4); also elsewhere on the board
X5: J1.6, U1.15 (Q5); also elsewhere on the board
X6: J1.7, U1.16 (Q6); also elsewhere on the board
X7: J1.8, U1.19 (Q7); also elsewhere on the board
X8: J1.9, U2.2 (Q0); also elsewhere on the board
X9: J1.10, U2.5 (Q1); also elsewhere on the board
X10: J1.11, U2.6 (Q2); also elsewhere on the board
X11: J1.12, U2.9 (Q3); also elsewhere on the board
X12: J1.13, U2.12 (Q4); also elsewhere on the board
X13: J1.14, U2.15 (Q5); also elsewhere on the board
X14: J1.15, U2.16 (Q6); also elsewhere on the board
X15: J1.16, U2.19 (Q7); also elsewhere on the board
Y0: J1.26, U5.2 (Q0); also elsewhere on the board
Y1: J1.27, U5.5 (Q1); also elsewhere on the board
Y2: J1.28, U5.6 (Q2); also elsewhere on the board
Y3: J1.29, U5.9 (Q3); also elsewhere on the board
Y4: J1.30, U5.12 (Q4); also elsewhere on the board
Y5: J1.31, U5.15 (Q5); also elsewhere on the board
Y6: J1.32, U5.16 (Q6); also elsewhere on the board
Y7: J1.33, U5.19 (Q7); also elsewhere on the board
Y8: J1.34, U6.2 (Q0); also elsewhere on the board
Y9: J1.35, U6.5 (Q1); also elsewhere on the board
Y10: J1.36, U6.6 (Q2); also elsewhere on the board
Y11: J1.37, U6.9 (Q3); also elsewhere on the board
Y12: J1.38, U6.12 (Q4); also elsewhere on the board
Y13: J1.39, U6.15 (Q5); also elsewhere on the board
Y14: J1.40, U6.16 (Q6); also elsewhere on the board
Y15: J1.41, U6.19 (Q7); also elsewhere on the board
Z_new: U11.1, U12.3 (D0)
carry_in: J2.2; also elsewhere on the board
carry_out: J3.1; also elsewhere on the board
nz1: J3.2, U10.8, U11.2
nz2: J2.3, U11.3
~EO: J4.c3, U3.1 (OEa), U3.19 (OEb), U4.1 (OEa), U4.19 (OEb), U11.11, U11.12, U12.1 (~E)
~XI: J4.c4, U1.1 (~E), U2.1 (~E), U11.5, U11.6
~YI: J4.c5, U5.1 (~E), U6.1 (~E), U11.8, U11.9
