BenskiBoy/scamp-32/kicad/scamp-plus/_restore_backup_2026-09-13T19-42-04-211/scamp++.kicad_pcb

## KiCad design kicad/scamp-plus/_restore_backup_2026-09-13T19-42-04-211/scamp++.kicad_pcb (continued)

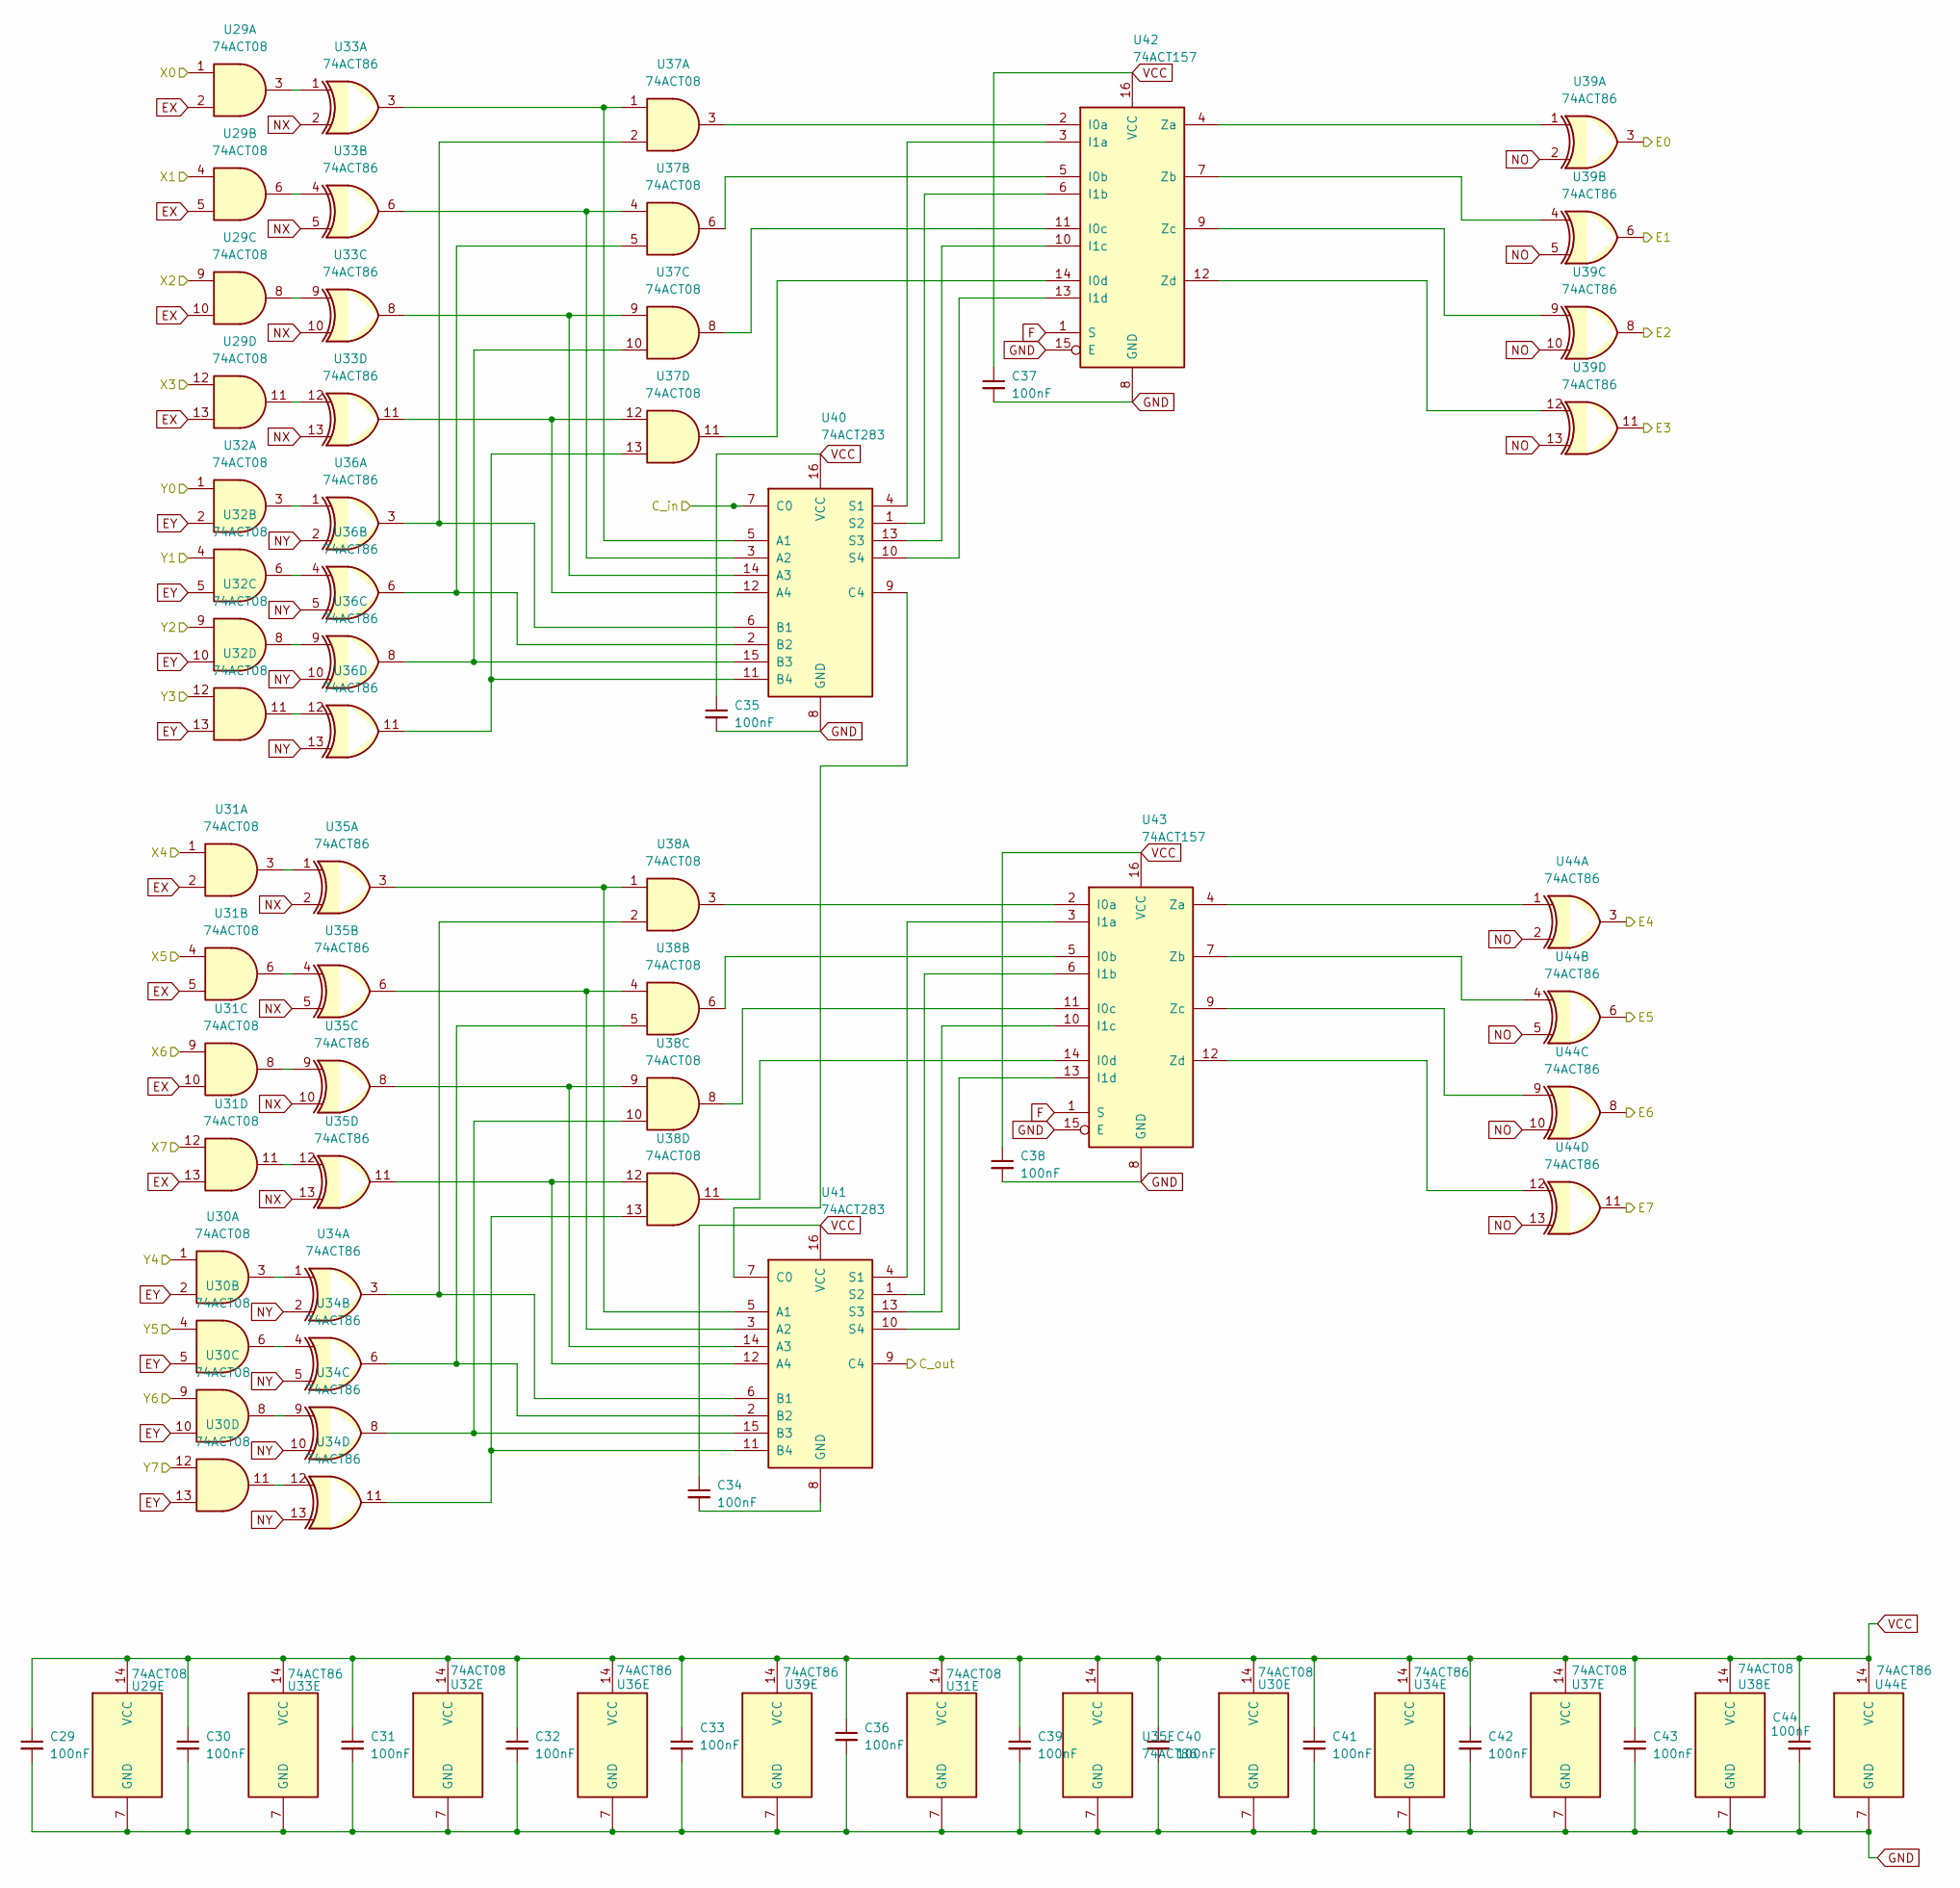
[picture p16: schematic ALU_2.kicad_sch]

Parts:
C29, C30, C31, C32, C33, C34, C35, C36, C37, C38, C39, C40, C41, C42, C43, C44: 100nF; C_0805_2012Metric
U29, U30, U31, U32, U37, U38: 74ACT08; SOIC-14_3.9x8.7mm_P1.27mm
U33, U34, U35, U36, U39, U44: 74ACT86; SOIC-14_3.9x8.7mm_P1.27mm
U40, U41: 74ACT283; SOIC-16_3.9x9.9mm_P1.27mm
U42, U43: 74ACT157; SOIC-16_3.9x9.9mm_P1.27mm

Connections:
/ALU_1/C_out: U40.7 (C0); also elsewhere on the board
E8: U39.3; also elsewhere on the board
E9: U39.6; also elsewhere on the board
E10: U39.8; also elsewhere on the board
E11: U39.11; also elsewhere on the board
E12: U44.3; also elsewhere on the board
E13: U44.6; also elsewhere on the board
E14: U44.8; also elsewhere on the board
E15: U44.11; also elsewhere on the board
GND: C29.2, C30.2, C31.2, C32.2, C33.2, C35.2, C36.2, C37.2, C38.2, C39.2, C40.2, C41.2, C42.2, C43.2, C44.2, U29.7 (GND), U30.7 (GND), U31.7 (GND), U32.7 (GND), U33.7 (GND), U34.7 (GND), U35.7 (GND), U36.7 (GND), U37.7 (GND), U38.7 (GND), U39.7 (GND), U40.8 (GND), U42.8 (GND), U42.15 (E), U43.8 (GND), U43.15 (E), U44.7 (GND); also elsewhere on the board
unnamed: U29.3, U33.1
unnamed: U29.6, U33.4
unnamed: U29.8, U33.9
unnamed: U29.11, U33.12
unnamed: U30.3, U34.1
unnamed: U30.6, U34.4
unnamed: U30.8, U34.9
unnamed: U30.11, U34.12
unnamed: U31.3, U35.1
unnamed: U31.6, U35.4
unnamed: U31.8, U35.9
unnamed: U31.11, U35.12
unnamed: U32.3, U36.1
unnamed: U32.6, U36.4
unnamed: U32.8, U36.9
unnamed: U32.11, U36.12
unnamed: U33.3, U37.1, U40.5 (A1)
unnamed: U33.6, U37.4, U40.3 (A2)
unnamed: U33.8, U37.9, U40.14 (A3)
unnamed: U33.11, U37.12, U40.12 (A4)
unnamed: U36.3, U37.2, U40.6 (B1)
unnamed: U36.6, U37.5, U40.2 (B2)
unnamed: U36.8, U37.10, U40.15 (B3)
unnamed: U36.11, U37.13, U40.11 (B4)
unnamed: U40.9 (C4), U41.7 (C0)
unnamed: U40.4 (S1), U42.3 (I1a)
unnamed: U40.1 (S2), U42.6 (I1b)
unnamed: U40.13 (S3), U42.10 (I1c)
unnamed: U40.10 (S4), U42.13 (I1d)
unnamed: U35.3, U38.1, U41.5 (A1)
unnamed: U35.6, U38.4, U41.3 (A2)
unnamed: U35.8, U38.9, U41.14 (A3)
unnamed: U35.11, U38.12, U41.12 (A4)
unnamed: U34.3, U38.2, U41.6 (B1)
unnamed: U34.6, U38.5, U41.2 (B2)
unnamed: U34.8, U38.10, U41.15 (B3)
unnamed: U34.11, U38.13, U41.11 (B4)
unnamed: C34.2, U41.8 (GND)
unnamed: U41.4 (S1), U43.3 (I1a)
unnamed: U41.1 (S2), U43.6 (I1b)
unnamed: U41.13 (S3), U43.10 (I1c)
unnamed: U41.10 (S4), U43.13 (I1d)
unnamed: U37.3, U42.2 (I0a)
unnamed: U37.6, U42.5 (I0b)
unnamed: U37.8, U42.11 (I0c)
unnamed: U37.11, U42.14 (I0d)
unnamed: U39.1, U42.4 (Za)
unnamed: U39.4, U42.7 (Zb)
unnamed: U39.9, U42.9 (Zc)
unnamed: U39.12, U42.12 (Zd)
unnamed: U38.3, U43.2 (I0a)
unnamed: U38.6, U43.5 (I0b)
unnamed: U38.8, U43.11 (I0c)
unnamed: U38.11, U43.14 (I0d)
unnamed: U43.4 (Za), U44.1
unnamed: U43.7 (Zb), U44.4
unnamed: U43.9 (Zc), U44.9
unnamed: U43.12 (Zd), U44.12
X8: U29.1; also elsewhere on the board
X9: U29.4; also elsewhere on the board
X10: U29.9; also elsewhere on the board
X11: U29.12; also elsewhere on the board
X12: U31.1; also elsewhere on the board
X13: U31.4; also elsewhere on the board
X14: U31.9; also elsewhere on the board
X15: U31.12; also elsewhere on the board
Y8: U32.1; also elsewhere on the board
Y9: U32.4; also elsewhere on the board
Y10: U32.9; also elsewhere on the board
Y11: U32.12; also elsewhere on the board
Y12: U30.1; also elsewhere on the board
Y13: U30.4; also elsewhere on the board
Y14: U30.9; also elsewhere on the board
Y15: U30.12; also elsewhere on the board
carry_out: U41.9 (C4); also elsewhere on the board

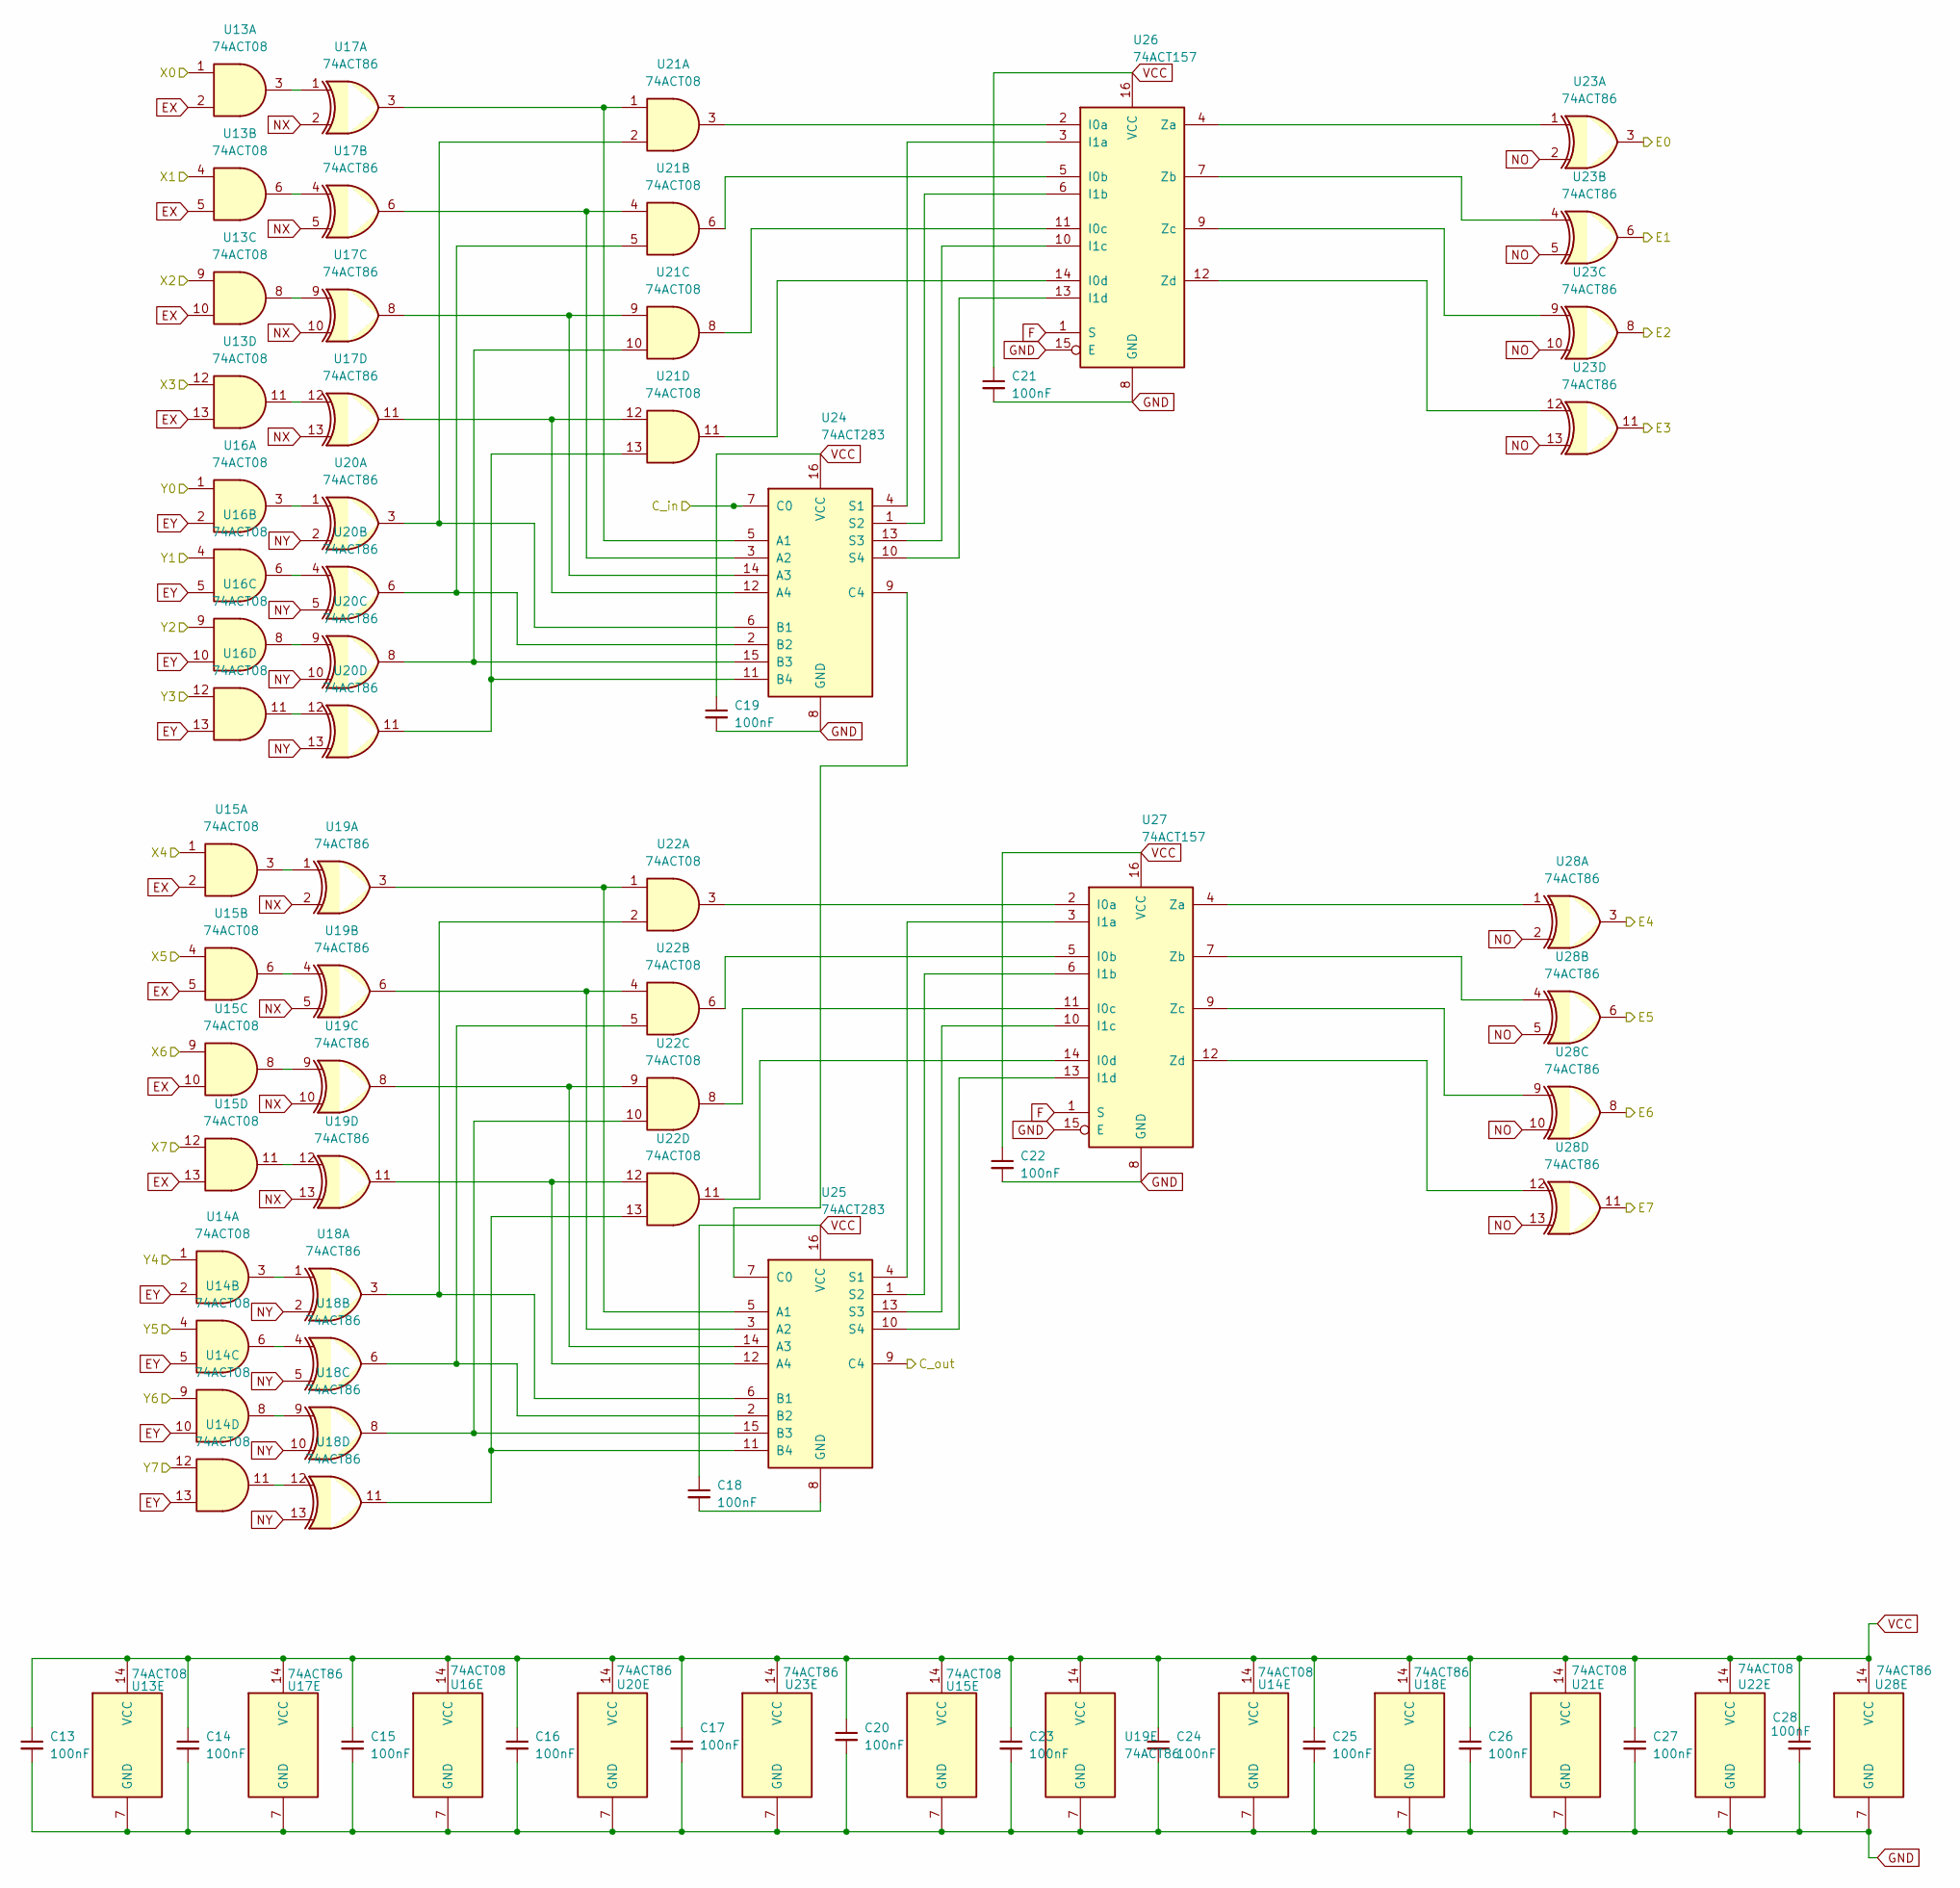
[picture p17: schematic ALU_1.kicad_sch]

Parts:
C13, C14, C15, C16, C17, C18, C19, C20, C21, C22, C23, C24, C25, C26, C27, C28: 100nF; C_0805_2012Metric
U13, U14, U15, U16, U21, U22: 74ACT08; SOIC-14_3.9x8.7mm_P1.27mm
U17, U18, U19, U20, U23, U28: 74ACT86; SOIC-14_3.9x8.7mm_P1.27mm
U24, U25: 74ACT283; SOIC-16_3.9x9.9mm_P1.27mm
U26, U27: 74ACT157; SOIC-16_3.9x9.9mm_P1.27mm

Connections:
/ALU_1/C_out: U25.9 (C4); also elsewhere on the board
E0: U23.3; also elsewhere on the board
E1: U23.6; also elsewhere on the board
E2: U23.8; also elsewhere on the board
E3: U23.11; also elsewhere on the board
E4: U28.3; also elsewhere on the board
E5: U28.6; also elsewhere on the board
E6: U28.8; also elsewhere on the board
E7: U28.11; also elsewhere on the board
GND: C13.2, C14.2, C15.2, C16.2, C17.2, C19.2, C20.2, C21.2, C22.2, C23.2, C24.2, C25.2, C26.2, C27.2, C28.2, U13.7 (GND), U14.7 (GND), U15.7 (GND), U16.7 (GND), U17.7 (GND), U18.7 (GND), U19.7 (GND), U20.7 (GND), U21.7 (GND), U22.7 (GND), U23.7 (GND), U24.8 (GND), U26.8 (GND), U26.15 (E), U27.8 (GND), U27.15 (E), U28.7 (GND); also elsewhere on the board
unnamed: U13.3, U17.1
unnamed: U13.6, U17.4
unnamed: U13.8, U17.9
unnamed: U13.11, U17.12
unnamed: U14.3, U18.1
unnamed: U14.6, U18.4
unnamed: U14.8, U18.9
unnamed: U14.11, U18.12
unnamed: U15.3, U19.1
unnamed: U15.6, U19.4
unnamed: U15.8, U19.9
unnamed: U15.11, U19.12
unnamed: U16.3, U20.1
unnamed: U16.6, U20.4
unnamed: U16.8, U20.9
unnamed: U16.11, U20.12
unnamed: U17.3, U21.1, U24.5 (A1)
unnamed: U17.6, U21.4, U24.3 (A2)
unnamed: U17.8, U21.9, U24.14 (A3)
unnamed: U17.11, U21.12, U24.12 (A4)
unnamed: U20.3, U21.2, U24.6 (B1)
unnamed: U20.6, U21.5, U24.2 (B2)
unnamed: U20.8, U21.10, U24.15 (B3)
unnamed: U20.11, U21.13, U24.11 (B4)
unnamed: U24.9 (C4), U25.7 (C0)
unnamed: U24.4 (S1), U26.3 (I1a)
unnamed: U24.1 (S2), U26.6 (I1b)
unnamed: U24.13 (S3), U26.10 (I1c)
unnamed: U24.10 (S4), U26.13 (I1d)
unnamed: U19.3, U22.1, U25.5 (A1)
unnamed: U19.6, U22.4, U25.3 (A2)
unnamed: U19.8, U22.9, U25.14 (A3)
unnamed: U19.11, U22.12, U25.12 (A4)
unnamed: U18.3, U22.2, U25.6 (B1)
unnamed: U18.6, U22.5, U25.2 (B2)
unnamed: U18.8, U22.10, U25.15 (B3)
unnamed: U18.11, U22.13, U25.11 (B4)
unnamed: C18.2, U25.8 (GND)
unnamed: U25.4 (S1), U27.3 (I1a)
unnamed: U25.1 (S2), U27.6 (I1b)
unnamed: U25.13 (S3), U27.10 (I1c)
unnamed: U25.10 (S4), U27.13 (I1d)
unnamed: U21.3, U26.2 (I0a)
unnamed: U21.6, U26.5 (I0b)
unnamed: U21.8, U26.11 (I0c)
unnamed: U21.11, U26.14 (I0d)
unnamed: U23.1, U26.4 (Za)
unnamed: U23.4, U26.7 (Zb)
unnamed: U23.9, U26.9 (Zc)
unnamed: U23.12, U26.12 (Zd)
unnamed: U22.3, U27.2 (I0a)
unnamed: U22.6, U27.5 (I0b)
unnamed: U22.8, U27.11 (I0c)
unnamed: U22.11, U27.14 (I0d)
unnamed: U27.4 (Za), U28.1
unnamed: U27.7 (Zb), U28.4
unnamed: U27.9 (Zc), U28.9
unnamed: U27.12 (Zd), U28.12
X0: U13.1; also elsewhere on the board
X1: U13.4; also elsewhere on the board
X2: U13.9; also elsewhere on the board
X3: U13.12; also elsewhere on the board
X4: U15.1; also elsewhere on the board
X5: U15.4; also elsewhere on the board
X6: U15.9; also elsewhere on the board
X7: U15.12; also elsewhere on the board
Y0: U16.1; also elsewhere on the board
Y1: U16.4; also elsewhere on the board
Y2: U16.9; also elsewhere on the board
Y3: U16.12; also elsewhere on the board
Y4: U14.1; also elsewhere on the board
Y5: U14.4; also elsewhere on the board
Y6: U14.9; also elsewhere on the board
Y7: U14.12; also elsewhere on the board
carry_in: U24.7 (C0); also elsewhere on the board

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
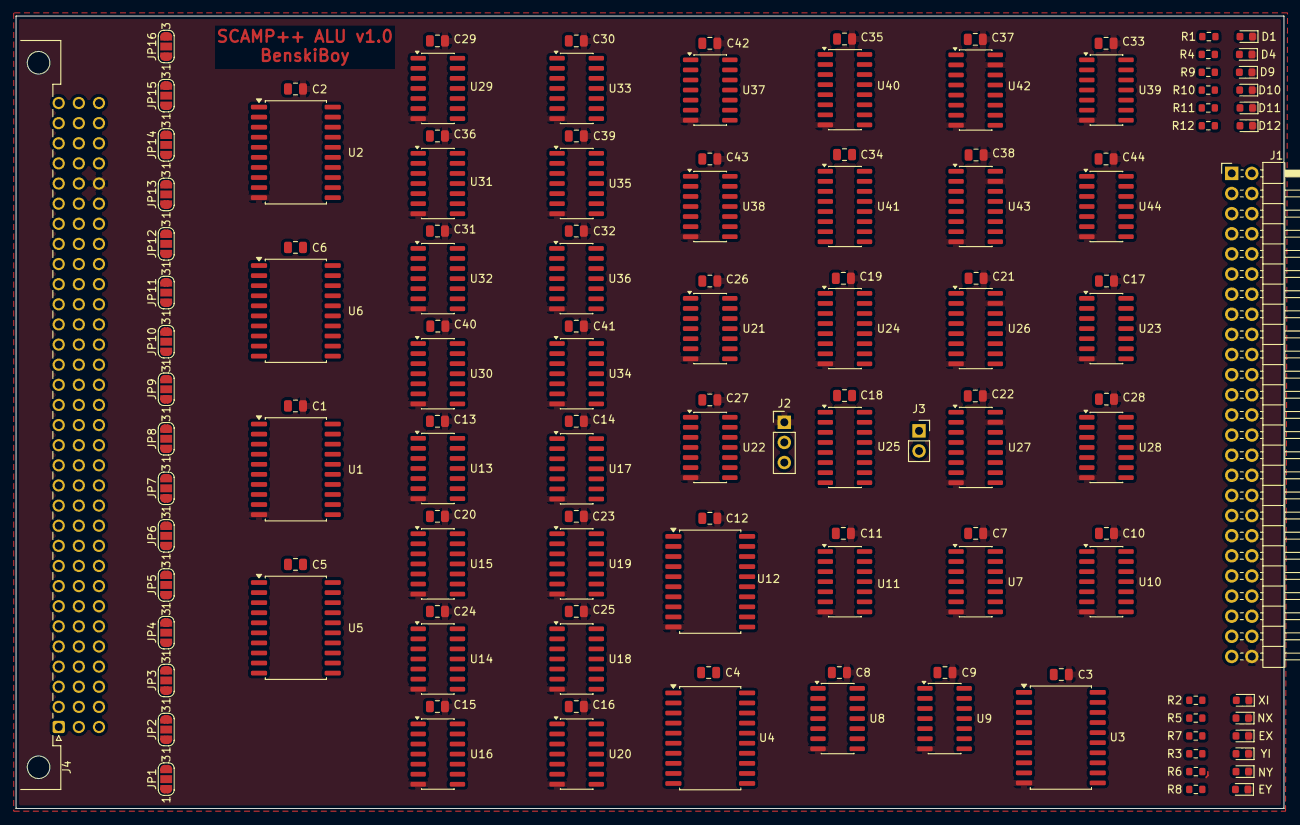
[picture p18: board scamp++.kicad_pcb from above]

Board: 2 copper layers, 160.0 x 100.0 mm, 132 parts (0 on the bottom side), 264 nets.

Other parts of the board:
D12: LED; LED_0603_1608Metric
EX: LED; LED_0603_1608Metric
EY: LED; LED_0603_1608Metric
NX: LED; LED_0603_1608Metric
NY: LED; LED_0603_1608Metric
R12: 2.2K; R_0603_1608Metric
XI: LED; LED_0603_1608Metric
YI: LED; LED_0603_1608Metric

Their connections:
GND: D12.1 (K), EX.1 (K), EY.1 (K), NX.1 (K), NY.1 (K), XI.1 (K), YI.1 (K); also elsewhere on the board
unnamed 106: XI.2 (A); also elsewhere on the board
unnamed 107: YI.2 (A); also elsewhere on the board
unnamed 109: NX.2 (A); also elsewhere on the board
unnamed 110: NY.2 (A); also elsewhere on the board
unnamed 111: EX.2 (A); also elsewhere on the board
unnamed 112: EY.2 (A); also elsewhere on the board
unnamed: D12.2 (A), R12.1
