BenskiBoy/scamp-32/kicad/scamp-plus/scamp_memory/scamp_memory.kicad_pcb

## KiCad design kicad/scamp-plus/scamp_memory/scamp_memory.kicad_pcb (2026-09-10)

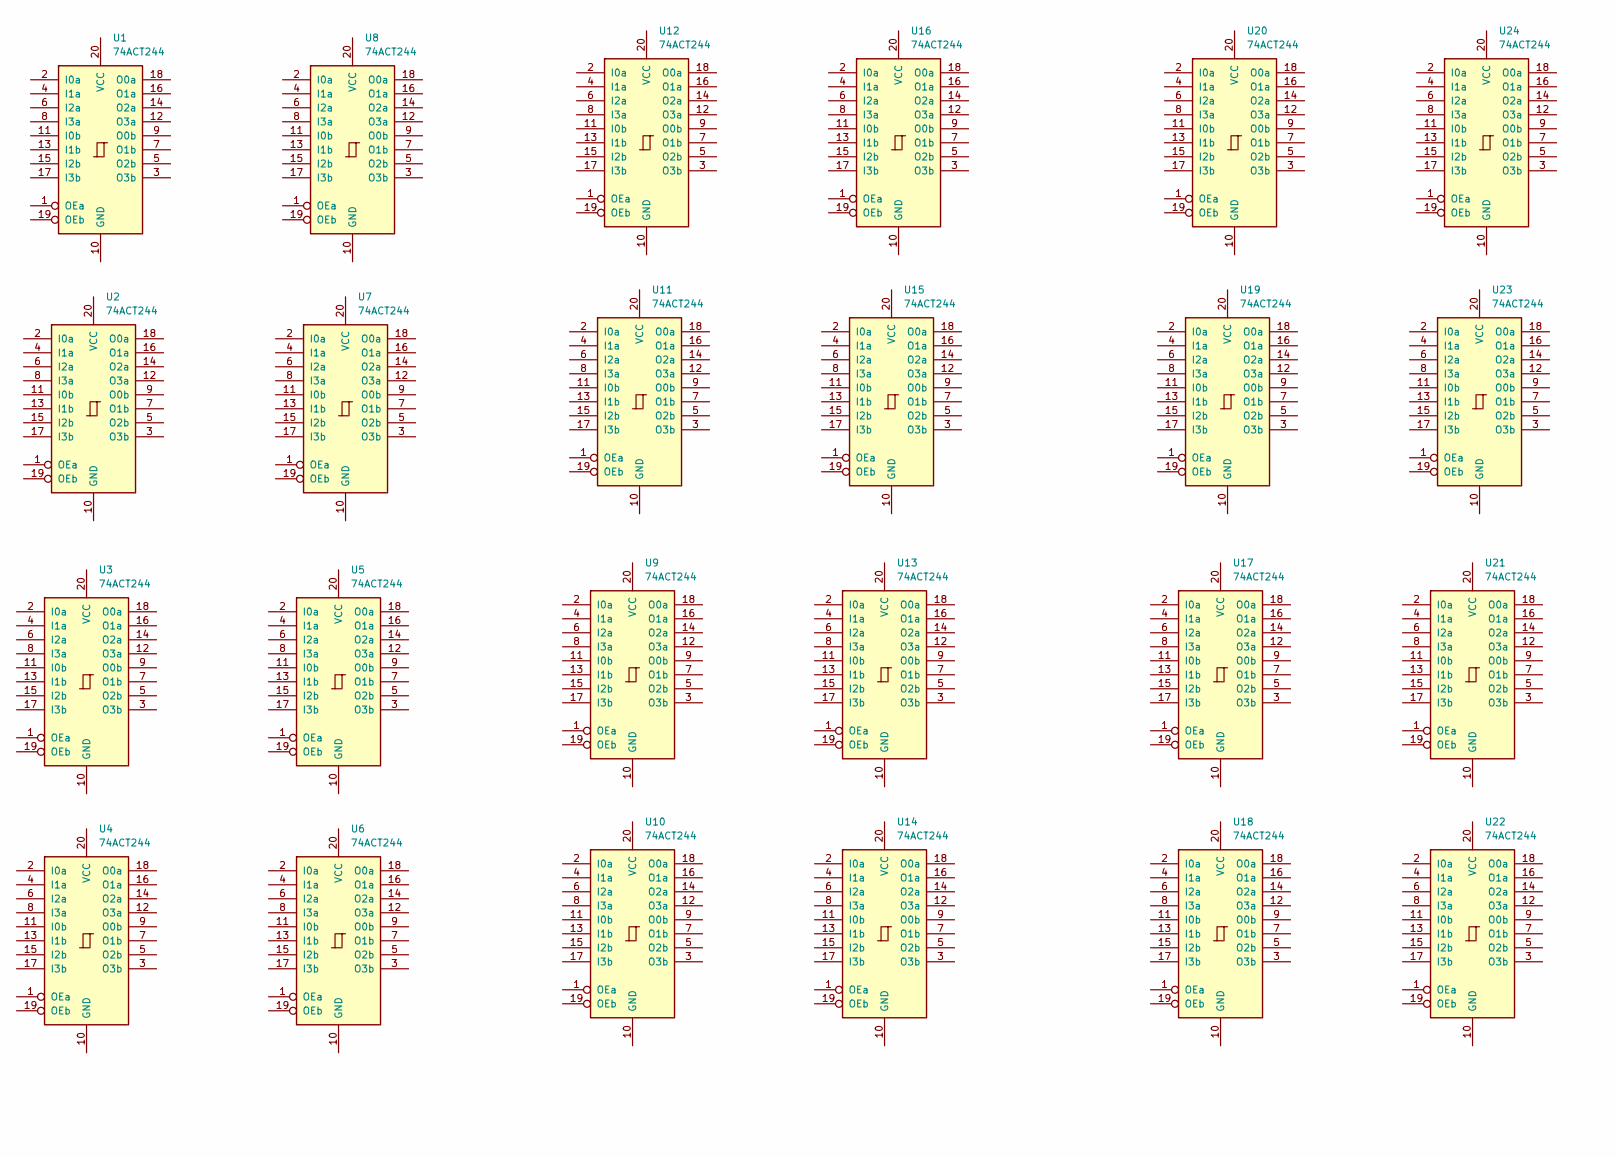
[picture p19: schematic scamp_memory.kicad_sch, part in row 1, column 1]

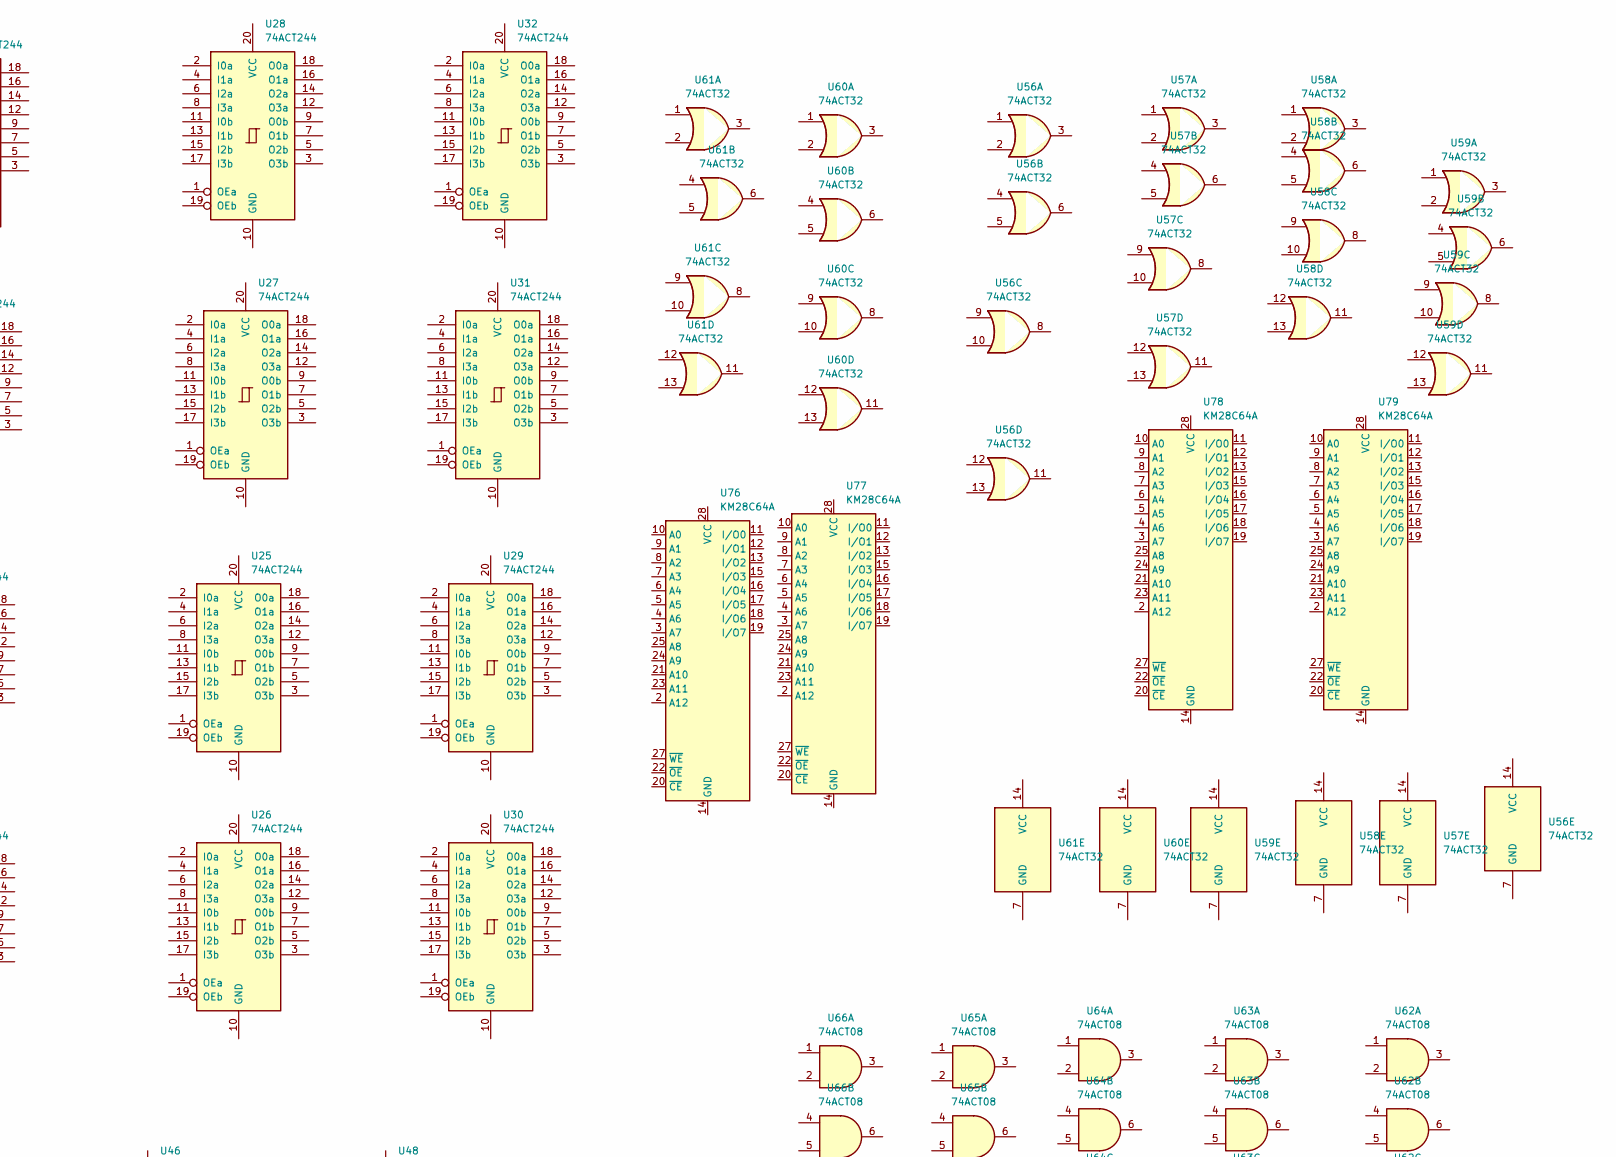
[picture p20: schematic scamp_memory.kicad_sch, part in row 1, column 2]

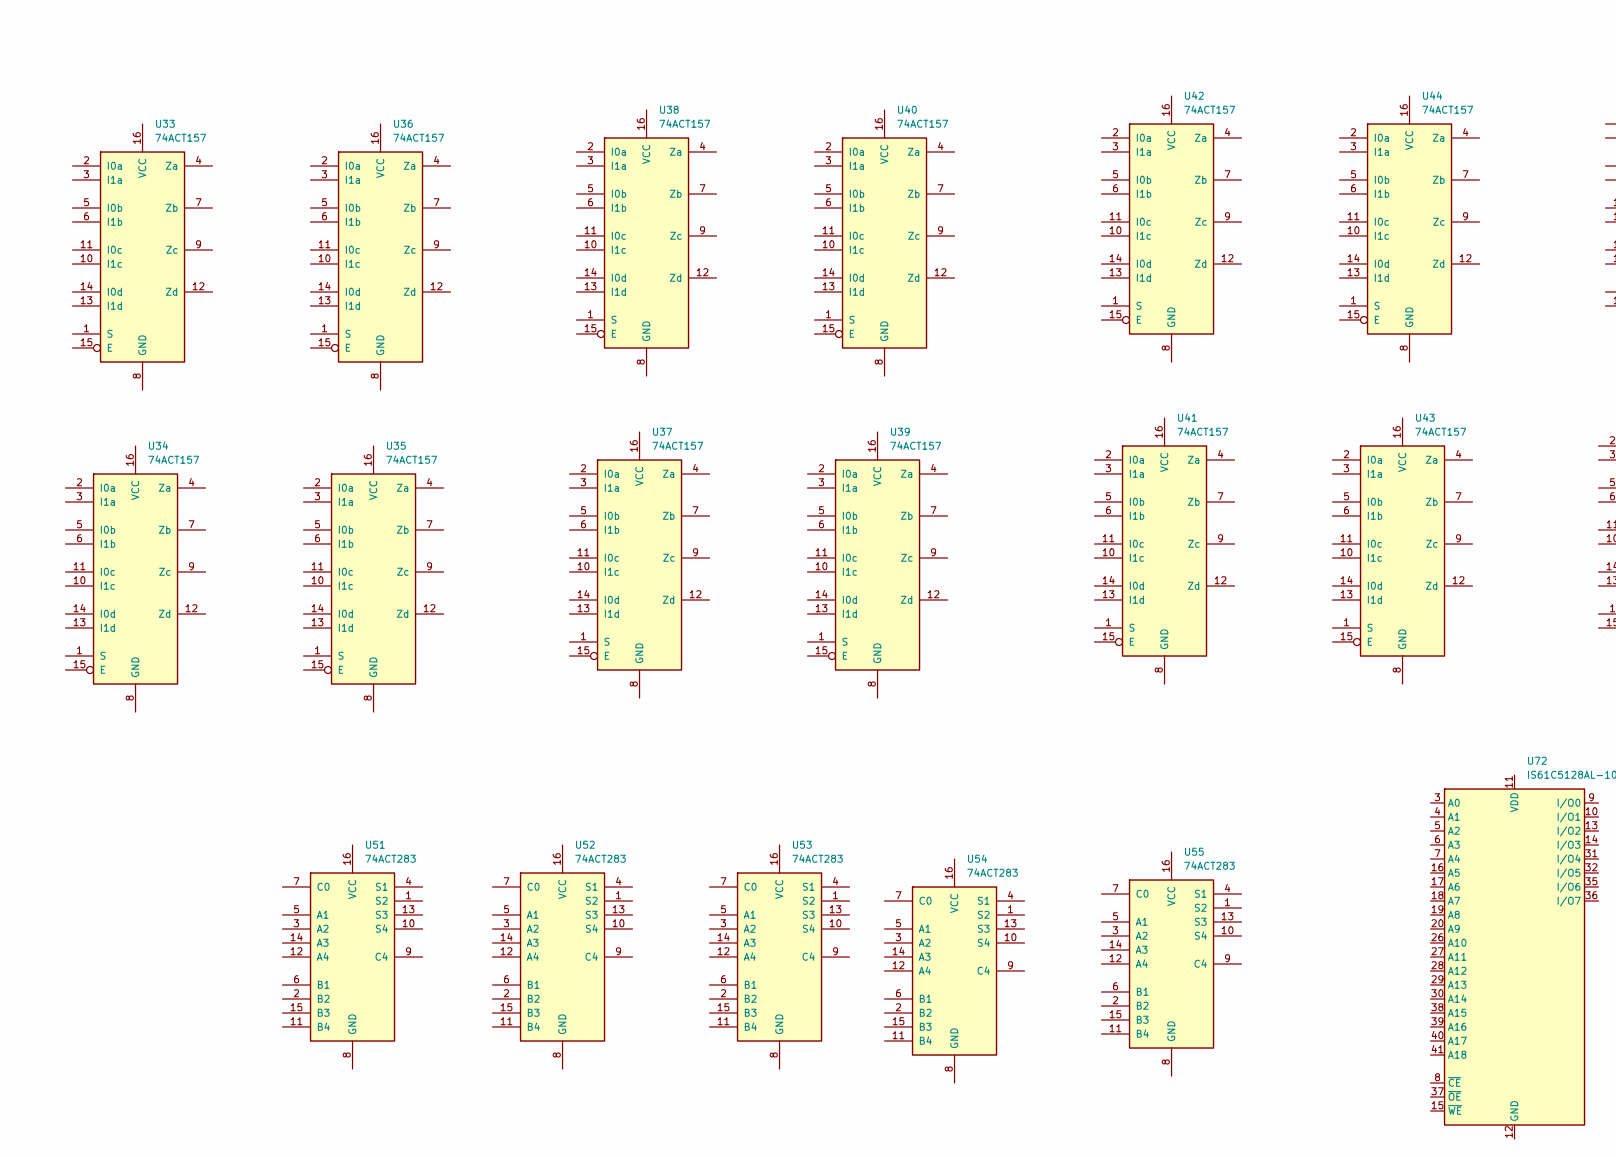
[picture p21: schematic scamp_memory.kicad_sch, part in row 2, column 1]

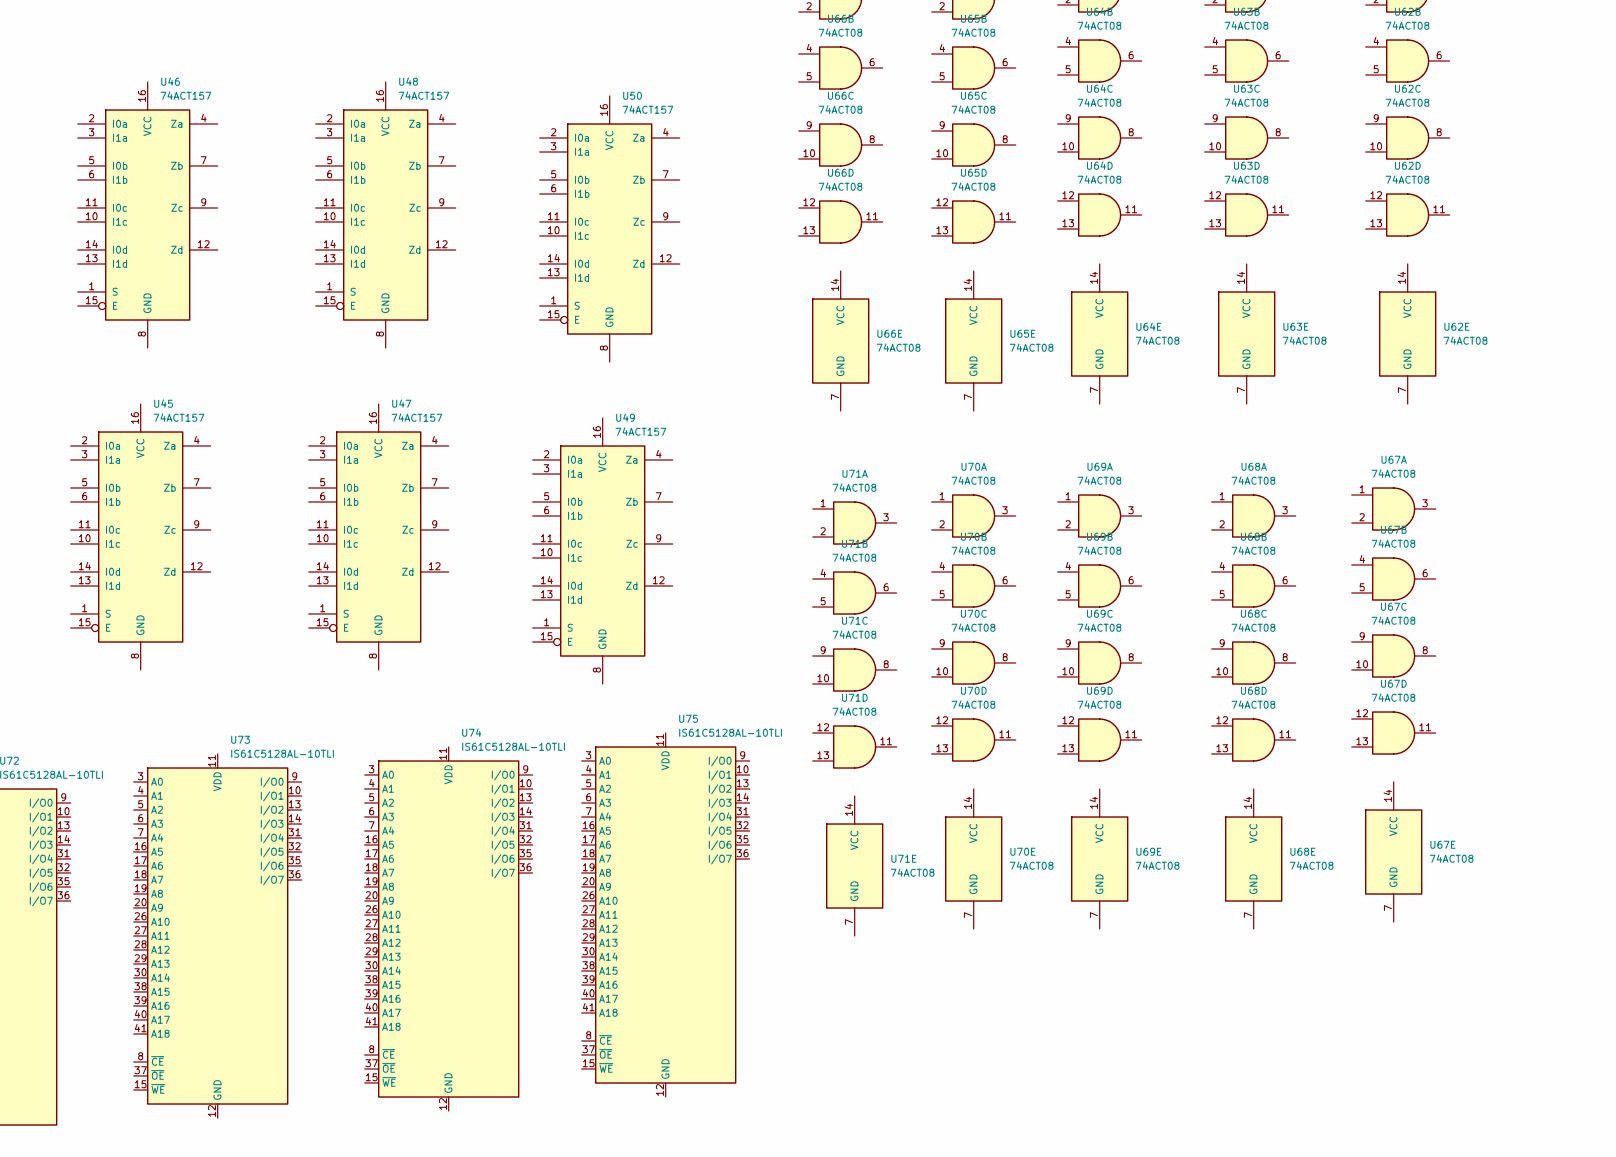
[picture p22: schematic scamp_memory.kicad_sch, part in row 2, column 2]

Parts:
U1, U2, U3, U4, U5, U6, U7, U8, U9, U10, U11, U12, U13, U14, U15, U16, U17, U18, U19, U20, U21, U22, U23, U24, U25, U26, U27, U28, U29, U30, U31, U32: 74ACT244; SOIC-20W_7.5x12.8mm_P1.27mm
U33, U34, U35, U36, U37, U38, U39, U40, U41, U42, U43, U44, U45, U46, U47, U48, U49, U50: 74ACT157; SOIC-16_3.9x9.9mm_P1.27mm
U51, U52, U53, U54, U55: 74ACT283; SOIC-16_3.9x9.9mm_P1.27mm
U56, U57, U58, U59, U60, U61: 74ACT32; SOIC-14_3.9x8.7mm_P1.27mm
U62, U63, U64, U65, U66, U67, U68, U69, U70, U71: 74ACT08; SOIC-14_3.9x8.7mm_P1.27mm
U72, U73, U74, U75: IS61C5128AL-10TLI; TSOP-II-44_10.16x18.41mm_P0.8mm
U76, U77, U78, U79: KM28C64A; DIP-28_W15.24mm

Connections:
unnamed: U72.12 (GND), U72.34 (GND)
unnamed: U72.11 (VDD), U72.33 (VDD)
unnamed: U73.12 (GND), U73.34 (GND)
unnamed: U73.11 (VDD), U73.33 (VDD)
unnamed: U74.12 (GND), U74.34 (GND)
unnamed: U74.11 (VDD), U74.33 (VDD)
unnamed: U75.12 (GND), U75.34 (GND)
unnamed: U75.11 (VDD), U75.33 (VDD)

Board: 2 copper layers, 79 parts (0 on the bottom side), 8 nets, no tracks yet.
