BenskiBoy/scamp-32/(commit log)

2026-09-10 init commit
    [ALU_1.kicad_sch, ALU_2.kicad_sch, ALU_3.kicad_sch, ALU_4.kicad_sch, scamp++.kicad_pcb, scamp++.kicad_sch, scamp++_alu.kicad_sch, scamp_memory.kicad_pcb]
2026-09-13 xor working
    [scampplusplus.circ]
2026-09-13 add jnz. support for reversing byte order due to limited t-cycles
    [ALU_1.kicad_sch, ALU_2.kicad_sch, ALU_3.kicad_sch, ALU_4.kicad_sch, scamp++.kicad_pcb, scamp++.kicad_sch, scamp++_alu.kicad_sch, scampplusplus.circ]
2026-09-15 variable push/pop, wip tbsz/sb
    [scampplusplus.circ]
2026-09-16 shift right done, rel jump, WIP summing list
    [scampplusplus.circ]
2026-09-20 test code complete
    [scampplusplus.circ]
2026-09-20 support for interrupt. still clobers
    [scampplusplus.circ]
2026-09-21 alternate x/y/f for interrupt resume
    [scampplusplus.circ]
2026-09-24 add template circuits
    [scamp32-alu.kicad_pcb, scamp32-alu.kicad_sch, scamp32-memory-controller.kicad_pcb, scamp32-memory-controller.kicad_sch, scamp32-memory.kicad_pcb, scamp32-memory.kicad_sch, scamp32-pc.kicad_pcb, scamp32-pc.kicad_sch]
2026-10-10 template and memory board
